SkenHub/2023_Robocon_Bteam/README.md

# 2023_Robocon_Bteam
2023年高専ロボコン「もぎもぎ！フルーツＧＯラウンド」Bチーム
## メンバー
*  機械　ヒロハタ，金子，入谷，斉藤，神鍋 ,今井
*  制御　野口，川崎，笹渕，川口，黒住，佐谷  
*  回路　中井，岩井　
*  1年　北嶋，真志取  
* メイン：野口、川崎，金子
* ピット：渡邉，入谷，北嶋，廣畑，真志取
