SkenHub/2023_Robocon_Bteam/制御/robocon2023_BteamRobot/inc/sken_library/readme(pdf)/gpio.pdf

# gpio

## GPIOピンの⼊出⼒をあつかう

# enum Mode

## ⼊出⼒の設定

# enum PinState

## ⼊出⼒状態

# class Gpio

# void Gpio::init(Pin pin,Mode pin_mode)

## ピンの⼊出⼒設定 デジタル出⼒とデジタル⼊⼒の設定で使⽤する． [パラメータ] ピン番号 ⼊出⼒の設定

## [戻り値]

なし

## [サンプルコード] A5ピンをデジタル出⼒に設定する

LOW
HIGH

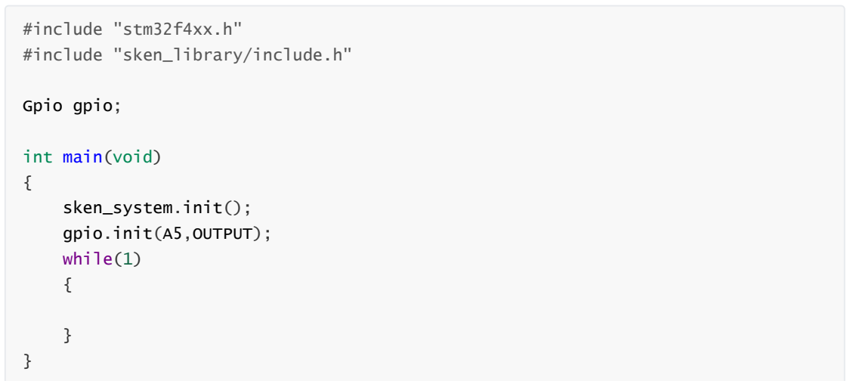
[picture p6: figure]
#include "stm32f4xx.h"; #include "sken_library/include.h"; Gpio gpio;; int main(void); sken_system.init();; gpio.init(A5,OUTPUT);; while(1)

# void Gpio::init(Pin pin,Mode pin_mode,TimerNumber tim_num,TimerChannel tim_ch,int frequency = 16800)

## ピンの⼊出⼒設定 PWM出⼒の設定で使⽤する．

## [パラメータ] ピン番号 ⼊出⼒の設定 タイマー番号 タイマーチャンネル

## PWM周波数

## [戻り値]

なし

## [サンプルコード] A5ピンをPWM出⼒に設定する

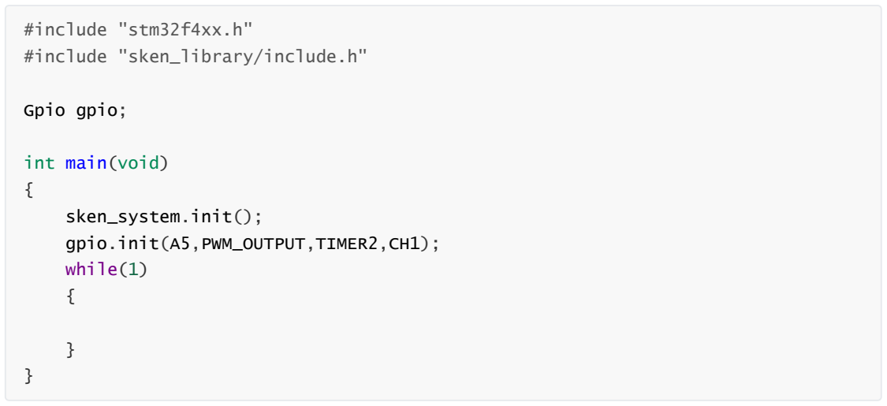
[picture p7: figure]
#include "stm32f4xx.h"; #include "sken_library/include.h"; Gpio gpio;; int main(void); sken_system.init();; gpio.init(A5,PWM_OUTPUT,TIMER2,CH1);; while(1)

# void Gpio::write(PinState state)

## 出⼒に設定している場合，ピンからHIGHまたはLOWを出⼒することができる

## [パラメータ] 出⼒状態 [戻り値]

なし

## [サンプルコード] A5ピンをデジタル出⼒に設定し，HIGHを出⼒する

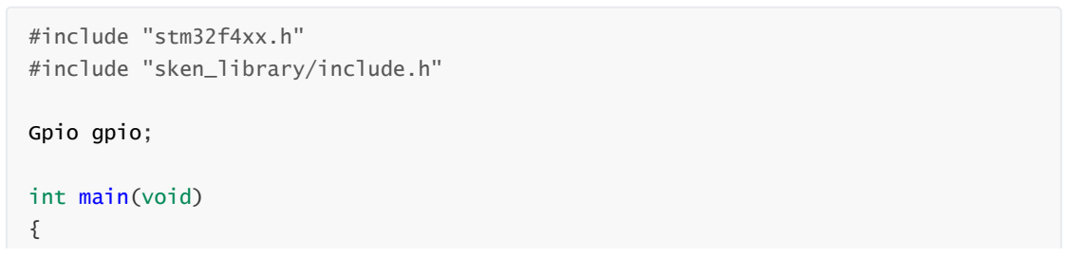
[picture p8: figure]
#include "stm32f4xx.h"; #include "sken_library/include.h"; Gpio gpio;; int main(void)

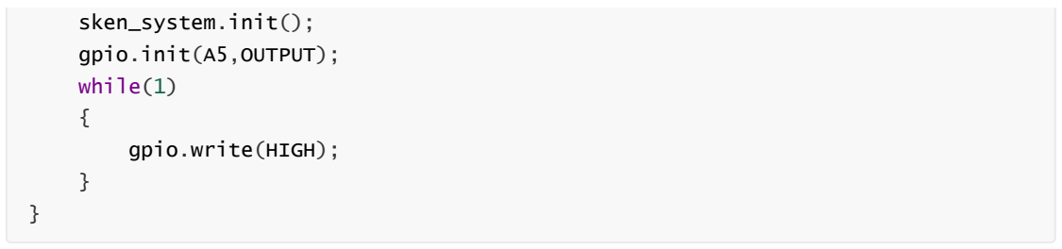
[picture p9: figure]
sken_system.init();; gpio.init(A5,OUTPUT);; while(1); gpio.write(HIGH);

# void Gpio::write(double percentage)

## PWM出⼒に設定されている場合矩形波が出⼒される． ただし，同じタイマーにエンコーダやRCサーボ信号を使⽤している場合はたとえチャンネルが違った としても正しい出⼒が⾏われない． [パラメータ]

出⼒[%]

## [戻り値]

なし

## [サンプルコード] A5ピンから50%のPWMを出⼒する

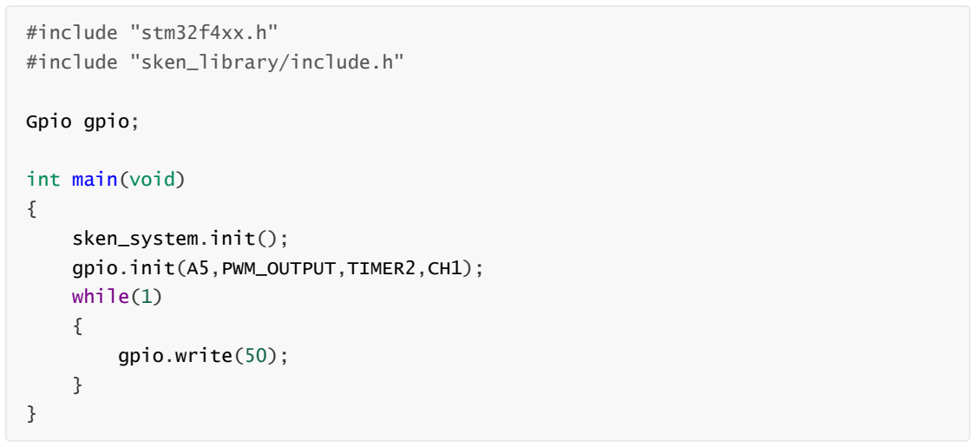
[picture p10: figure]
#include "stm32f4xx.h"; #include "sken_library/include.h"; Gpio gpio;; int main(void); sken_system.init();; gpio.init(A5,PWM_OUTPUT,TIMER2,CH1);; while(1); gpio.write(50);

# bool Gpio::read(void)

## ⼊⼒に設定している場合，ピンの値を読み取ることができる

## [パラメータ]

なし

## [戻り値]

## HIGHのときtrue，LOWのときfalse

## [サンプルコード] C13ピンに接続したスイッチを読む

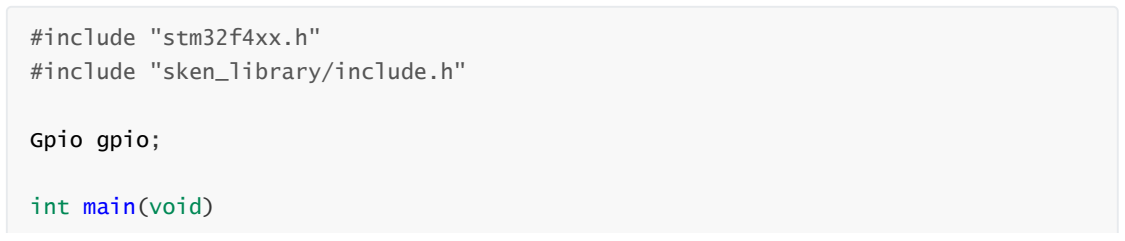
[picture p11: figure]
#include "stm32f4xx.h"; #include "sken_library/include.h"; Gpio gpio;; int main(void)

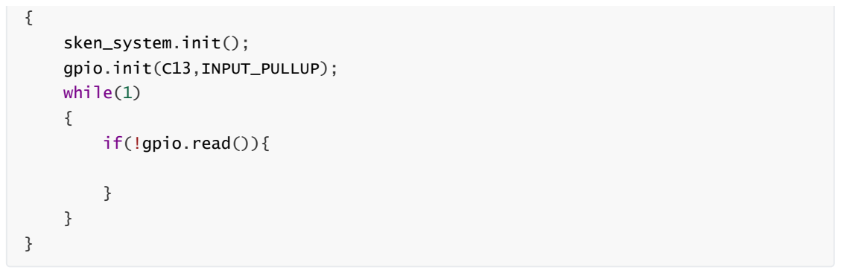
[picture p12: figure]
sken_system.init();; gpio.init(C13,INPUT_PULLUP);; while(1); if(!gpio.read()){
