SkenHub/2023_Robocon_Bteam/制御/robocon2023_BteamRobot/inc/sken_library/readme(pdf)/gyro.pdf

# gyro

## R6093ジャイロを扱うクラス

# enum Cordinate{

}

# struct gyro_data_t{

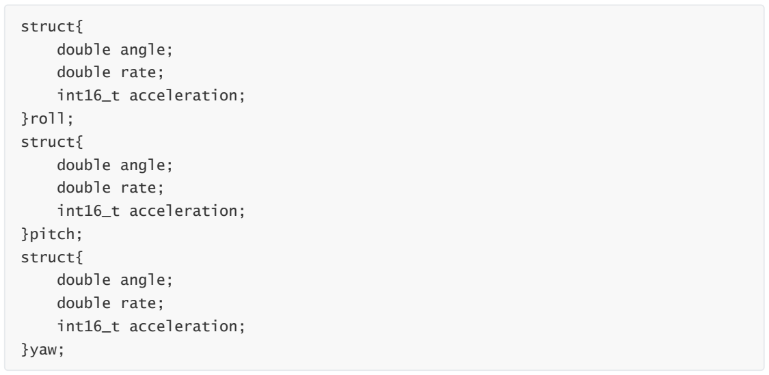
[picture p13: figure]
struct{; double angle;; double rate;; int16_t acceleration;; }roll;; }pitch;; }yaw;

}

# class Gyro

# void Gyro::init(Pin tx_pin,Pin rx_pin,UartNumber uart_num,int connect_dead_time = 1000)

## シリアルピンの設定を⾏う [パラメータ] 送信ピン番号 受信ピン番号 シリアル番号 通信切断時間

## [戻り値]

なし

## [サンプルコード]

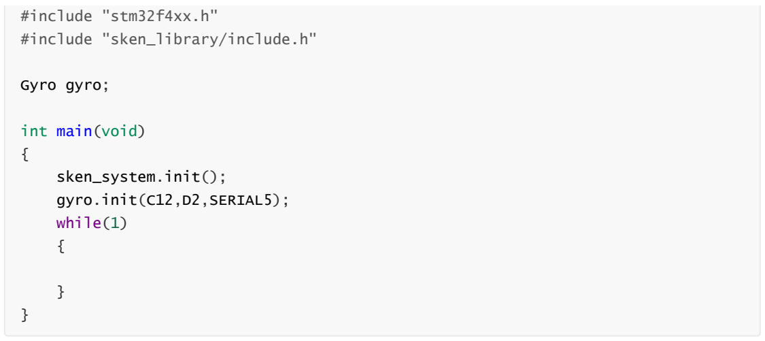
[picture p14: figure]
#include "stm32f4xx.h"; #include "sken_library/include.h"; Gyro gyro;; int main(void); sken_system.init();; gyro.init(C12,D2,SERIAL5);; while(1)

# bool Gyro::update(void)

## ジャイロからのデータを更新する [パラメータ]

なし

## [戻り値] 成功したらtrue，失敗したらfalse [サンプルコード]

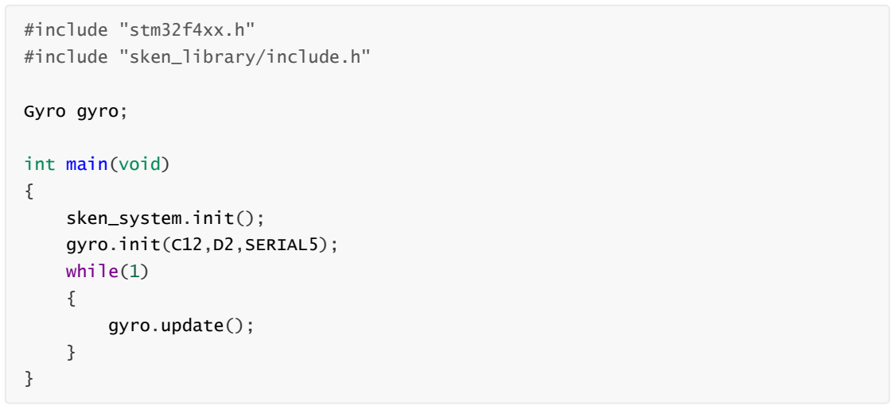
[picture p15: figure]
#include "stm32f4xx.h"; #include "sken_library/include.h"; Gyro gyro;; int main(void); sken_system.init();; gyro.init(C12,D2,SERIAL5);; while(1); gyro.update();

# bool Gyro::resetAngle(Cordinate coordinate)

## ジャイロの⾓度を0度にリセットする

## [パラメータ] リセットする軸 [戻り値] 成功したらtrue，失敗したらfalse [サンプルコード] 1秒ごとにロール軸をリセットする

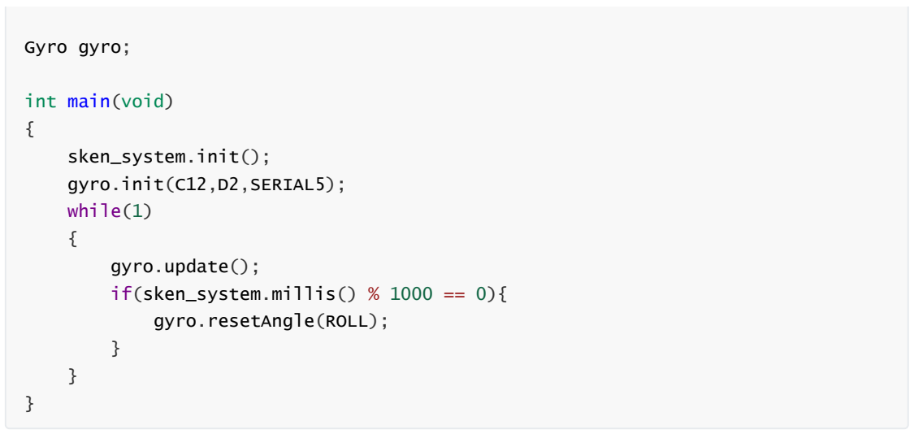
[picture p16: figure]
Gyro gyro;; int main(void); sken_system.init();; gyro.init(C12,D2,SERIAL5);; while(1); gyro.update(); if(sken_system.millis() % 1000 == 0){; gyro.resetAngle(ROLL);

# bool Gyro::getConnectFlag(void)

## 接続確認フラグを取得する [パラメータ]

なし

## [戻り値] 接続していたらtrue，接続していなかったらfalse [サンプルコード]

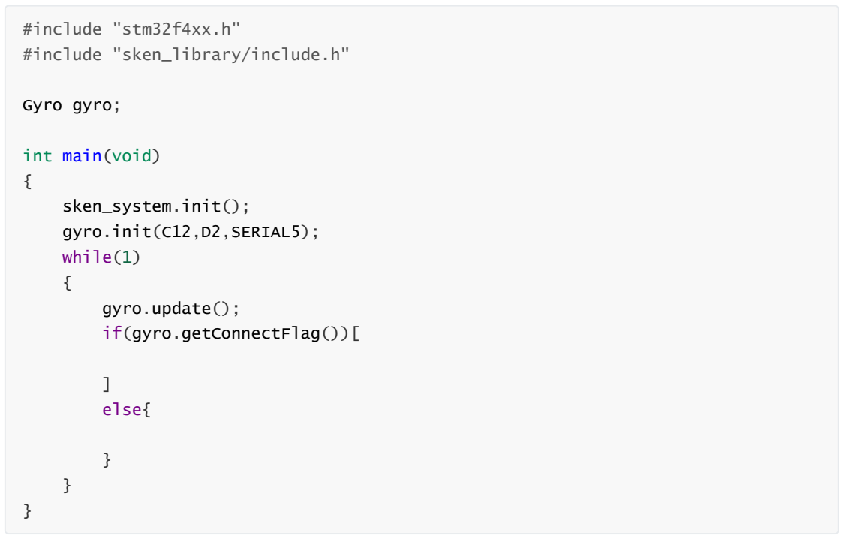
[picture p17: figure]
#include "stm32f4xx.h"; #include "sken_library/include.h"; Gyro gyro;; int main(void); sken_system.init();; gyro.init(C12,D2,SERIAL5);; while(1); gyro.update(); if(gyro.getConnectFlag())[; else{

# gyro_data_t Gyro::getData(void)

## ⾓度等のデータを取得する

## [パラメータ]

なし

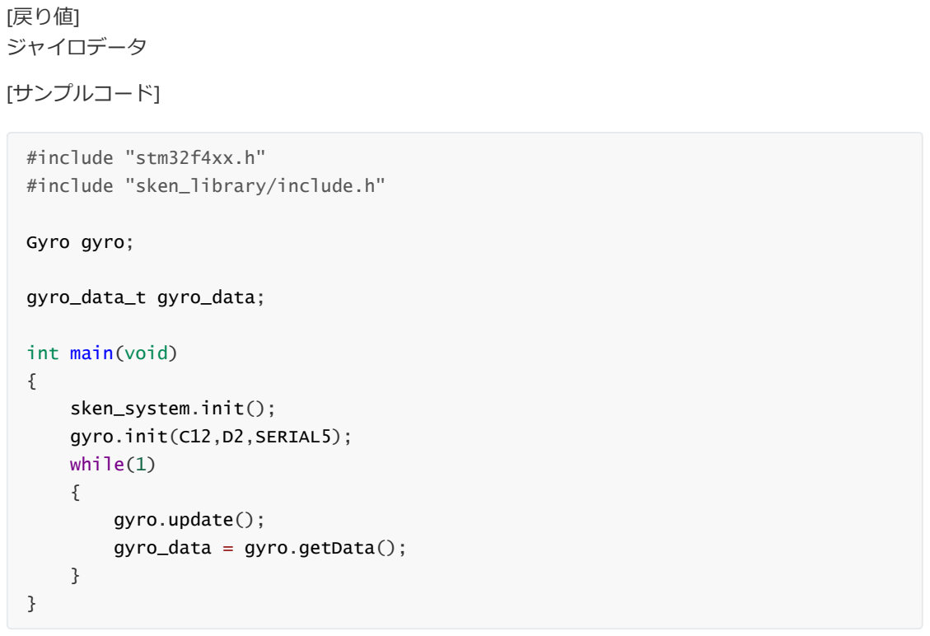
[picture p18: figure]
[戻り値] ジャイロデータ; [サンプルコード]; #include "stm32f4xx.h"; #include "sken_library/include.h"; Gyro gyro;; gyro_data_t gyro_data;; int main(void); sken_system.init();; gyro.init(C12,D2,SERIAL5);; while(1); gyro.update();; gyro_data = gyro.getData();
