SkenHub/2023_Robocon_Bteam/制御/robocon2023_BteamRobot/inc/sken_library/readme(pdf)/rc_pwm.pdf

# rc_pwm

## 周期20[ms]のラジコンサーボ信号を制御するクラス．

# class RcPwm

# void RcPwm::init(Pin pin,TimerNumber tim_num,TimerChannel tim_ch)

## ピンとタイマーの設定を⾏う [パラメータ] ピン番号 タイマー番号 タイマーチャンネル

## [戻り値]

なし

## [サンプルコード]

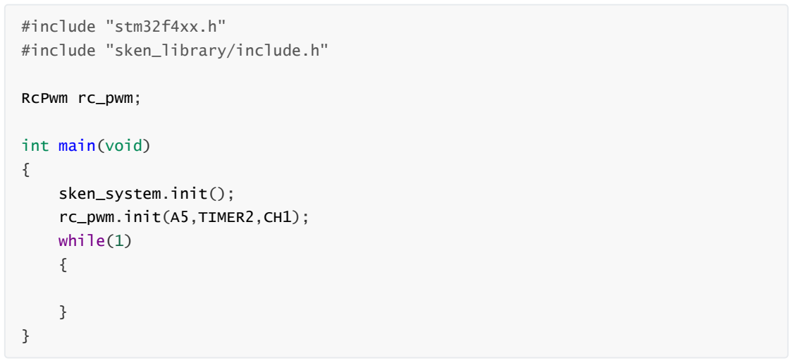
[picture p32: figure]
#include "stm32f4xx.h"; #include "sken_library/include.h"; RcPwm rc_pwm;; int main(void); sken_system.init();; rc_pwm.init(A5,TIMER2,CH1);; while(1)

# void RcPwm::turn(double percentage)

## 出⼒の割合を設定する関数

## [パラメータ]

## 出⼒割合(1000[us]から2000[us]の間を0[%]から100[%]で設定)

## [戻り値]

なし

## [サンプルコード]

## 20[%] (1200[us])で出⼒する

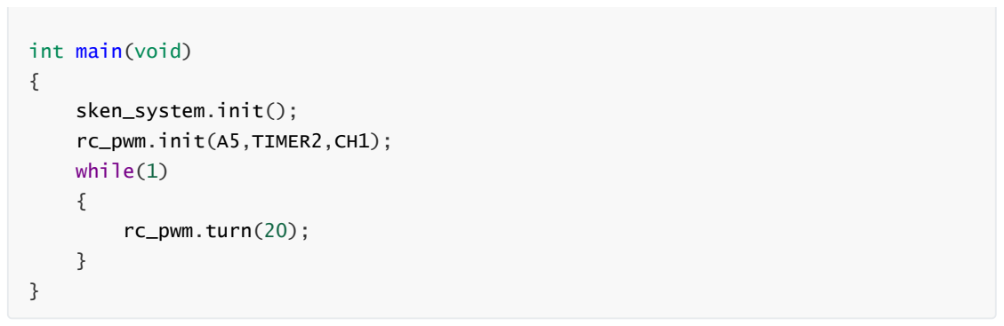
[picture p33: figure]
int main(void); sken_system.init();; rc_pwm.init(A5,TIMER2,CH1);; while(1); rc_pwm.turn(20);
