SkenHub/2023_Robocon_Bteam/機械/sato_90deg/90_MEC3.stp

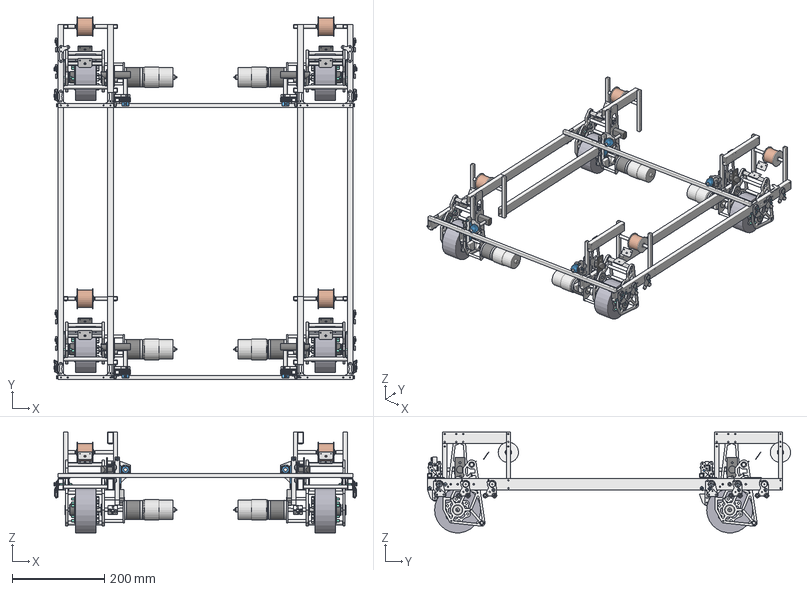
[picture p53: CAD file, 2023-06-14]
機械/sato_90deg/90_MEC3.stp
657.0 x 787.5 x 218.2 mm
25kk_1
25kk_2 x 2
T5_suraida x 4
Pr_lack x 4
9kk_suraida x 4
6_10F x 16
POM_suraido x 4
Jk8_dornob x 8
Jk6_suraida x 16
Pr_gear x 4
T3_roller x 2
T5_roller x 4
定荷重ば0 x 4
Jk8_teikajyu x 4
T5_kyapp x 12
T3_suraido x 4
T3_doanobu x 4
9kk_mota x 12
T3_roller2 x 4
ドア1 x 4
T3_doanobu2 x 4
25kk_ue x 4
Ji8_sutoppa x 4
printe_parts x 28
POM_slider2 x 4
T2_neji x 4
POM_slider x 4
sara_M4_25mm x 4
Jk6_bea x 8
Jk8_suraido x 4
T2_kado2 x 5
25kk_3 x 2
メカd x 4
T3_motor2 x 8
G2 x 4
G1 x 4
G3 x 4
RS-775 x 4
T3_motamaunt x 4
UA-20C-8X8 x 2
Jk6_mota x 12
Jk8_mota3 x 4
T2_sasae x 4
T2_sasae2 x 4
set_color8 x 4
M5_55 x 24
pp8-10_sp x 4
Jk6_2 x 8
Jk10_teikajyu x 4
定荷重ばね_3 x 4
Jk8_kaiten x 4
UA-20C-8X8_mir1 x 2
25kk_1_mir1
T3_roller_mir2 x 2
T3_roller2_mir2 x 4
T2_kado2_mir2 x 5
9kk_yoko x 2
