SkenHub/2023_Robocon_Bteam/機械/部品図/J指示書2.pdf

200 | 351 | 200
| 7.5 8.5

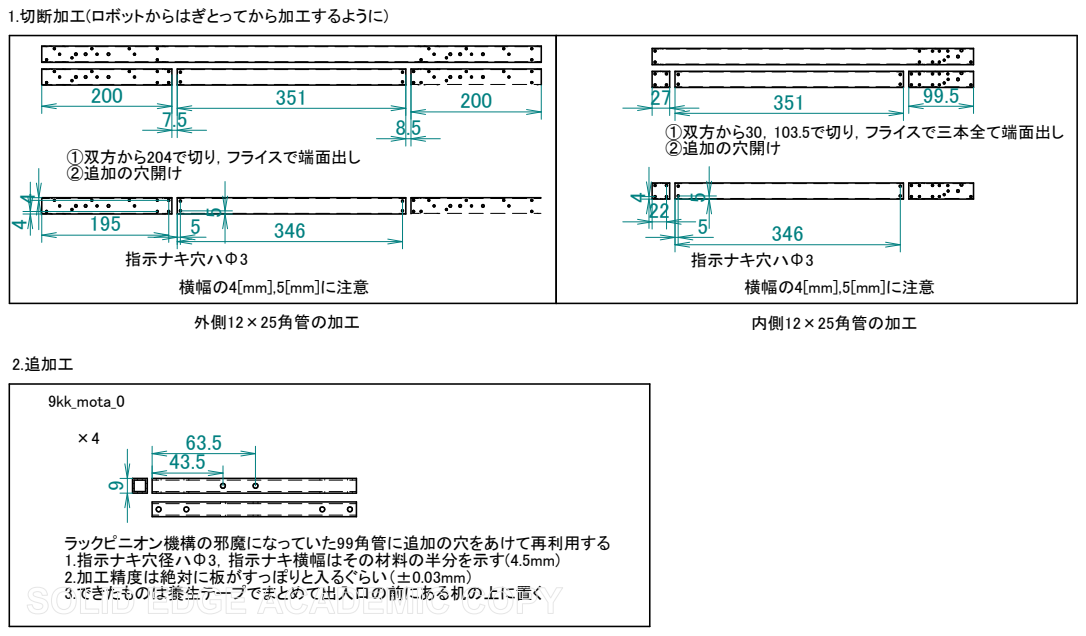
[picture p54: page 1]
1.切断加工(ロボットからはぎとってから加工するように); ①双方から204で切り，フライスで端面出し ②追加の穴開け; 指示ナキ穴ハΦ3; ①双方から30，103.5で切り，フライスで三本全て端面出し ②追加の穴開け; 外側12×25角管の加工; 内側12×25角管の加工; 2.追加工; 9kk_mota_0; ラックピニオン機構の邪魔になっていた99角管に追加の穴をあけて再利用する 1.指示ナキ穴径ハΦ3，指示ナキ横幅はその材料の半分を示す(4.5mm) 2.加工精度は絶対に板がすっぽりと入るぐらい（±0.03mm） 3.できたものは養生テープでまとめて出入口の前にある机の上に置く

横幅の4[mm],5[mm]に注意
