SkenHub/2023_Robocon_Bteam/機械/部品図/部品図J3A1.pdf

430

445

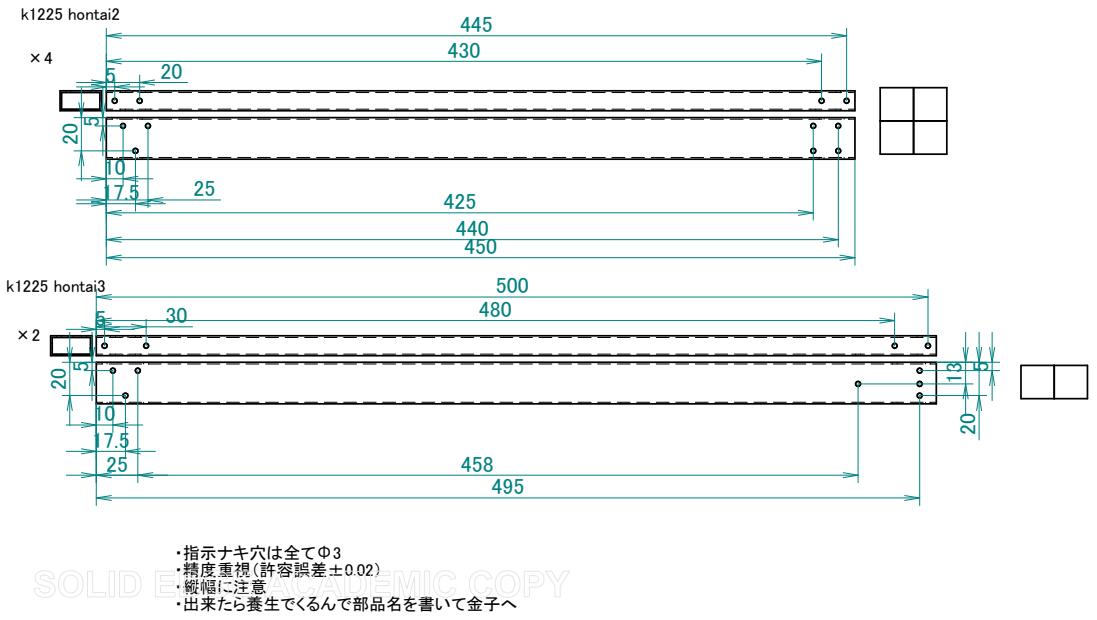
[picture p57: page 1]
k1225 hontai25; k1225 hontai35; ・指示ナキ穴は全てΦ3 ・精度重視（許容誤差±0.02） ・縦幅に注意 ・出来たら養生でくるんで部品名を書いて金子へ
