SkenHub/2023_Robocon_Bteam/機械/部品図/部品図J3A2.pdf

15

60

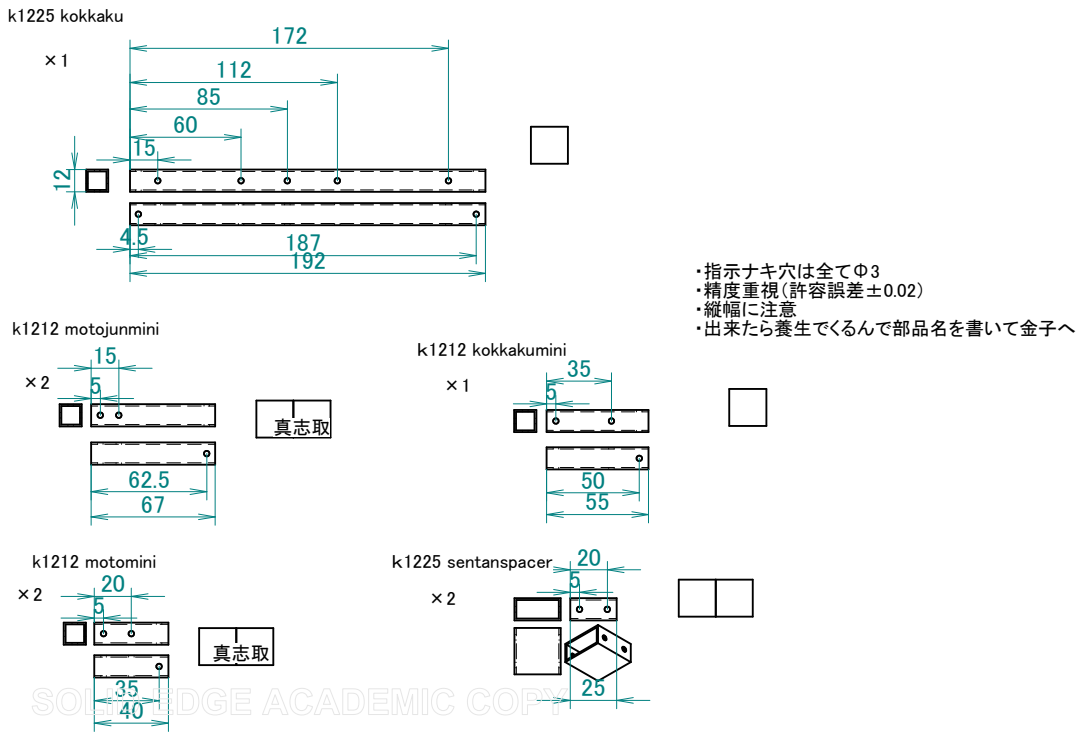
[picture p58: page 1]
k1225 kokkaku; k1212 motojunmini; ・指示ナキ穴は全てΦ3 ・精度重視（許容誤差±0.02） ・縦幅に注意 ・出来たら養生でくるんで部品名を書いて金子へ; k1212 motomini; ｋ1212 kokkakumini; ｋ1225 sentanspacer; 真志取
