SkenHub/2023_Robocon_Bteam/機械/部品図/部品図J3A3.pdf

71.5

119.6

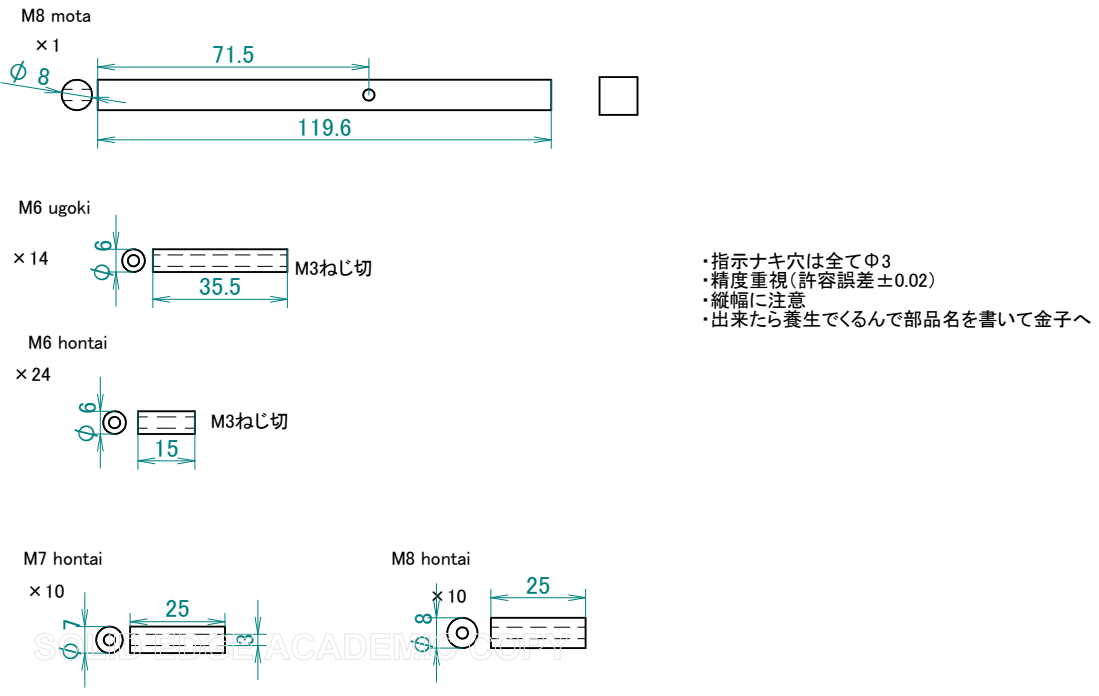
[picture p59: page 1]
M8 mota; M6 hontai; ・指示ナキ穴は全てΦ3 ・精度重視（許容誤差±0.02） ・縦幅に注意 ・出来たら養生でくるんで部品名を書いて金子へ; M7 hontai; M8 hontai; M6 ugoki; M3ねじ切
