SkenHub/2023_Robocon_Bteam/機械/部品図/J指示書3.pdf

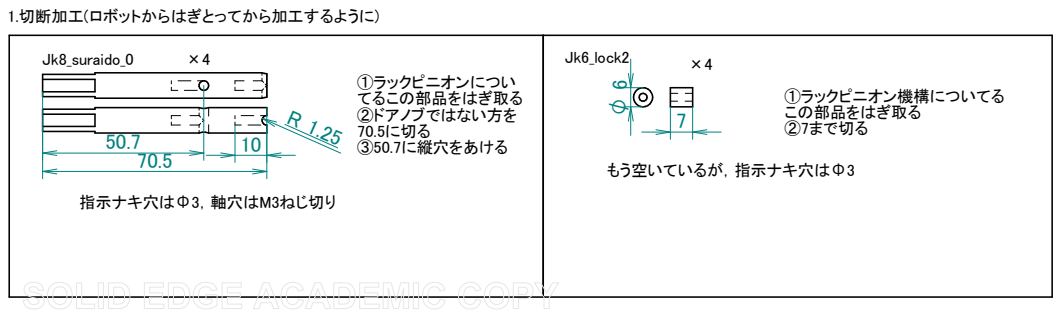
[picture p60: page 1]
1.切断加工(ロボットからはぎとってから加工するように); Jk8_suraido_0; ①ラックピニオンについ てるこの部品をはぎ取る ②ドアノブではない方を 70.5に切る ③50.7に縦穴をあける; 指示ナキ穴はΦ3，軸穴はM3ねじ切り; Jk6_lock2; ①ラックピニオン機構についてる この部品をはぎ取る ②7まで切る; もう空いているが，指示ナキ穴はΦ3
