SkenHub/2023_Robocon_Bteam/機械/部品図/J部品図1.pdf

## 95.5 O

3

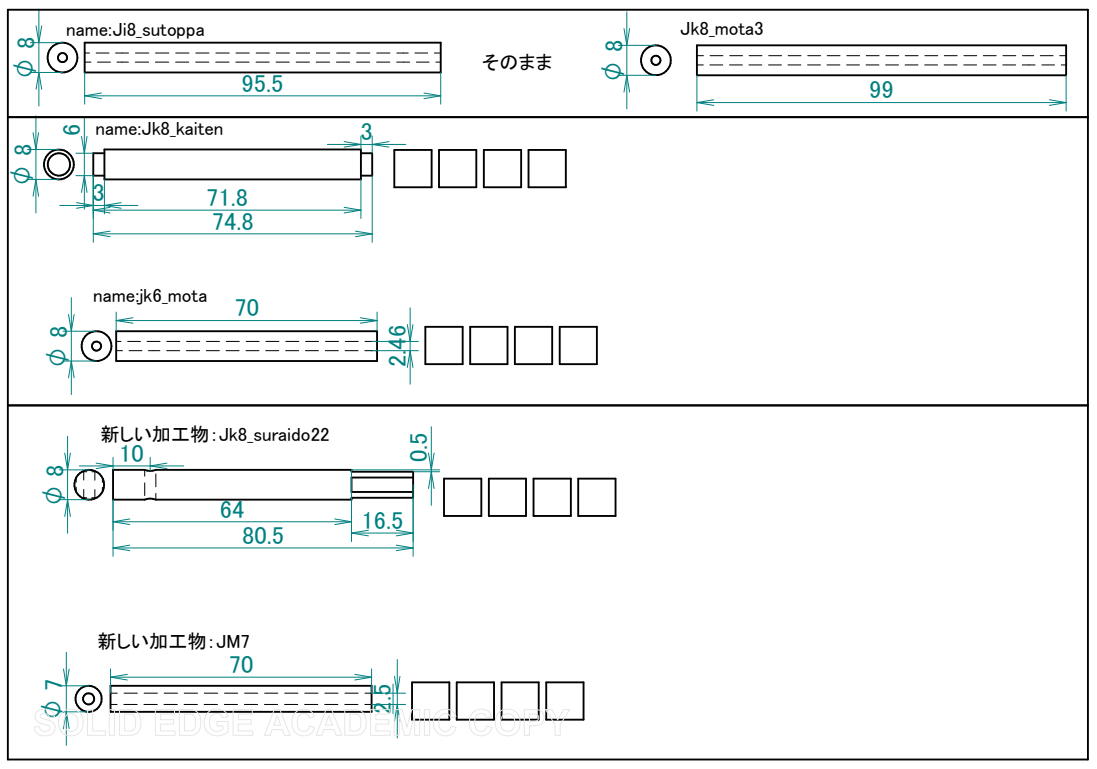
[picture p61: page 1]
name:Ji8_sutoppa; そのまま; name:Jk8_kaiten; 新しい加工物：JM7; 70 name:jk6_mota; 新しい加工物：Jk8_suraido22; Jk8_mota3
