SkenHub/2023_Robocon_Bteam/機械/部品図/9_9_2.pdf

6
21

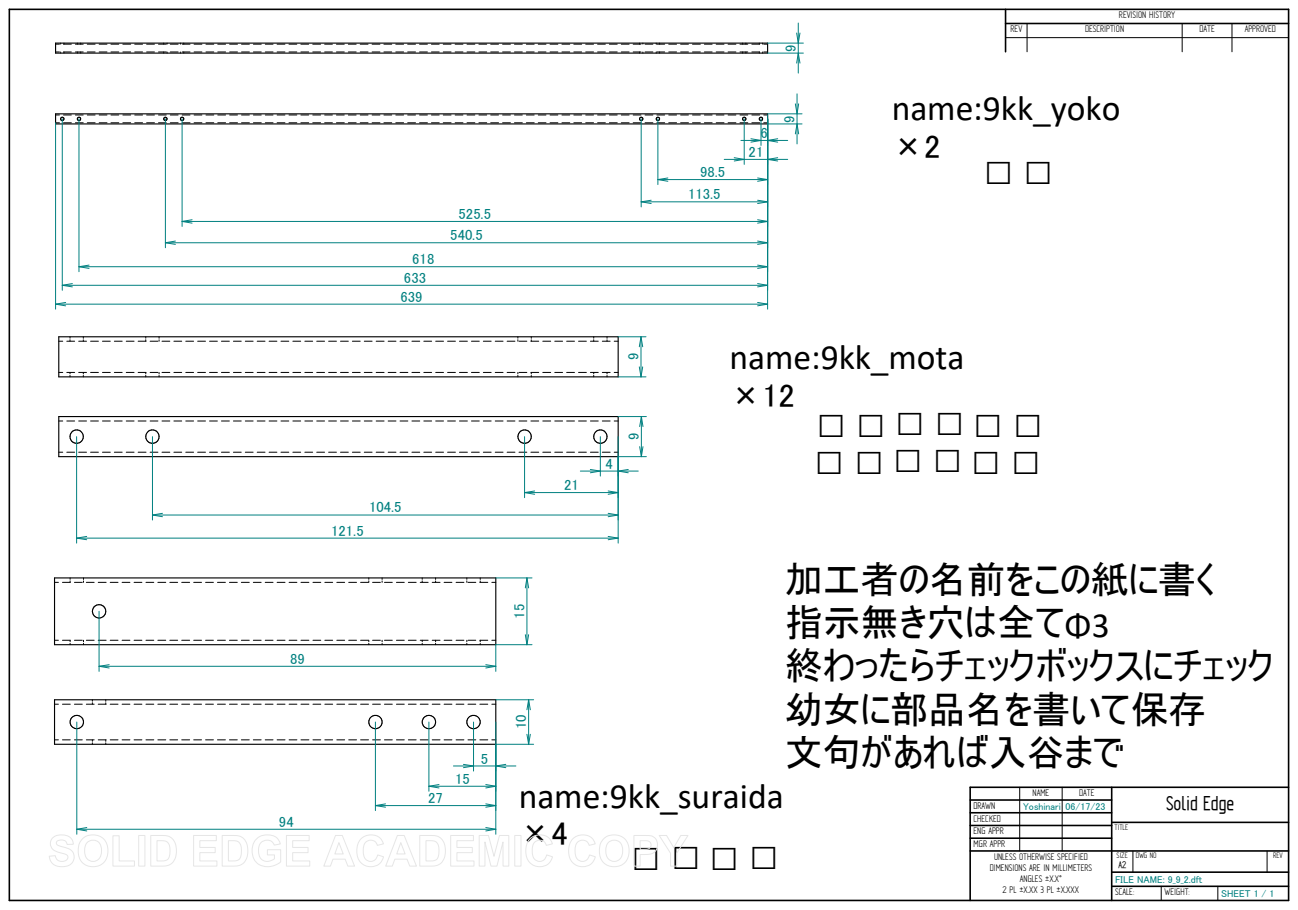
[picture p62: page 1]
NAME; DATE; Solid Edge; TITLE; SCALE:; WEIGHT:; SHEET 1 / 1; name:9kk_yoko ×2; 加加加の名名ををの紙に書く 指指指き穴は全てΦ3 終わわわわわわわわわわわわにわわわわ 幼幼に部部名を書いて保保 文文がががが入入まま; name:9kk_mota ×12; name:9kk_suraida ×4

REVISION HISTORY

REV | DESCRIPTION | DATE | APPROVED

DRAWN | Yoshinari
CHECKED
ENG APPR
MGR APPR
UNLESS OTHERWISE SPECIFIED DIMENSIONS ARE IN MILLIMETERS ANGLES ±X.X° 2 PL ±X.XX 3 PL ±X.XXX | SIZE A2 | DWG NO | REV

FILE NAME: 9_9_2.dft
