SkenHub/2023_Robocon_Bteam/機械/部品図/12_25_6.pdf

56
76

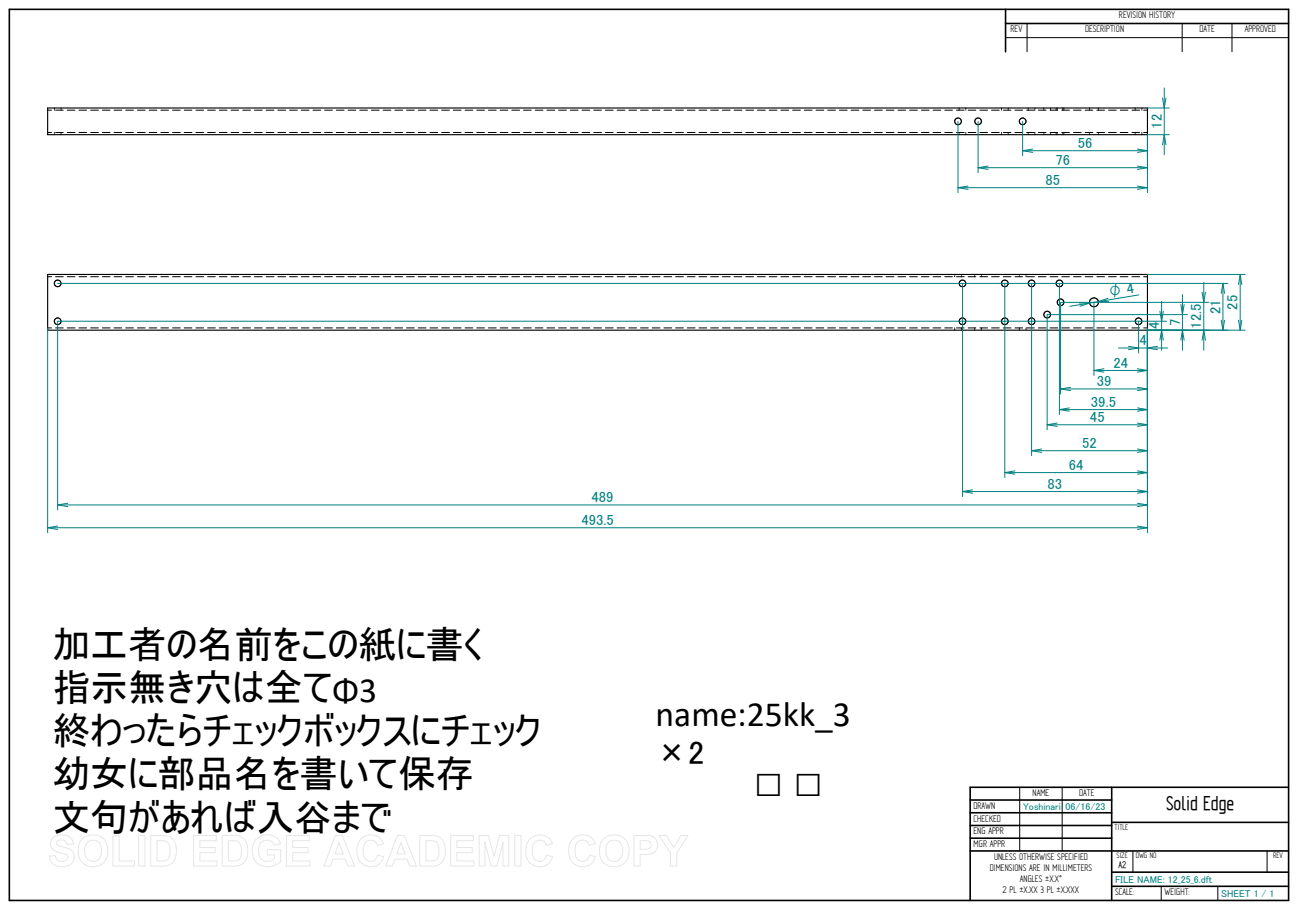
[picture p63: page 1]
TITLE; SCALE:; WEIGHT:; SHEET 1 / 1; 加加加の名名ををの紙に書く 指指指き穴は全てΦ3 終わわわわわわわわわわわわにわわわわ 幼幼に部部名を書いて保保 文文がががが入入まま; name:25kk_3 ×2

REVISION HISTORY

REV | DESCRIPTION | DATE | APPROVED

NAME | DATE 06/16/23 | Solid Edge

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

FILE NAME: 12_25_6.dft
