SkenHub/2023_Robocon_Bteam/機械/部品図/12_25_8.pdf

4.5
579.5 | 13.5 33.5

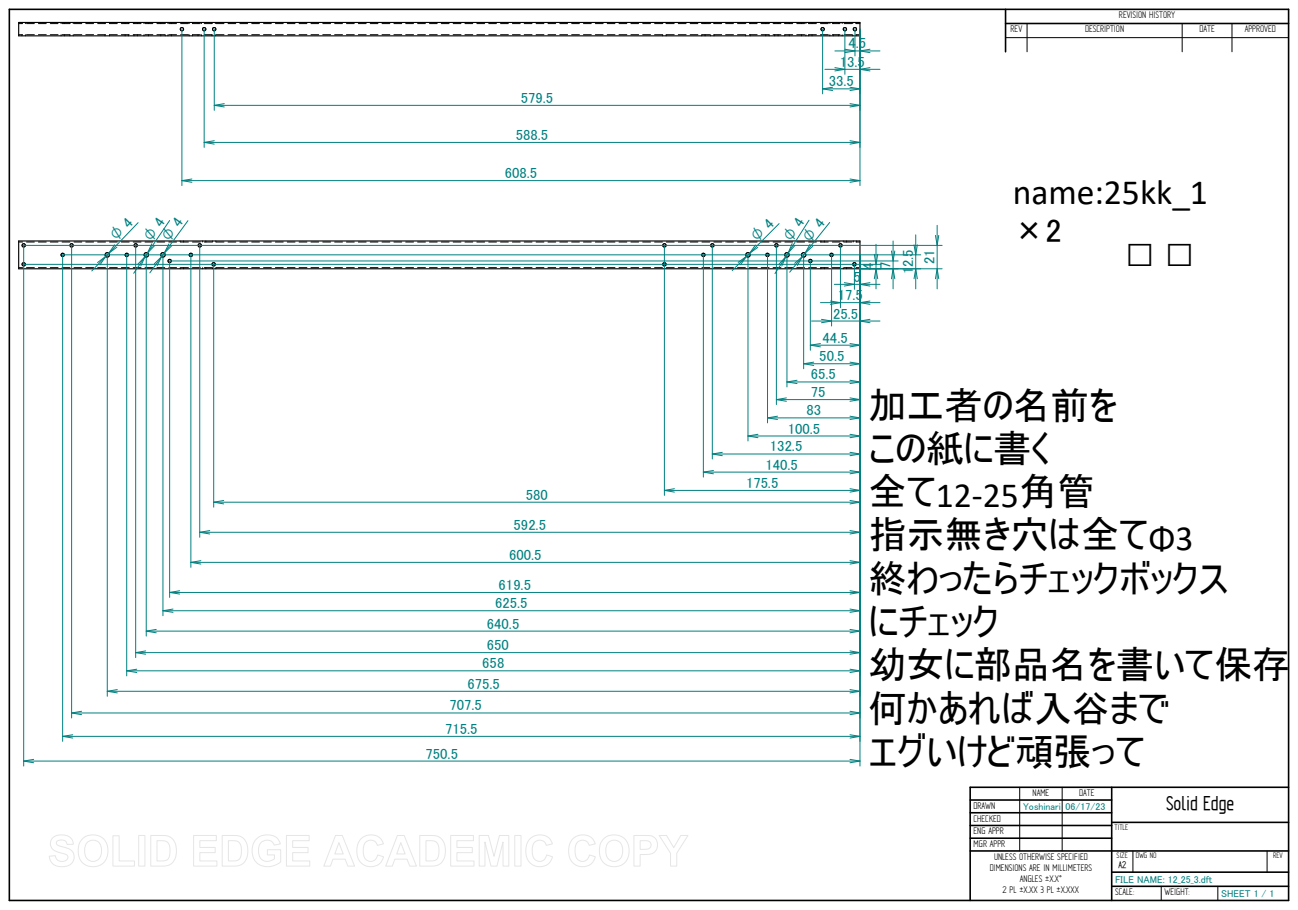
[picture p64: page 1]
TITLE; SCALE:; WEIGHT:; SHEET 1 / 1; 加加加の名名を この紙に書く; 指指指き穴は全てΦ3 終わわわわわわわわわわわわ にわわわわ 幼幼に部部名を書いて保保 何かかかか入入まま エエいエエ頑頑わて; name:25kk_1 ×2

REVISION HISTORY

REV | DESCRIPTION | DATE | APPROVED

NAME | DATE 06/17/23 | Solid Edge

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

FILE NAME: 12_25_3.dft
