SkenHub/2023_Robocon_Bteam/機械/部品図/jk6.pdf

78.5

7

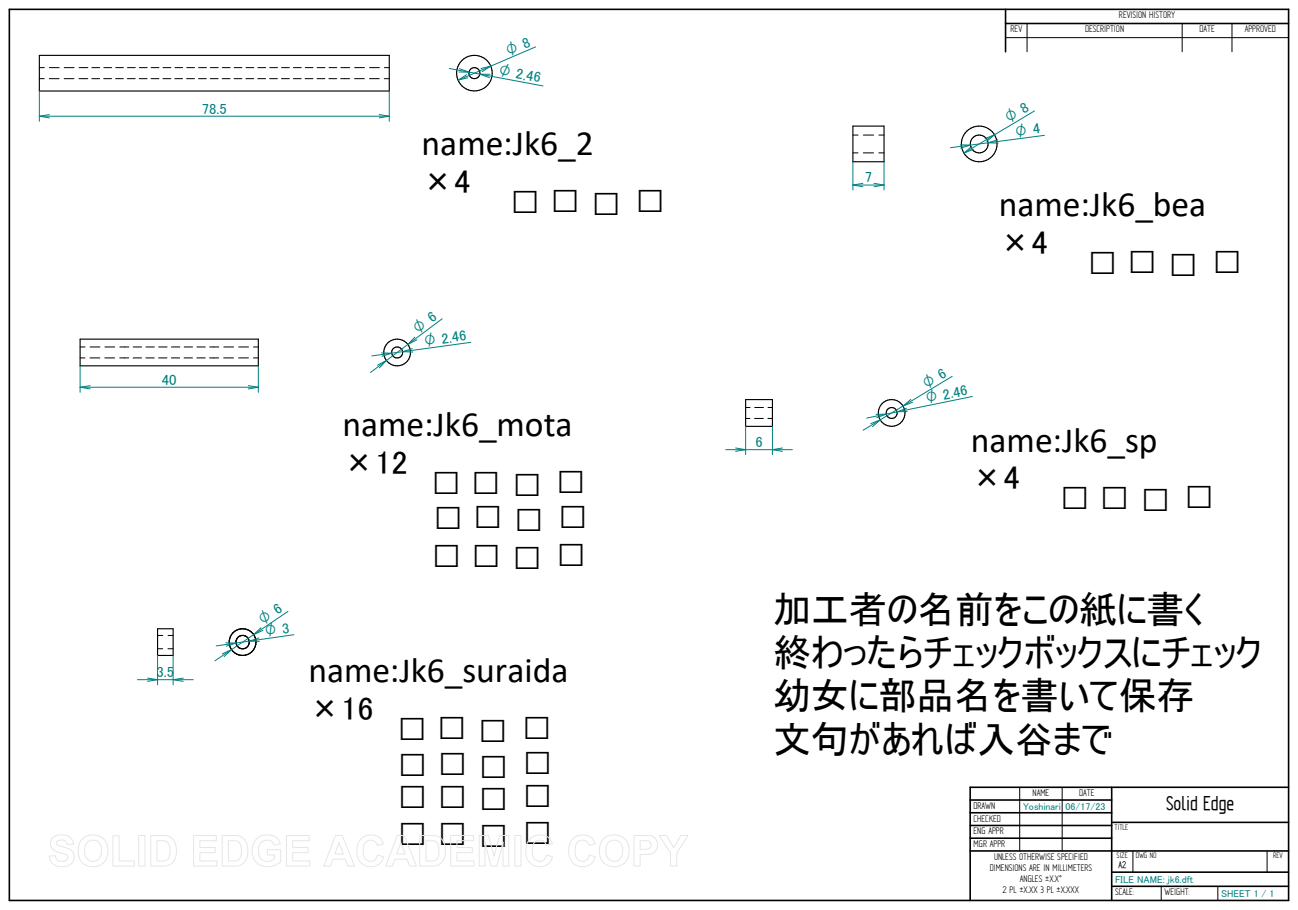
[picture p65: page 1]
TITLE; SCALE:; WEIGHT:; SHEET 1 / 1; 加加加の名名ををの紙に書く 終わわわわわわわわわわわわにわわわわ 幼幼に部部名を書いい保保 文文がががが入入まま; name:Jk6_2; name:Jk6_bea; name:Jk6_sp; name:Jk6_mota ×12 q q q q; name:Jk6_suraida ×16 q q q q

REVISION HISTORY

REV | DESCRIPTION | DATE | APPROVED

NAME | DATE 06/17/23 | Solid Edge

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

FILE NAME: jk6.dft
