SkenHub/2023_Robocon_Bteam/機械/部品図/jk8.pdf

95.5

12

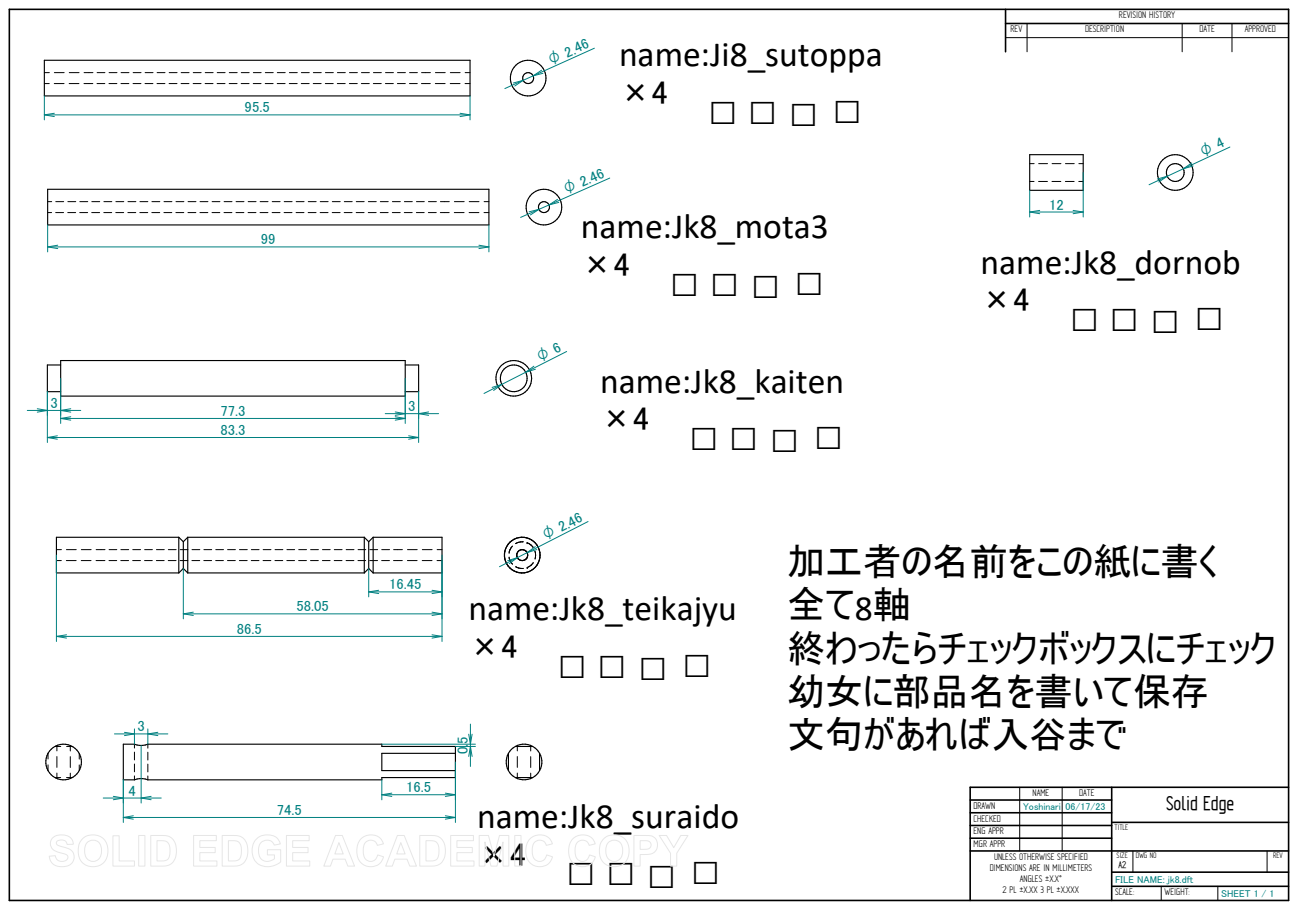
[picture p66: page 1]
TITLE; SCALE:; WEIGHT:; SHEET 1 / 1; 加加加の名名ををの紙に書く 全て 軸8 終わわわわわわわわわわわわにわわわわ 幼幼に部部名を書いて保保 文文がががが入入まま; name:Ji8_sutoppa; name:Jk8_mota3; name:Jk8_dornob ×4; name:Jk8_kaiten; name:Jk8_teikajyu; name:Jk8_suraido

REVISION HISTORY

REV | DESCRIPTION | DATE | APPROVED

NAME | DATE 06/17/23 | Solid Edge

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

FILE NAME: jk8.dft
