SkenHub/2023_Robocon_Bteam/機械/部品図/12-25_2.pdf

180
292

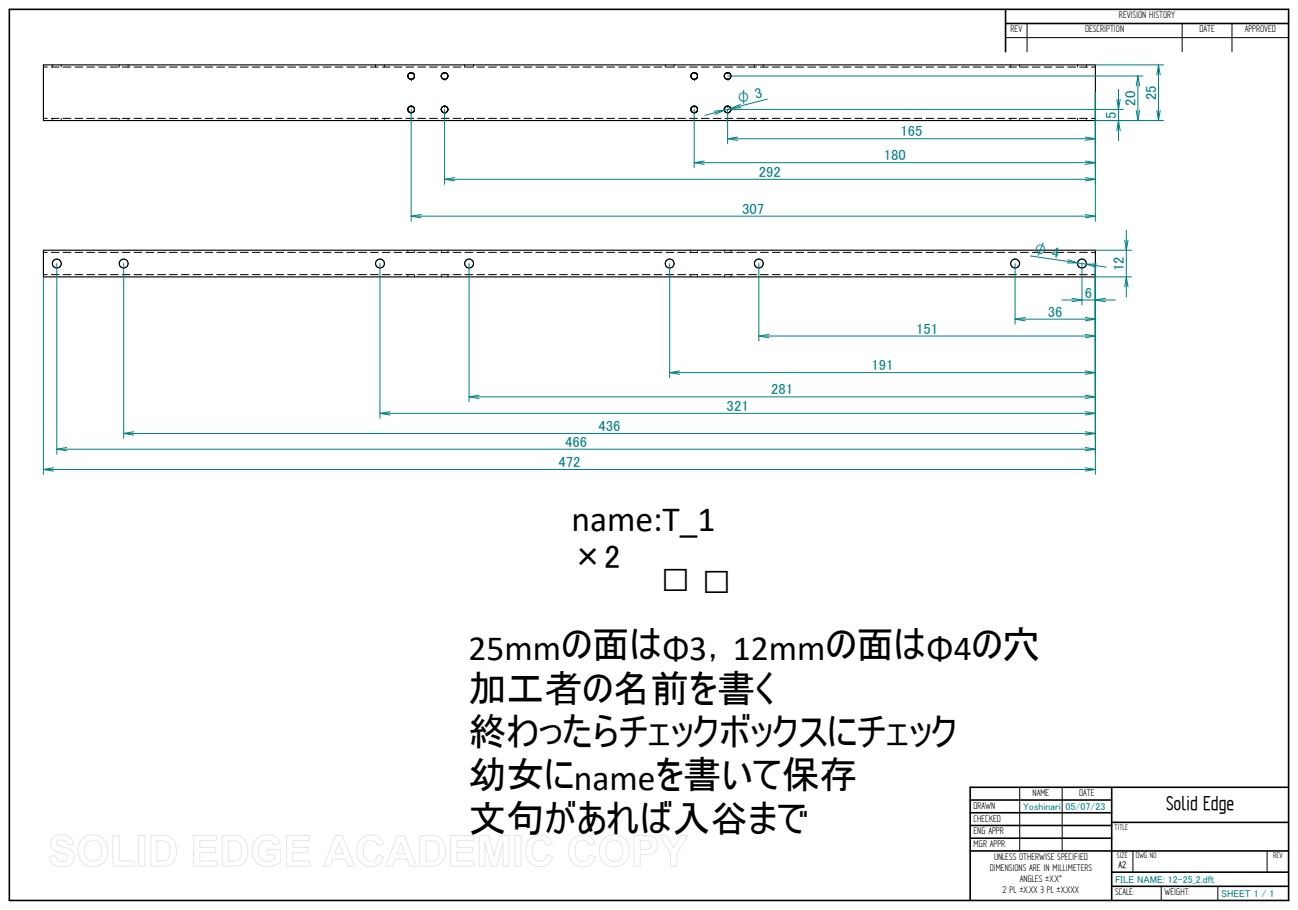
[picture p67: page 1]
TITLE; SCALE:; WEIGHT:; SHEET 1 / 1; name:T_1 ×2; Φ4 の面は ，; の面は の穴; 加加加の名名を書く 終わわわわわわわわわわわわわわわわわ; 幼幼わ; を書いい保保 name; 文文がががが入入まま

REVISION HISTORY

REV | DESCRIPTION | DATE | APPROVED

NAME | DATE 05/07/23 | Solid Edge

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

FILE NAME: 12-25_2.dft
