SkenHub/2023_Robocon_Bteam/機械/部品図/12_12.pdf

31

5

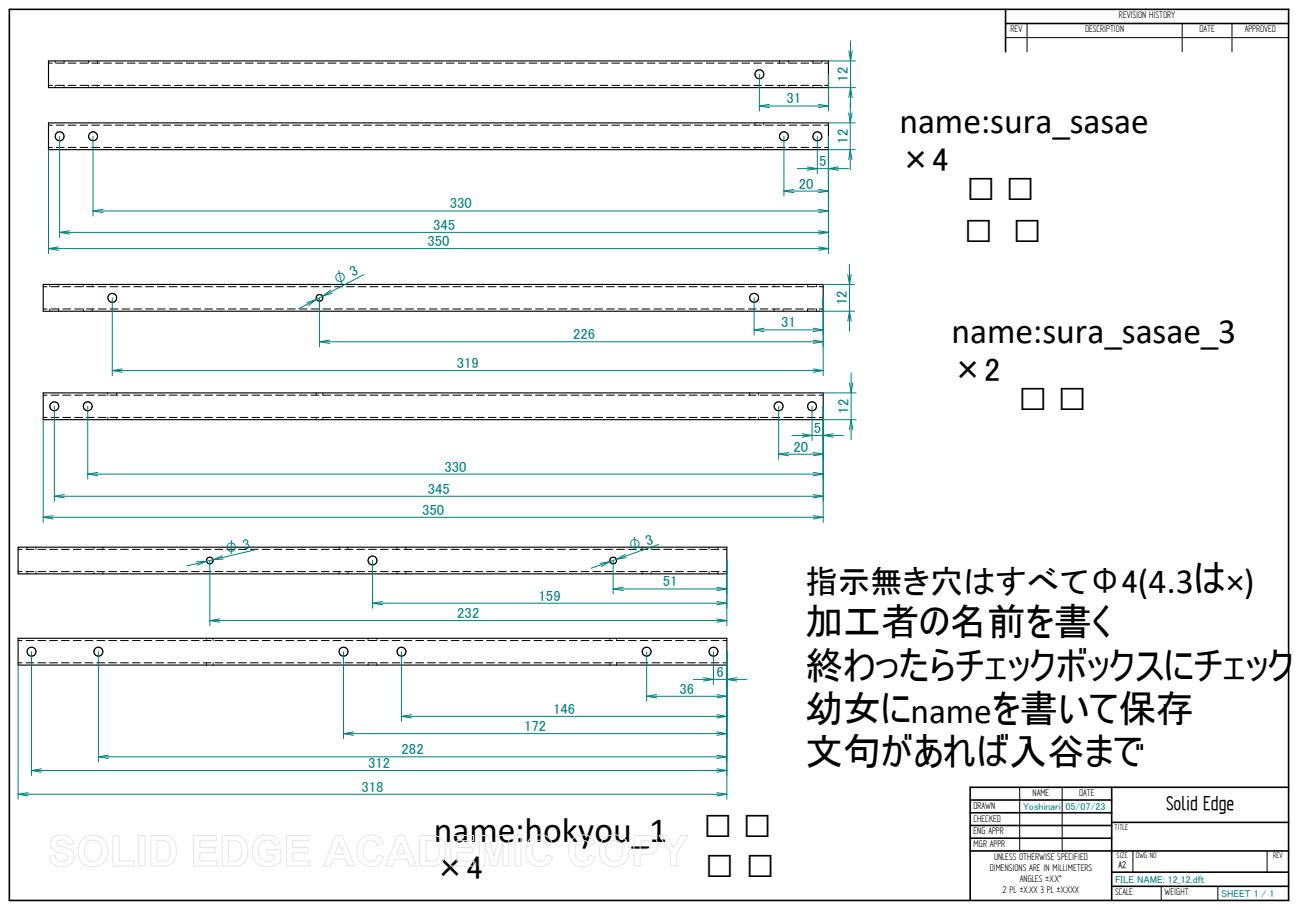
[picture p68: page 1]
TITLE; name:sura_sasae ×4; 指示無き穴はすべてΦ4(4.3 ×) は 加加加の名名を書く 終わわわわわわわわわわわわわわわわわ; 幼幼わ; を書いい保保 name; 文文がががが入入まま; name:sura_sasae_3

REVISION HISTORY

REV | DESCRIPTION | DATE | APPROVED

NAME | DATE 05/07/23 | Solid Edge

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

name:hokyou_1

FILE NAME: 12_12.dft

SCALE: | WEIGHT: | SHEET 1 / 1
