SkenHub/2023_Robocon_Bteam/機械/部品図/12_12_3.pdf

6
355.25

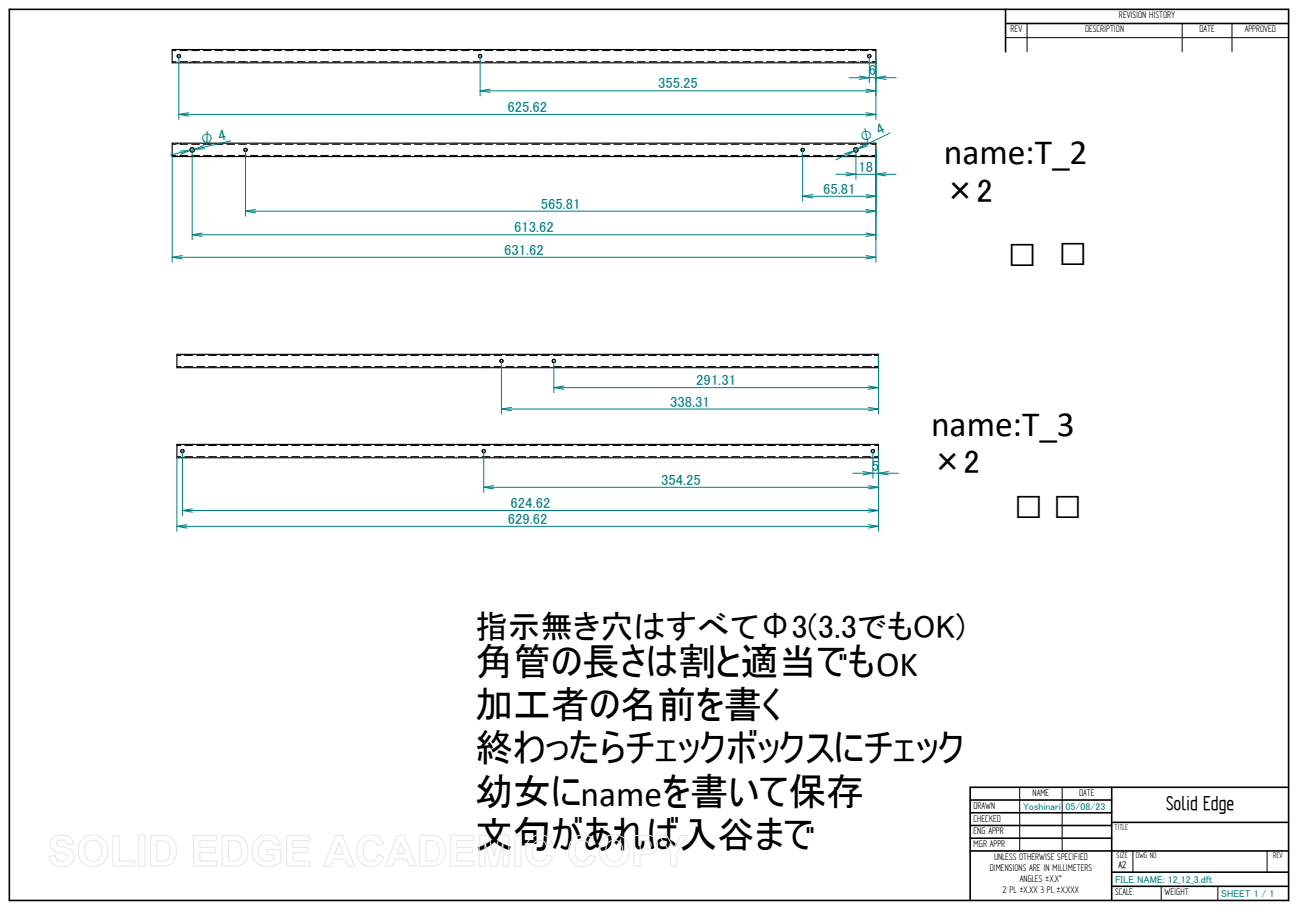
[picture p69: page 1]
TITLE; SCALE:; WEIGHT:; SHEET 1 / 1; 指示無き穴はすべてΦ3(3.3でもOK) 角角の長ささ割と適適ででOK 加加加の名名を書く 終わわわわわわわわわわわわわわわわわ; 幼幼わ; を書いい保保 name; 文文がががが入入まで; name:T_3 ×2; name:T_2 ×2

REVISION HISTORY

REV | DESCRIPTION | DATE | APPROVED

NAME | DATE 05/08/23 | Solid Edge

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

FILE NAME: 12_12_3.dft
