SkenHub/2023_Robocon_Bteam/機械/部品図/12_25.pdf

6
87

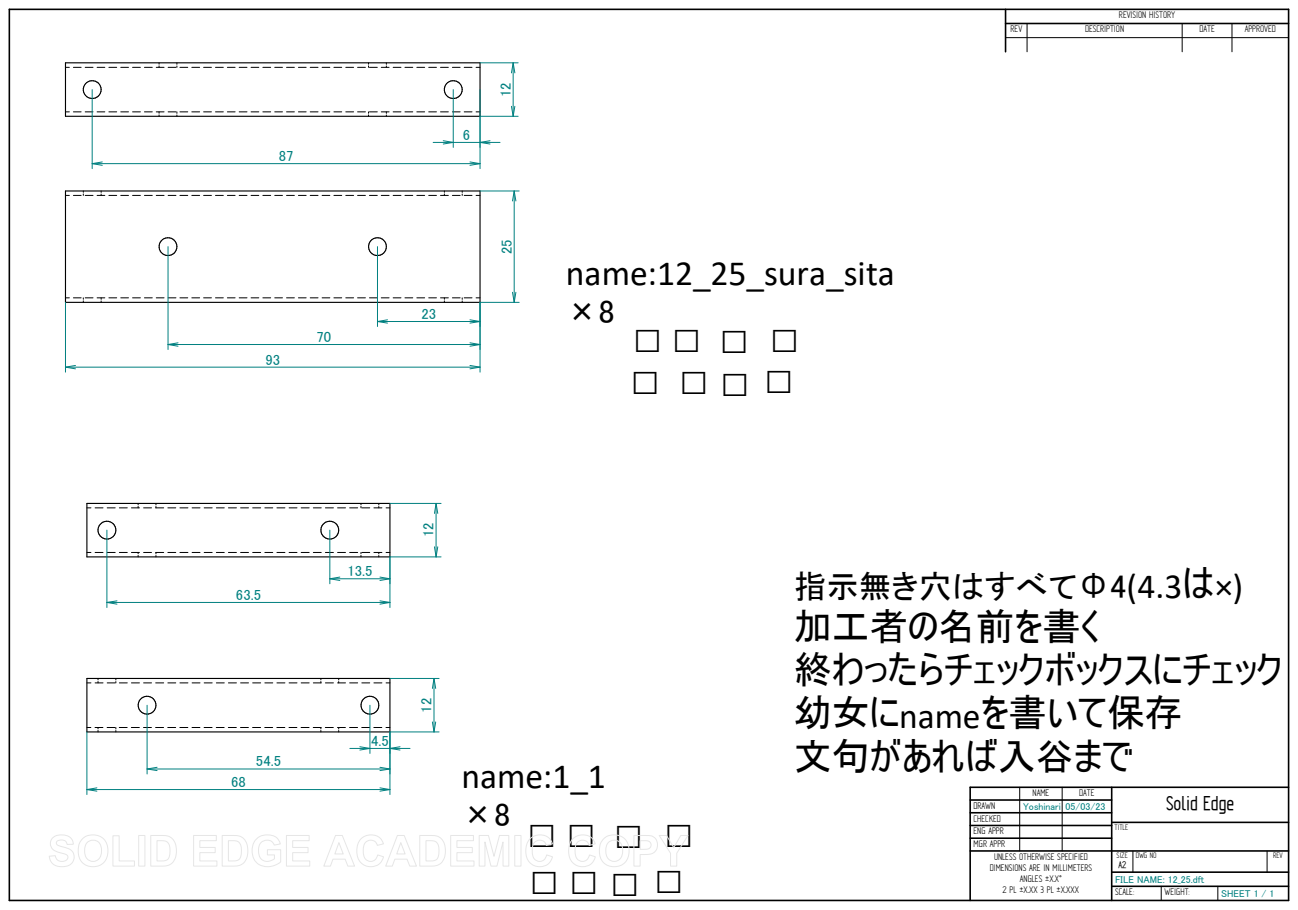
[picture p70: page 1]
TITLE; SCALE:; WEIGHT:; SHEET 1 / 1; 指示無き穴はすべてΦ4(4.3 ×) は 加加加の名名を書く 終わわわわわわわわわわわわわわわわわ; 幼幼わ; を書いい保保 name; 文文がががが入入まま; name:12_25_sura_sita ×8; name:1_1 ×8

REVISION HISTORY

REV | DESCRIPTION | DATE | APPROVED

NAME | DATE 05/03/23 | Solid Edge

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

FILE NAME: 12_25.dft
