SkenHub/2023_Robocon_Bteam/機械/部品図/12_25_4.pdf

18
99

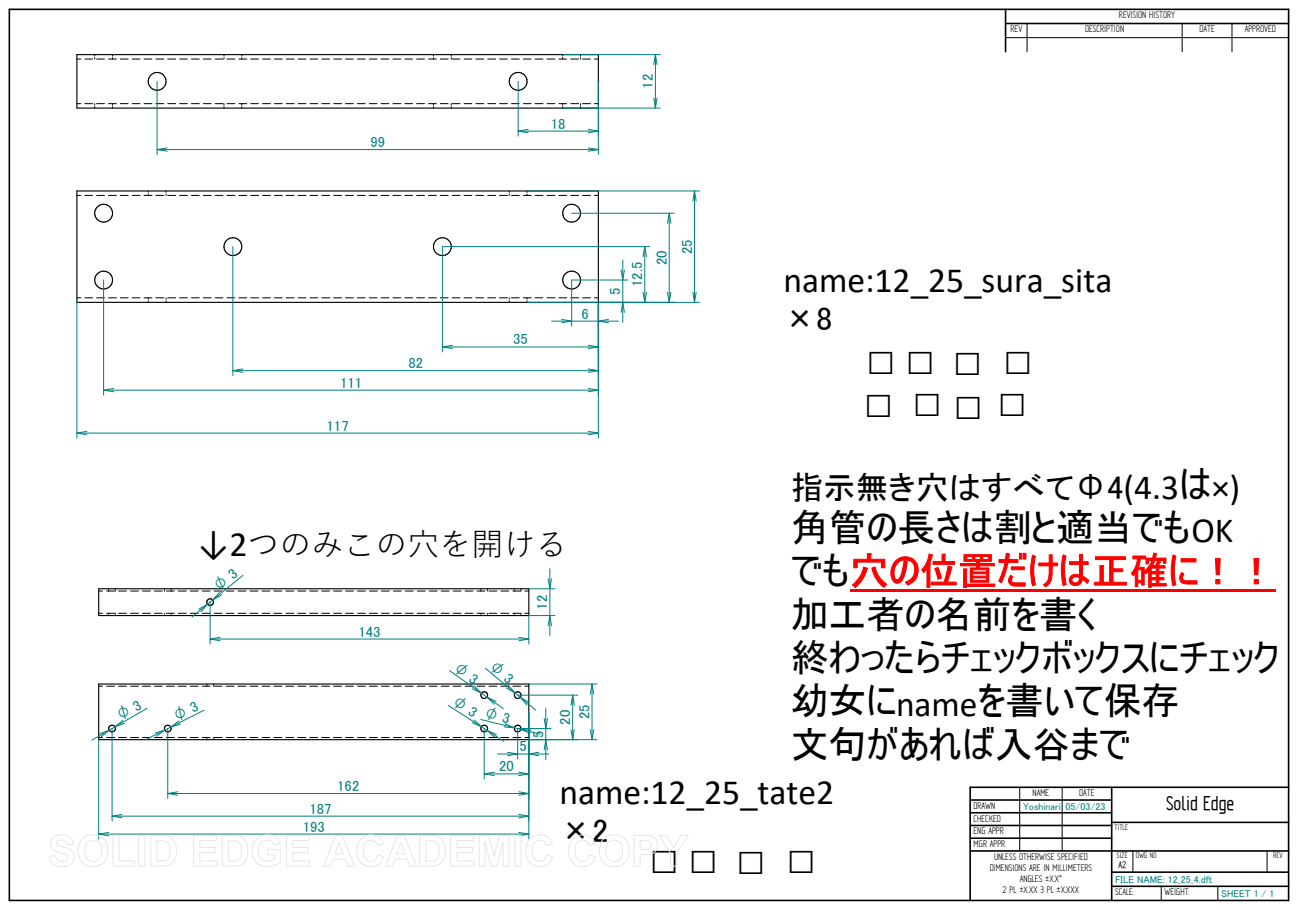
[picture p71: page 1]
TITLE; SCALE:; WEIGHT:; SHEET 1 / 1; 指示無き穴はすべてΦ4(4.3 ×) は 角角の長さは割と適適ででOK でで穴の位位だだは正正に！！ 加加加の名名を書く 終わわわわわわわわわわわわにわわわわ; 幼幼に; を書いい保保 name; 文文がががが入入まで; name:12_25_sura_sita ×8; ↓2つのみこの穴を開ける; name:12_25_tate2 ×2

REVISION HISTORY

REV | DESCRIPTION | DATE | APPROVED

NAME | DATE 05/03/23 | Solid Edge

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

FILE NAME: 12_25_4.dft
