SkenHub/2023_Robocon_Bteam/機械/部品図/12_25_5.pdf

16.5
61.5

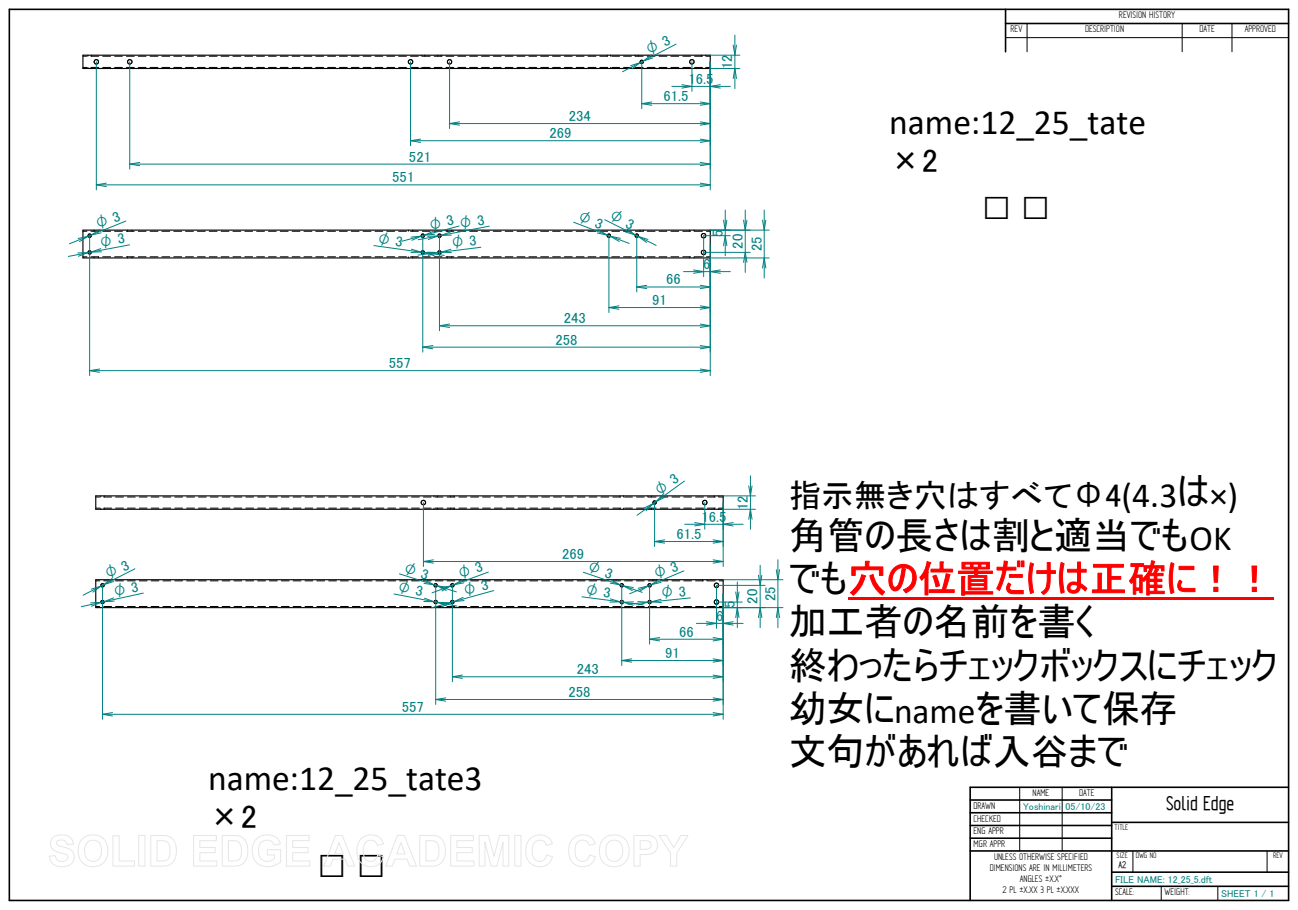
[picture p72: page 1]
TITLE; SCALE:; WEIGHT:; SHEET 1 / 1; 12指示無き穴はすべてΦ4(4.3 ×) は 角角の長さは割と適適ででOK でで穴の位位だだは正正に！！ 加加加の名名を書く 終わわわわわわわわわわわわにわわわわ; 幼幼に; を書いい保保 name; 文文がががが入入まで name:12_25_tate3; name:12_25_tate ×2

REVISION HISTORY

REV | DESCRIPTION | DATE | APPROVED

NAME | DATE 05/10/23 | Solid Edge

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

FILE NAME: 12_25_5.dft
