SkenHub/2023_Robocon_Bteam/機械/部品図/9_9.pdf

22.5

## 片方にΦ6，もう片方にΦ3の穴

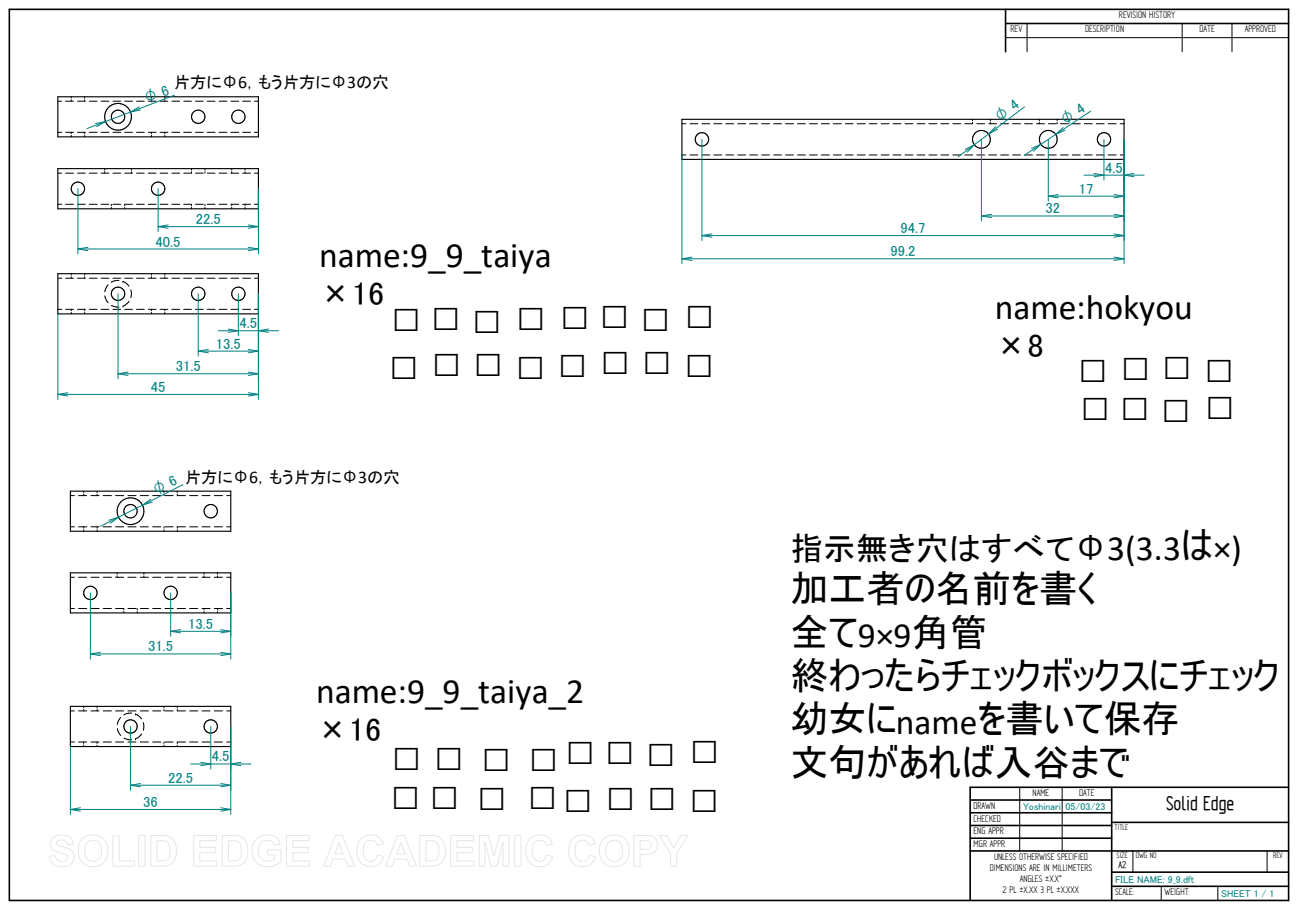
[picture p73: page 1]
NAME; DATE; Solid Edge; TITLE; SCALE:; WEIGHT:; SHEET 1 / 1; name:9_9_taiya ×16; name:9_9_taiya_2 ×16; 指示無き穴はすべてΦ3(3.3 ×) は 加加加の名名を書く; 終わわわわわわわわわわわわわわわわわ; 幼幼わ; を書いて保保 name; 文文がががが入入まま; 片方にΦ6，もう片方にΦ3の穴; name:hokyou ×8

REVISION HISTORY

REV | DESCRIPTION | DATE | APPROVED

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

FILE NAME: 9_9.dft
