SkenHub/2023_Robocon_Bteam/機械/部品図/fai10.pdf

7
7

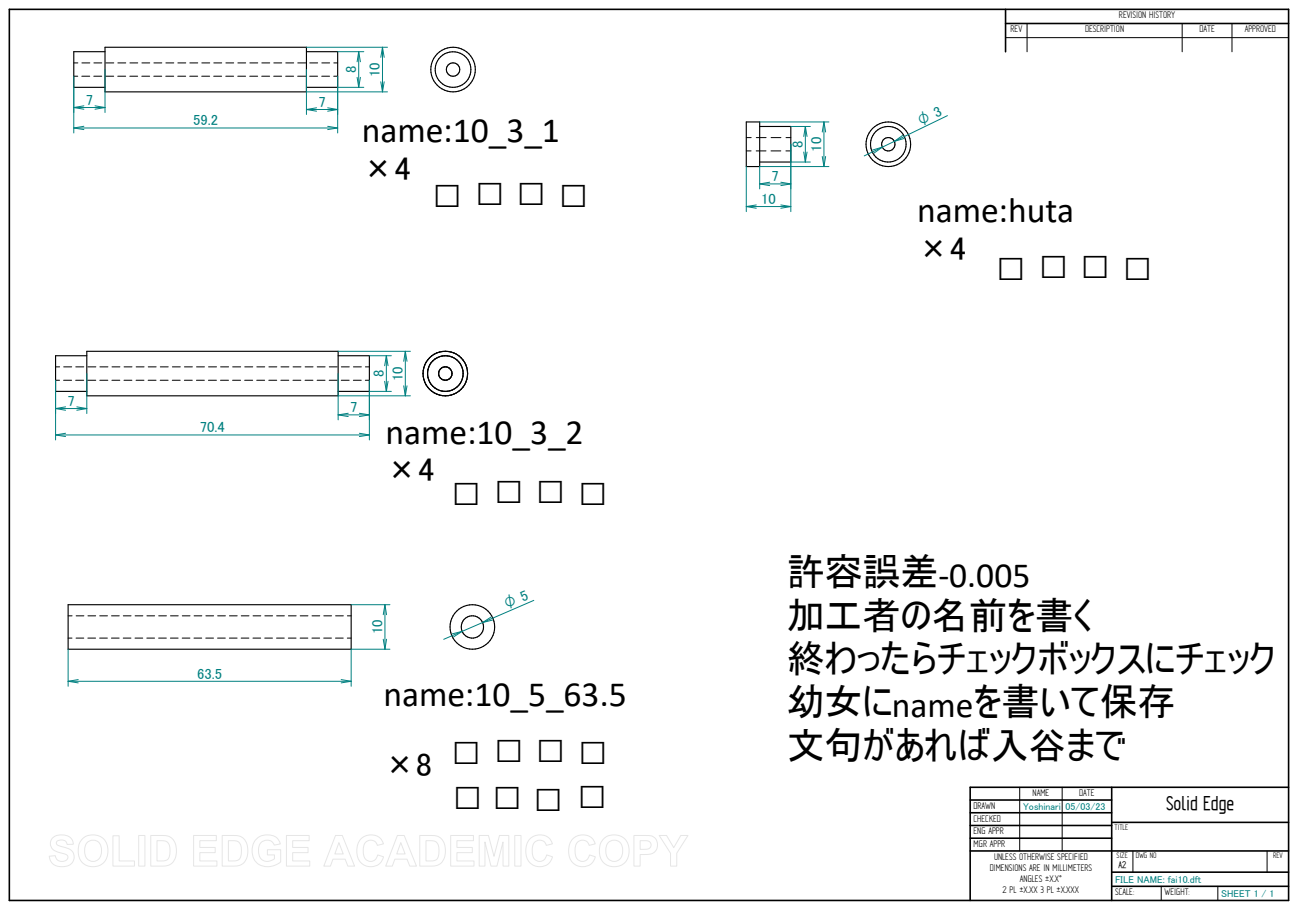
[picture p74: page 1]
TITLE; SCALE:; WEIGHT:; SHEET 1 / 1; name:10_3_1 ×4; name:10_3_2 ×4; name:huta ×4; name:10_5_63.5; 許許許許-0.005 加加加の名名を書く 終わわわわわわわわわわわわわわわわわ; 幼幼わ; を書いい保保 name; 文文がががが入入まま

REVISION HISTORY

REV | DESCRIPTION | DATE | APPROVED

NAME | DATE 05/03/23 | Solid Edge

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

FILE NAME: fai10.dft
