SkenHub/2023_Robocon_Bteam/機械/部品図/K_1.pdf

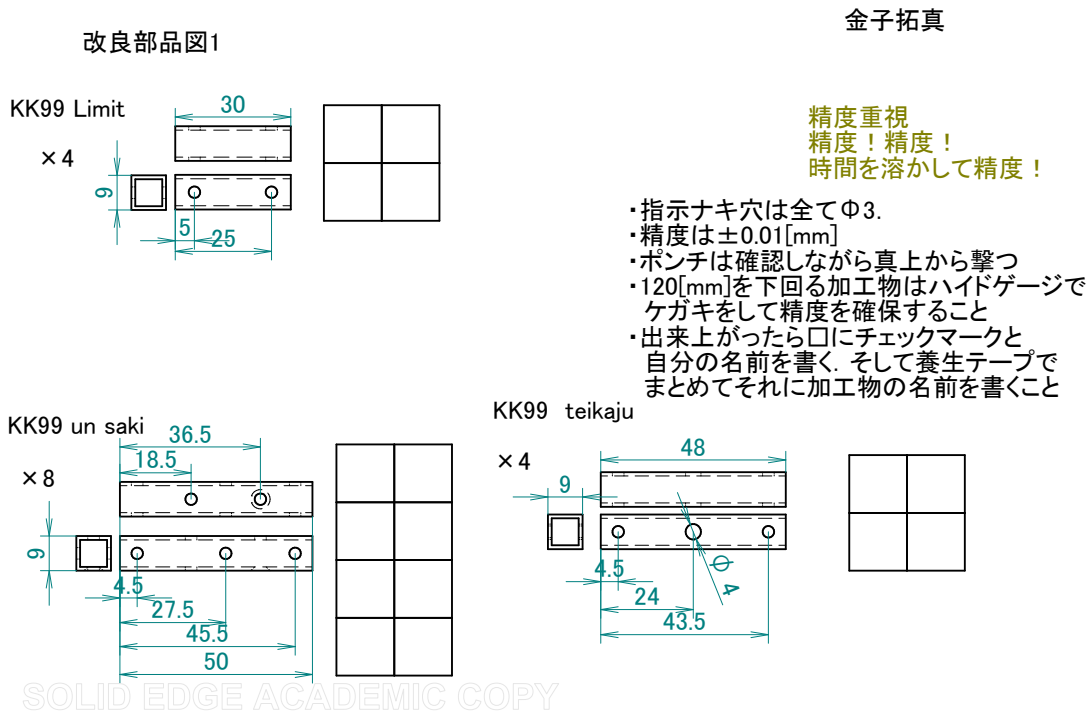
[picture p75: page 1]
改良部品図1; 金子拓真; 精度重視 精度！精度！ 時間を溶かして精度！; KK99 Limit; KK99 un saki; KK99 teikaju; ・指示ナキ穴は全てΦ3． ・精度は±0.01[mm] ・ポンチは確認しながら真上から撃つ ・120[mm]を下回る加工物はハイドゲージで ケガキをして精度を確保すること ・出来上がったら□にチェックマークと 自分の名前を書く．そして養生テープで まとめてそれに加工物の名前を書くこと
