SkenHub/2023_Robocon_Bteam/回路/SDMDx4/SDMDx4.kicad_pcb

## KiCad design 回路/SDMDx4/SDMDx4.kicad_pcb (2023-10-03)

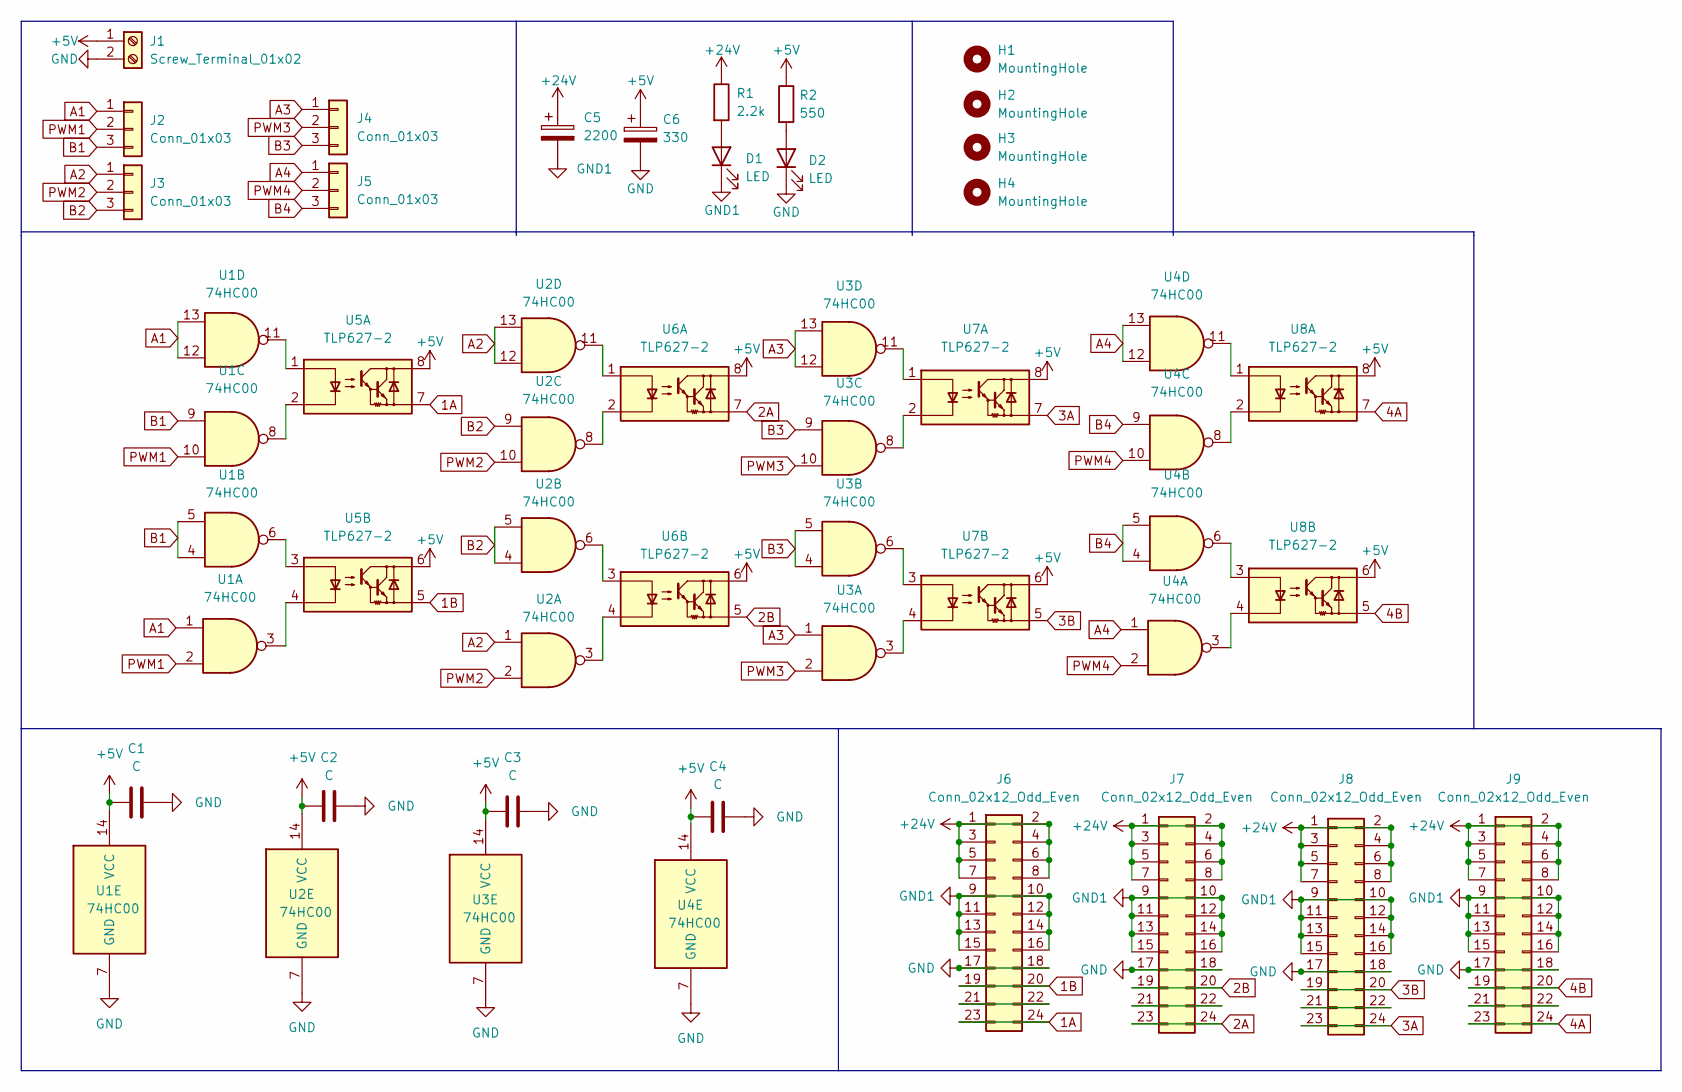
[picture p77: schematic SDMDx4.kicad_sch]

Parts:
C1, C2, C3, C4: C; C_Disc_D9.0mm_W2.5mm_P5.00mm
C5: 2200; CP_Radial_D10.0mm_P2.50mm_P5.00mm
C6: 330; CP_Radial_D5.0mm_P2.50mm
D1, D2: LED; LED_D3.0mm
H1, H2, H3, H4: MountingHole; MountingHole_3.2mm_M3
J1: Screw_Terminal_01x02; PinSocket_1x02_P2.54mm_Vertical
J2, J3, J4, J5: Conn_01x03; PinSocket_1x03_P2.54mm_Vertical
J6, J7, J8, J9: Conn_02x12_Odd_Even; PinHeader_2x12_P2.54mm_Vertical
R1: 2.2k; R_Axial_DIN0207_L6.3mm_D2.5mm_P10.16mm_Horizontal
R2: 550; R_Axial_DIN0207_L6.3mm_D2.5mm_P10.16mm_Horizontal
U1, U2, U3, U4: 74HC00; DIP-14_W7.62mm
U5, U6, U7, U8: TLP627-2; DIP-8_W7.62mm

Connections:
1A: J6.23, J6.24, U5.7
1B: J6.19, J6.20, U5.5
2A: J7.23, J7.24, U6.7
2B: J7.19, J7.20, U6.5
3A: J8.23, J8.24, U7.7
3B: J8.19, J8.20, U7.5
4A: J9.23, J9.24, U8.7
4B: J9.19, J9.20, U8.5
+5V: C1.1, C2.1, C3.1, C4.1, C6.1, J1.1, R2.1, U1.14 (VCC), U2.14 (VCC), U3.14 (VCC), U4.14 (VCC), U5.6, U5.8, U6.6, U6.8, U7.6, U7.8, U8.6, U8.8
+24V: C5.1, J6.1, J6.2, J6.3, J6.4, J6.5, J6.6, J6.7, J6.8, J7.1, J7.2, J7.3, J7.4, J7.5, J7.6, J7.7, J7.8, J8.1, J8.2, J8.3, J8.4, J8.5, J8.6, J8.7, J8.8, J9.1, J9.2, J9.3, J9.4, J9.5, J9.6, J9.7, J9.8, R1.1
A1: J2.1, U1.1, U1.12, U1.13
A2: J3.1, U2.1, U2.12, U2.13
A3: J4.1, U3.1, U3.12, U3.13
A4: J5.1, U4.1, U4.12, U4.13
B1: J2.3, U1.4, U1.5, U1.9
B2: J3.3, U2.4, U2.5, U2.9
B3: J4.3, U3.4, U3.5, U3.9
B4: J5.3, U4.4, U4.5, U4.9
GND: C1.2, C2.2, C3.2, C4.2, C6.2, D2.1 (K), J1.2, J6.17, J6.18, J7.17, J7.18, J8.17, J8.18, J9.17, J9.18, U1.7 (GND), U2.7 (GND), U3.7 (GND), U4.7 (GND)
GND1: C5.2, D1.1 (K), J6.9, J6.10, J6.11, J6.12, J6.13, J6.14, J6.15, J6.16, J7.9, J7.10, J7.11, J7.12, J7.13, J7.14, J7.15, J7.16, J8.9, J8.10, J8.11, J8.12, J8.13, J8.14, J8.15, J8.16, J9.9, J9.10, J9.11, J9.12, J9.13, J9.14, J9.15, J9.16
unnamed: J6.21, J6.22
unnamed: J7.21, J7.22
unnamed: J8.21, J8.22
unnamed: J9.21, J9.22
unnamed: D1.2 (A), R1.2
unnamed: D2.2 (A), R2.2
unnamed: U4.6, U8.3
unnamed: U4.8, U8.2
unnamed: U4.11, U8.1
unnamed: U1.11, U5.1
unnamed: U1.8, U5.2
unnamed: U1.6, U5.3
unnamed: U1.3, U5.4
unnamed: U2.11, U6.1
unnamed: U2.8, U6.2
unnamed: U2.6, U6.3
unnamed: U2.3, U6.4
unnamed: U3.11, U7.1
unnamed: U3.8, U7.2
unnamed: U3.6, U7.3
unnamed: U3.3, U7.4
unnamed: U4.3, U8.4
PWM1: J2.2, U1.2, U1.10
PWM2: J3.2, U2.2, U2.10
PWM3: J4.2, U3.2, U3.10
PWM4: J5.2, U4.2, U4.10

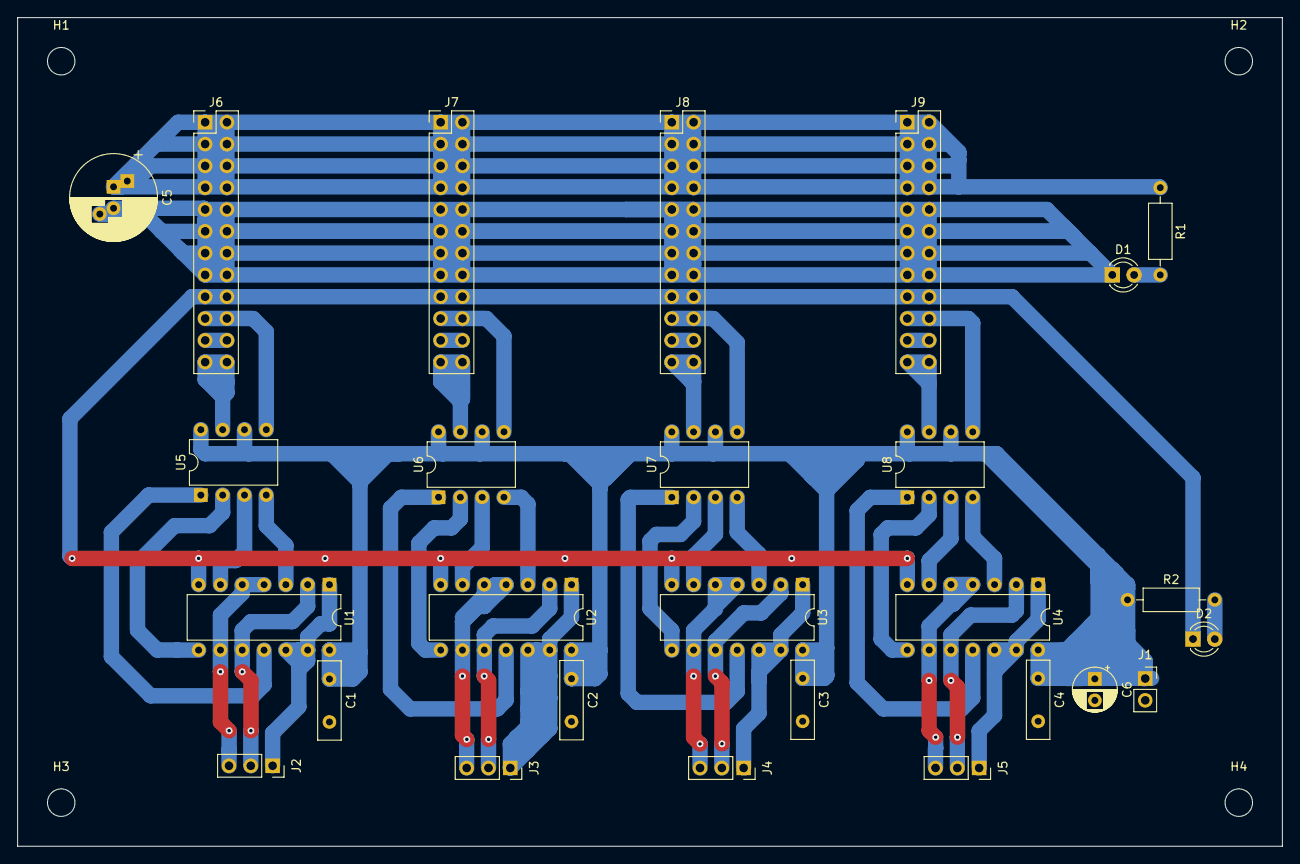
[picture p78: board SDMDx4.kicad_pcb from above]

Board: 2 copper layers, 147.3 x 96.5 mm, 31 parts (0 on the bottom side), 46 nets.
