SkenHub/2023_Robocon_Bteam/回路/savo/untitled.kicad_pcb

## KiCad design 回路/savo/untitled.kicad_pcb (2023-10-03)

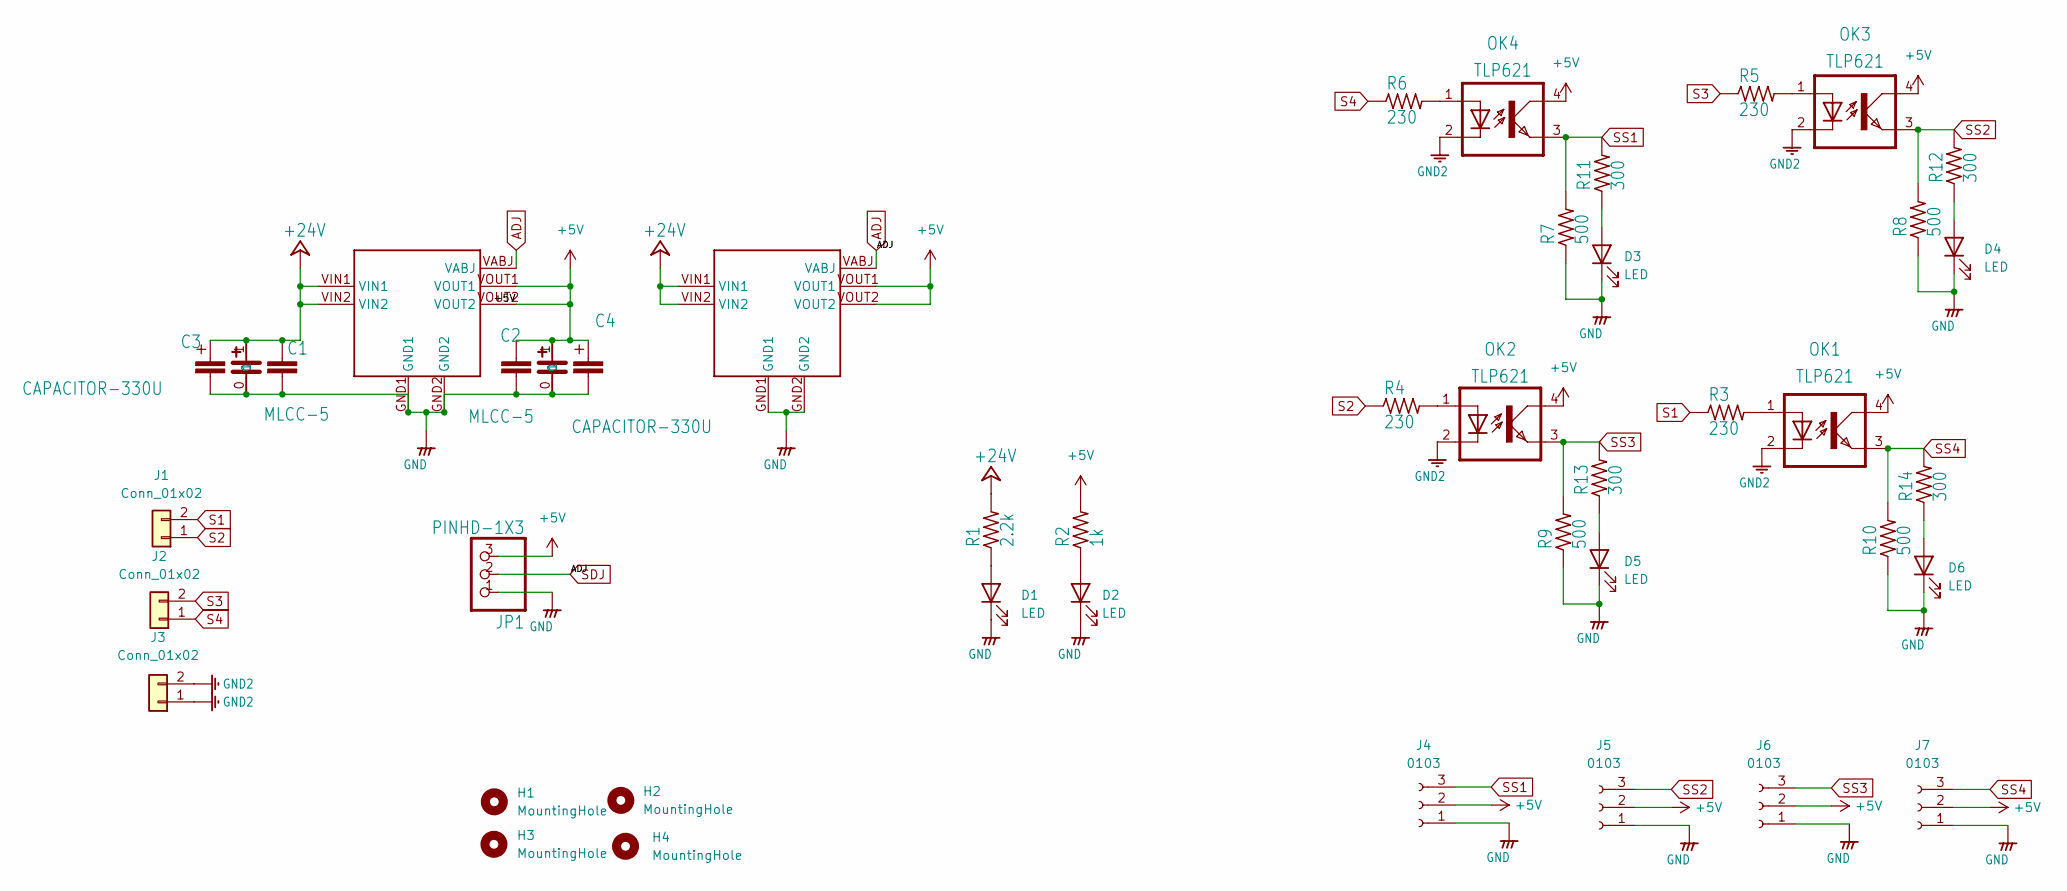
[picture p79: schematic untitled.kicad_sch]

Parts:
C1, C2: MLCC-5; MLCC_50
C3, C4: CAPACITOR-330U; C_330U
CAPACITOR1, CAPACITOR2: CAPACITOR
D1, D2, D3, D4, D5, D6: LED; LED_D3.0mm
H1, H2, H3, H4: MountingHole; MountingHole_3.2mm_M3
J1, J2, J3: Conn_01x02; PinHeader_1x02_P2.54mm_Vertical
J4, J5, J6, J7: 0103; FanPinHeader_1x03_P2.54mm_Vertical
JP1: PINHD-1X3; 1X03
KIC-1, KIC-2: KIC-053
OK1, OK2, OK3, OK4: TLP621; DIP4
R1: 2.2k; R_Axial_DIN0207_L6.3mm_D2.5mm_P10.16mm_Horizontal
R2: 1k; R_Axial_DIN0207_L6.3mm_D2.5mm_P10.16mm_Horizontal
R3, R4, R5, R6: 230; R_Axial_DIN0207_L6.3mm_D2.5mm_P10.16mm_Horizontal
R7, R8, R9, R10: 500; R_Axial_DIN0207_L6.3mm_D2.5mm_P10.16mm_Horizontal
R11, R12, R13, R14: 300; R_Axial_DIN0207_L6.3mm_D2.5mm_P10.16mm_Horizontal

Connections:
+5V: C2.1, C4.P$1 (1), CAPACITOR2.1, J4.2, J5.2, J6.2, J7.2, JP1.3, KIC-1.VOUT1, KIC-1.VOUT2, KIC-2.VOUT1, KIC-2.VOUT2, OK1.4 (COL), OK2.4 (COL), OK3.4 (COL), OK4.4 (COL), R2.2
+24V: C1.1, C3.P$1 (1), CAPACITOR1.1, KIC-1.VIN1, KIC-1.VIN2, KIC-2.VIN1, KIC-2.VIN2, R1.2
ADJ: JP1.2, KIC-1.VABJ, KIC-2.VABJ
GND: C1.2, C2.2, C3.P$2 (2), C4.P$2 (2), CAPACITOR1.0, CAPACITOR2.0, D1.1 (K), D2.1 (K), D3.1 (K), D4.1 (K), D5.1 (K), D6.1 (K), J4.1, J5.1, J6.1, J7.1, JP1.1, KIC-1.GND1, KIC-1.GND2, KIC-2.GND1, KIC-2.GND2, R7.1, R8.1, R9.1, R10.1
GND12: J3.1, J3.2, OK1.2 (C), OK2.2 (C), OK3.2 (C), OK4.2 (C)
unnamed: D1.2 (A), R1.1
unnamed: D2.2 (A), R2.1
unnamed: D3.2 (A), R11.1
unnamed: D4.2 (A), R12.1
unnamed: D5.2 (A), R13.1
unnamed: D6.2 (A), R14.1
unnamed: OK1.1 (A), R3.2
unnamed: OK3.1 (A), R5.2
unnamed: OK4.1 (A), R6.2
unnamed: OK2.1 (A), R4.2
S1: J1.2, R3.1
S2: J1.1, R4.1
S3: J2.2, R5.1
S4: J2.1, R6.1
SS1: J4.3, OK4.3 (EMIT), R7.2, R11.2
SS2: J5.3, OK3.3 (EMIT), R8.2, R12.2
SS3: J6.3, OK2.3 (EMIT), R9.2, R13.2
SS4: J7.3, OK1.3 (EMIT), R10.2, R14.2

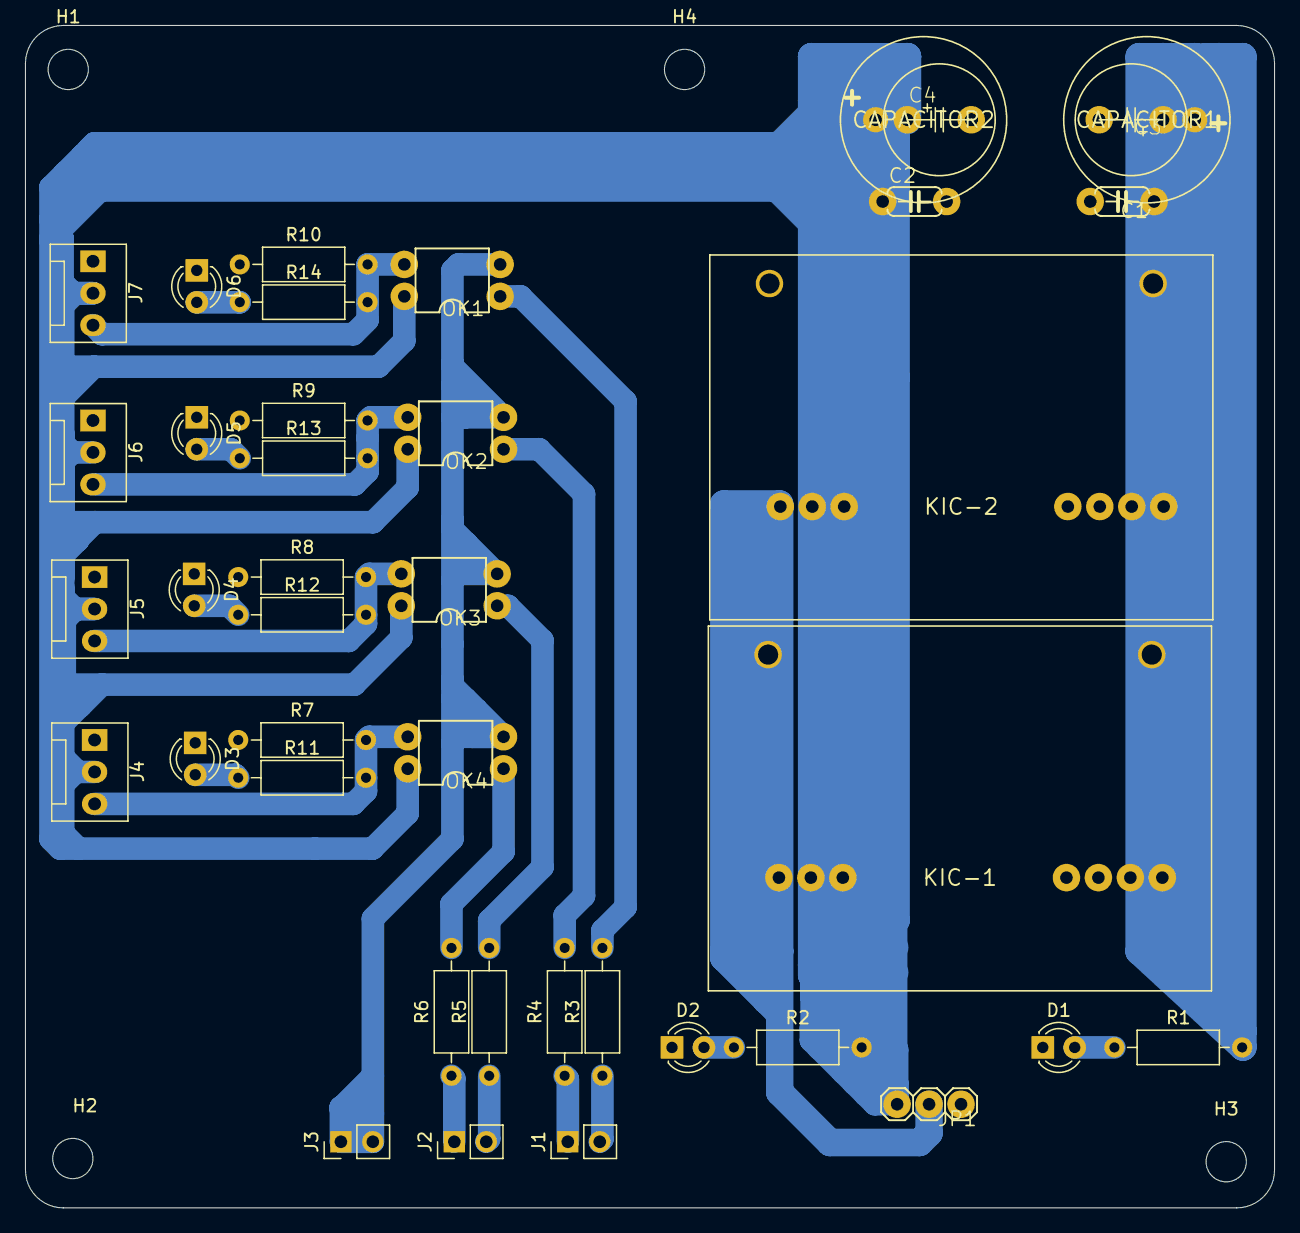
[picture p80: board untitled.kicad_pcb from above]

Board: 2 copper layers, 99.3 x 94.0 mm, 44 parts (0 on the bottom side), 23 nets.
