SkenHub/2023_Robocon_Bteam/回路/tnagi/tnagi.kicad_pcb

## KiCad design 回路/tnagi/tnagi.kicad_pcb (2023-08-21)

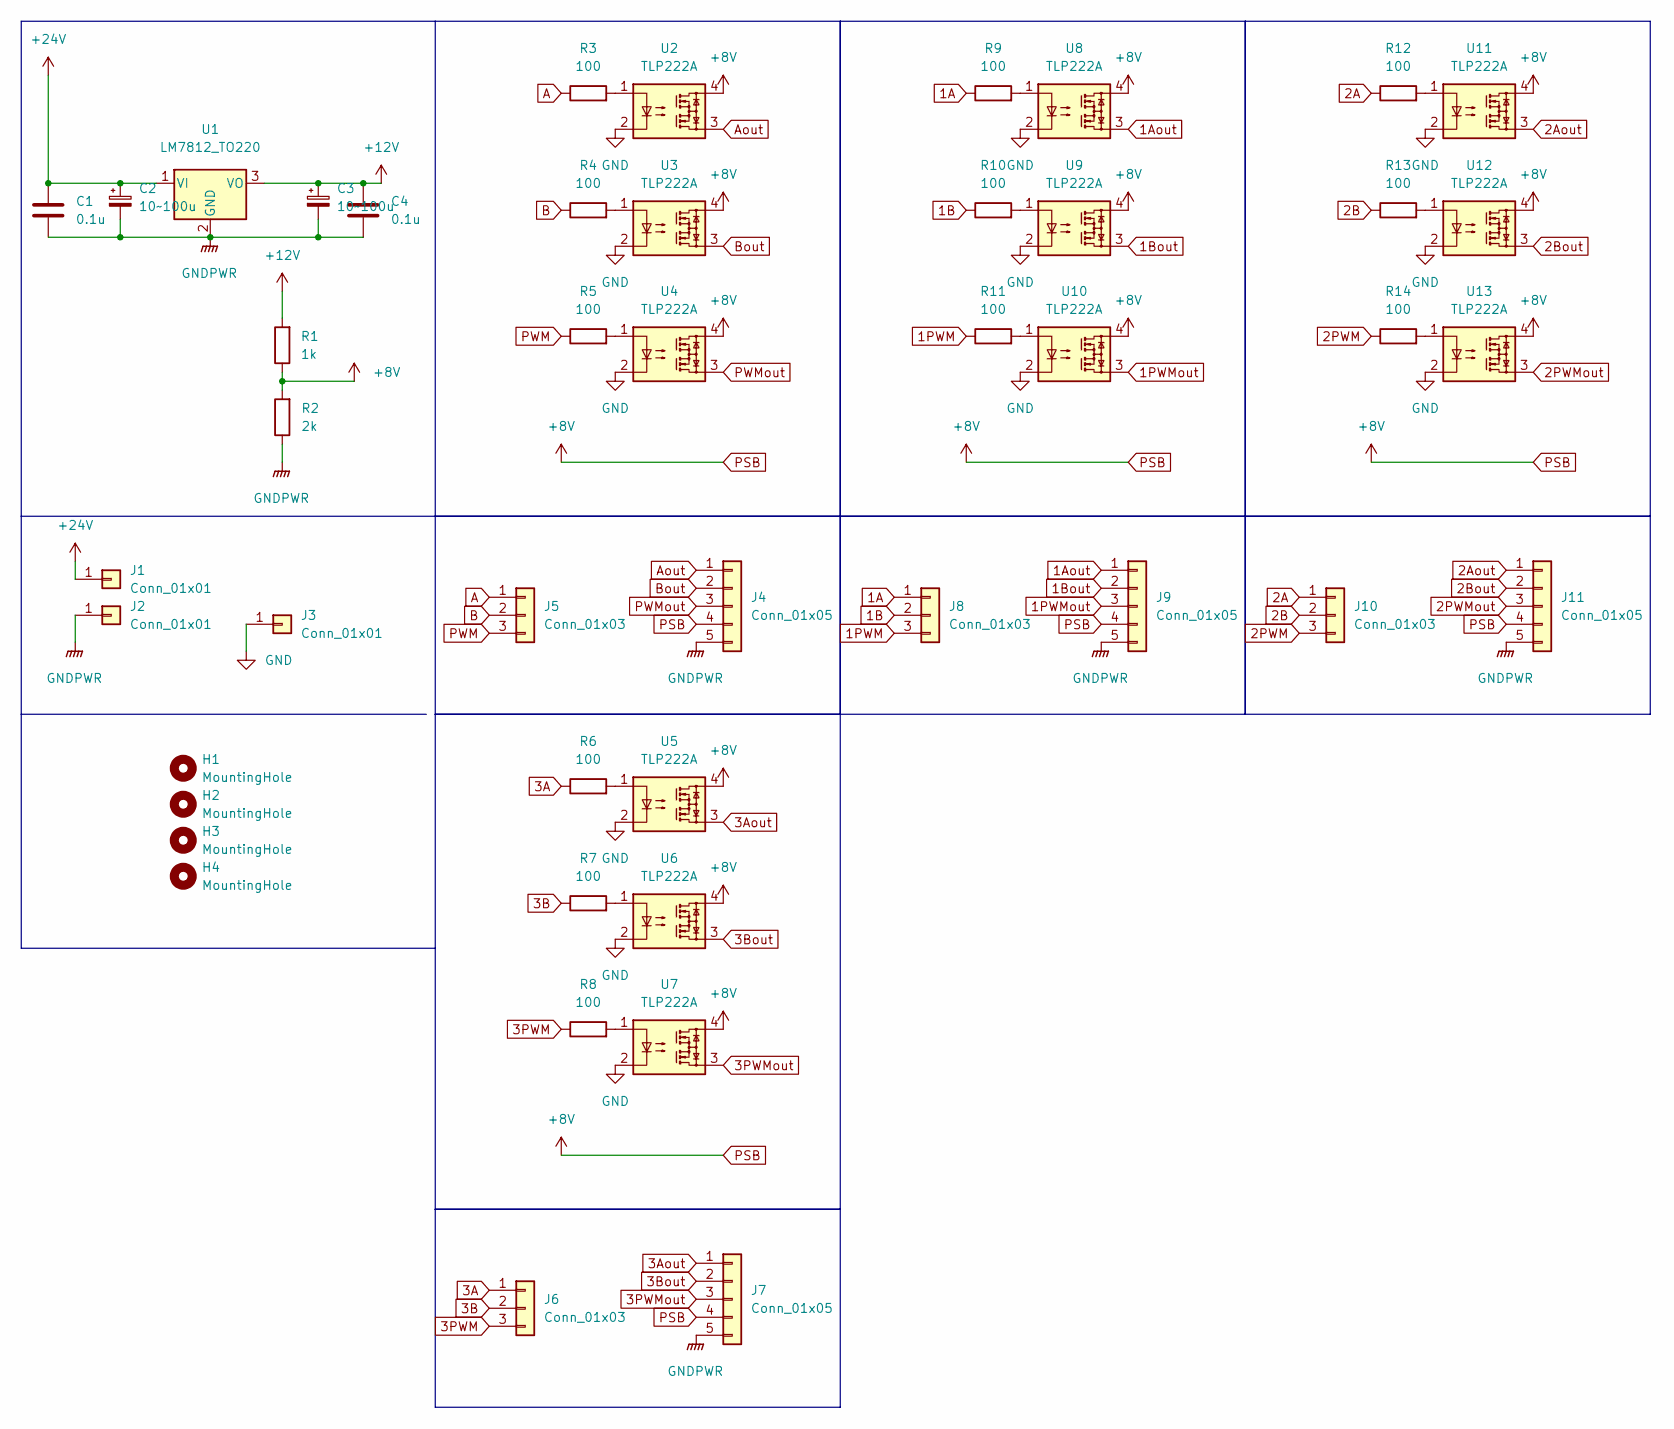
[picture p81: schematic tnagi.kicad_sch]

Parts:
C1, C4: 0.1u; C_Disc_D9.0mm_W2.5mm_P5.00mm
C2, C3: 10~100u; CP_Radial_D10.0mm_P5.00mm
H1, H2, H3, H4: MountingHole; MountingHole_3.2mm_M3
J1, J2, J3: Conn_01x01
J4, J7, J9, J11: Conn_01x05; PinSocket_1x05_P2.54mm_Vertical
J5, J6, J8, J10: Conn_01x03; PinSocket_1x03_P2.54mm_Vertical
R1: 1k; R_Axial_DIN0207_L6.3mm_D2.5mm_P10.16mm_Horizontal
R2: 2k; R_Axial_DIN0207_L6.3mm_D2.5mm_P10.16mm_Horizontal
R3, R4, R5, R6, R7, R8, R9, R10, R11, R12, R13, R14: 100; R_Axial_DIN0207_L6.3mm_D2.5mm_P10.16mm_Horizontal
U1: LM7812_TO220; TO-220-3_Vertical
U2, U3, U4, U5, U6, U7, U8, U9, U10, U11, U12, U13: TLP222A; DIP-4_W7.62mm

Connections:
1A: J8.1, R9.1
1Aout: J9.1, U8.3
1B: J8.2, R10.1
1Bout: J9.2, U9.3
1PWM: J8.3, R11.1
1PWMout: J9.3, U10.3
2A: J10.1, R12.1
2Aout: J11.1, U11.3
2B: J10.2, R13.1
2Bout: J11.2, U12.3
2PWM: J10.3, R14.1
2PWMout: J11.3, U13.3
3A: J6.1, R6.1
3Aout: J7.1, U5.3
3B: J6.2, R7.1
3Bout: J7.2, U6.3
3PWM: J6.3, R8.1
3PWMout: J7.3, U7.3
+12V: C3.1, C4.1, R1.2, U1.3 (VO)
+24V: C1.1, C2.1, J1.1, U1.1 (VI)
A: J5.1, R3.1
Aout: J4.1, U2.3
B: J5.2, R4.1
Bout: J4.2, U3.3
GND: J3.1, U2.2, U3.2, U4.2, U5.2, U6.2, U7.2, U8.2, U9.2, U10.2, U11.2, U12.2, U13.2
GNDPWR: C1.2, C2.2, C3.2, C4.2, J2.1, J4.5, J7.5, J9.5, J11.5, R2.1, U1.2 (GND)
unnamed: R3.2, U2.1
unnamed: R4.2, U3.1
unnamed: R5.2, U4.1
unnamed: R6.2, U5.1
unnamed: R7.2, U6.1
unnamed: R8.2, U7.1
unnamed: R9.2, U8.1
unnamed: R10.2, U9.1
unnamed: R11.2, U10.1
unnamed: R12.2, U11.1
unnamed: R13.2, U12.1
unnamed: R14.2, U13.1
PSB: J4.4, J7.4, J9.4, J11.4, R1.1, R2.2, U2.4, U3.4, U4.4, U5.4, U6.4, U7.4, U8.4, U9.4, U10.4, U11.4, U12.4, U13.4
PWM: J5.3, R5.1
PWMout: J4.3, U4.3

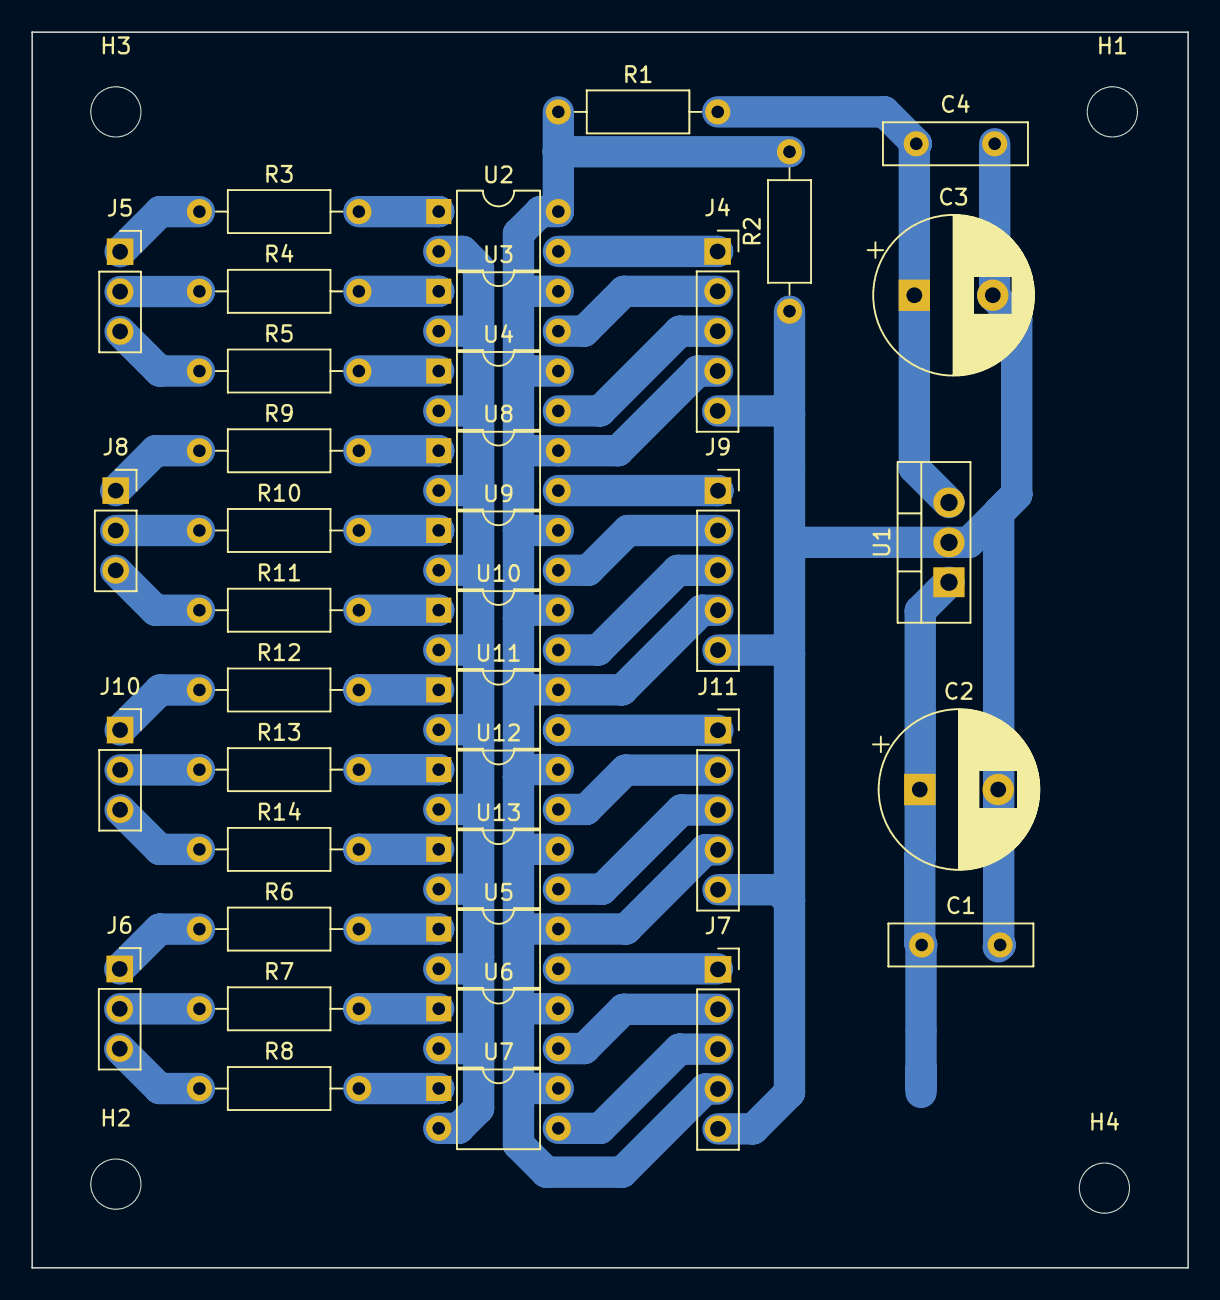
[picture p82: board tnagi.kicad_pcb from above]

Board: 2 copper layers, 73.7 x 78.7 mm, 43 parts (0 on the bottom side), 41 nets.
