SkenHub/2023_Robocon_Bteam/回路/rohmMD4/rohmMD4.kicad_pcb

## KiCad design 回路/rohmMD4/rohmMD4.kicad_pcb (2023-08-21)

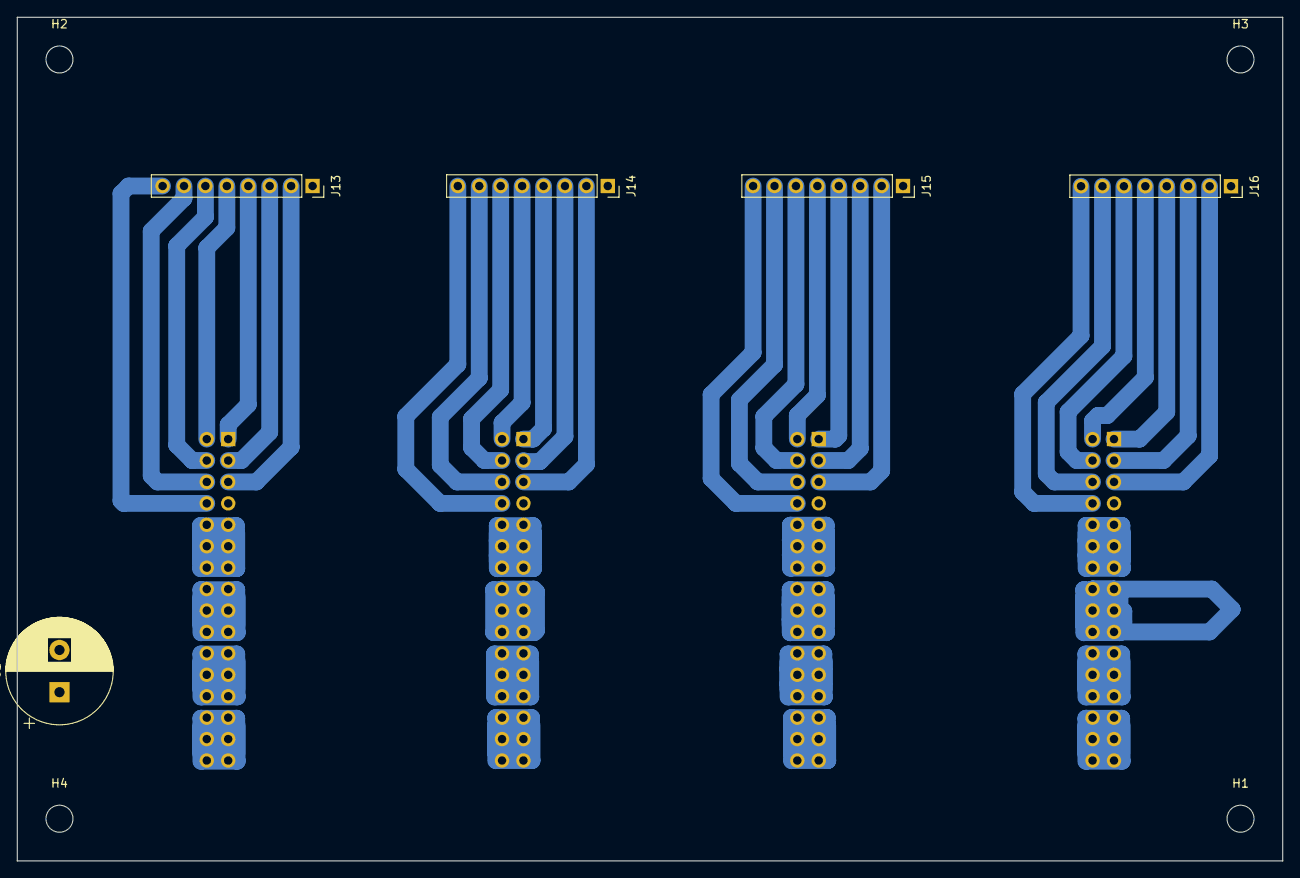
[picture p83: board rohmMD4.kicad_pcb from above]

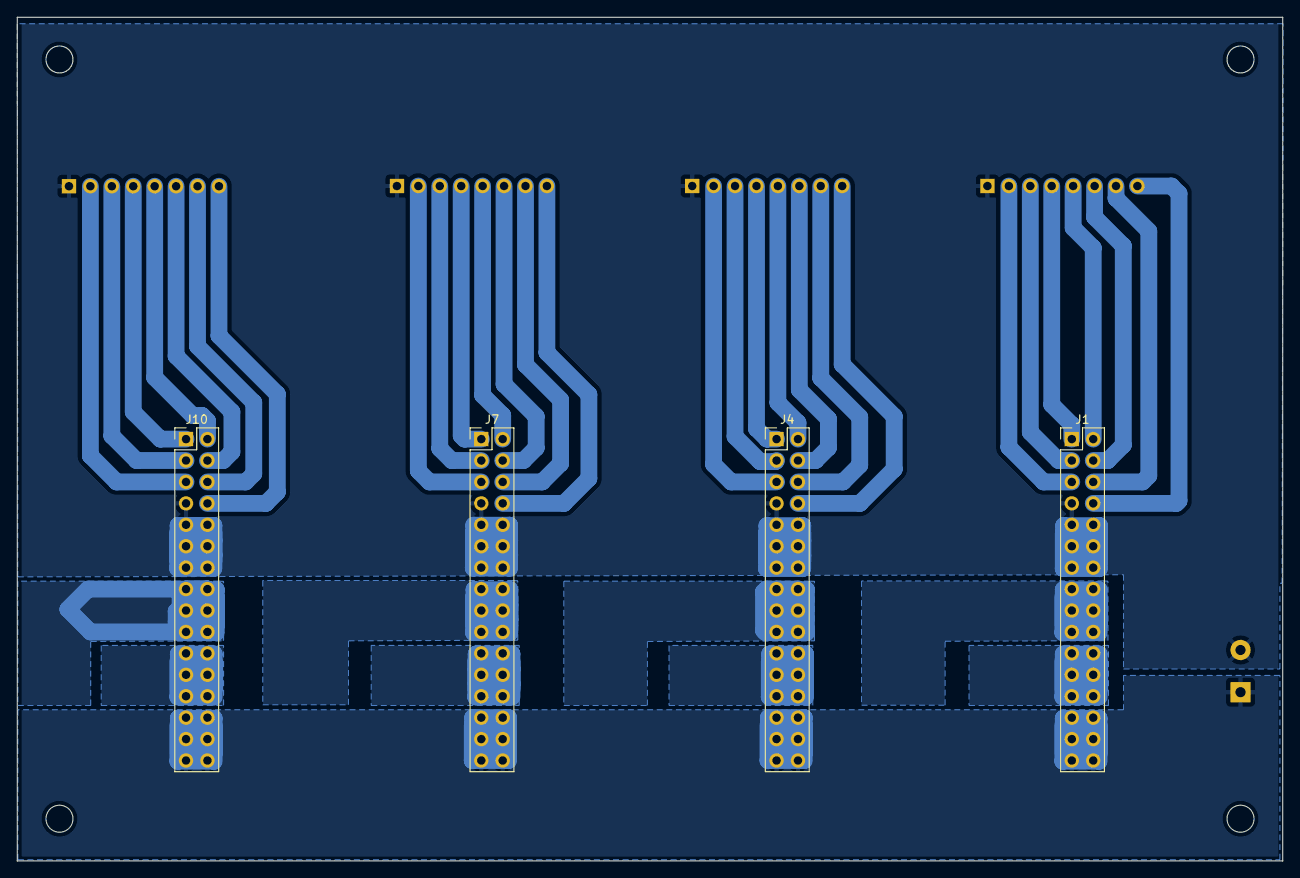
[picture p84: board rohmMD4.kicad_pcb from below]

Board: 2 copper layers, 150.0 x 100.0 mm, 13 parts (4 on the bottom side), 38 nets.

Parts:
C1: C_Polarized; CP_Radial_D12.5mm_P5.00mm
H1, H2, H3, H4: MountingHole; MountingHole_3.2mm_M3
J1, J4, J7, J10: Conn_02x16_Odd_Even; PinHeader_2x16_P2.54mm_Vertical
J13, J14, J15, J16: Conn_01x08; PinSocket_1x08_P2.54mm_Vertical

Connections:
1BRK: J1.3, J13.3
1FULL: J1.2, J13.5
1INA: J1.1, J13.4
1INB: J1.4, J13.6
1MA: J1.15, J1.16, J1.17, J1.18, J1.19, J1.20
1MB: J1.21, J1.22, J1.23, J1.24, J1.25, J1.26
1MOOD: J1.8, J13.8
1PSB: J1.5, J13.2
1PWM: J1.6, J13.7
2BRK: J4.3, J14.3
2FULL: J4.2, J14.5
2INA: J4.1, J14.4
2INB: J4.4, J14.6
2MA: J4.15, J4.16, J4.17, J4.18, J4.19, J4.20
2MB: J4.21, J4.22, J4.23, J4.24, J4.25, J4.26
2MOOD: J4.8, J14.8
2PSB: J4.5, J14.2
2PWM: J4.6, J14.7
3BRK: J7.3, J15.3
3FULL: J7.2, J15.5
3INA: J7.1, J15.4
3INB: J7.4, J15.6
3MA: J7.15, J7.16, J7.17, J7.18, J7.19, J7.20
3MB: J7.21, J7.22, J7.23, J7.24, J7.25, J7.26
3MOOD: J7.8, J15.8
3PSB: J7.5, J15.2
3PWM: J7.6, J15.7
4BRK: J10.3, J16.3
4FULL: J10.2, J16.5
4INA: J10.1, J16.4
4INB: J10.4, J16.6
4MA: J10.15, J10.16, J10.17, J10.18, J10.19, J10.20
4MB: J10.21, J10.22, J10.23, J10.24, J10.25, J10.26
4MOOD: J10.8, J16.8
4PSB: J10.5, J16.2
4PWM: J10.6, J16.7
+24V: C1.1, J1.27, J1.28, J1.29, J1.30, J1.31, J1.32, J4.27, J4.28, J4.29, J4.30, J4.31, J4.32, J7.27, J7.28, J7.29, J7.30, J7.31, J7.32, J10.27, J10.28, J10.29, J10.30, J10.31, J10.32
GND: C1.2, J1.7, J1.9, J1.10, J1.11, J1.12, J1.13, J1.14, J4.7, J4.9, J4.10, J4.11, J4.12, J4.13, J4.14, J7.7, J7.9, J7.10, J7.11, J7.12, J7.13, J7.14, J10.7, J10.9, J10.10, J10.11, J10.12, J10.13, J10.14, J13.1, J14.1, J15.1, J16.1
