SkenHub/2023_Robocon_Bteam/回路/main2_circuit_V1/main2_circuit_V1.kicad_pcb

## KiCad design 回路/main2_circuit_V1/main2_circuit_V1.kicad_pcb (2023-08-16)

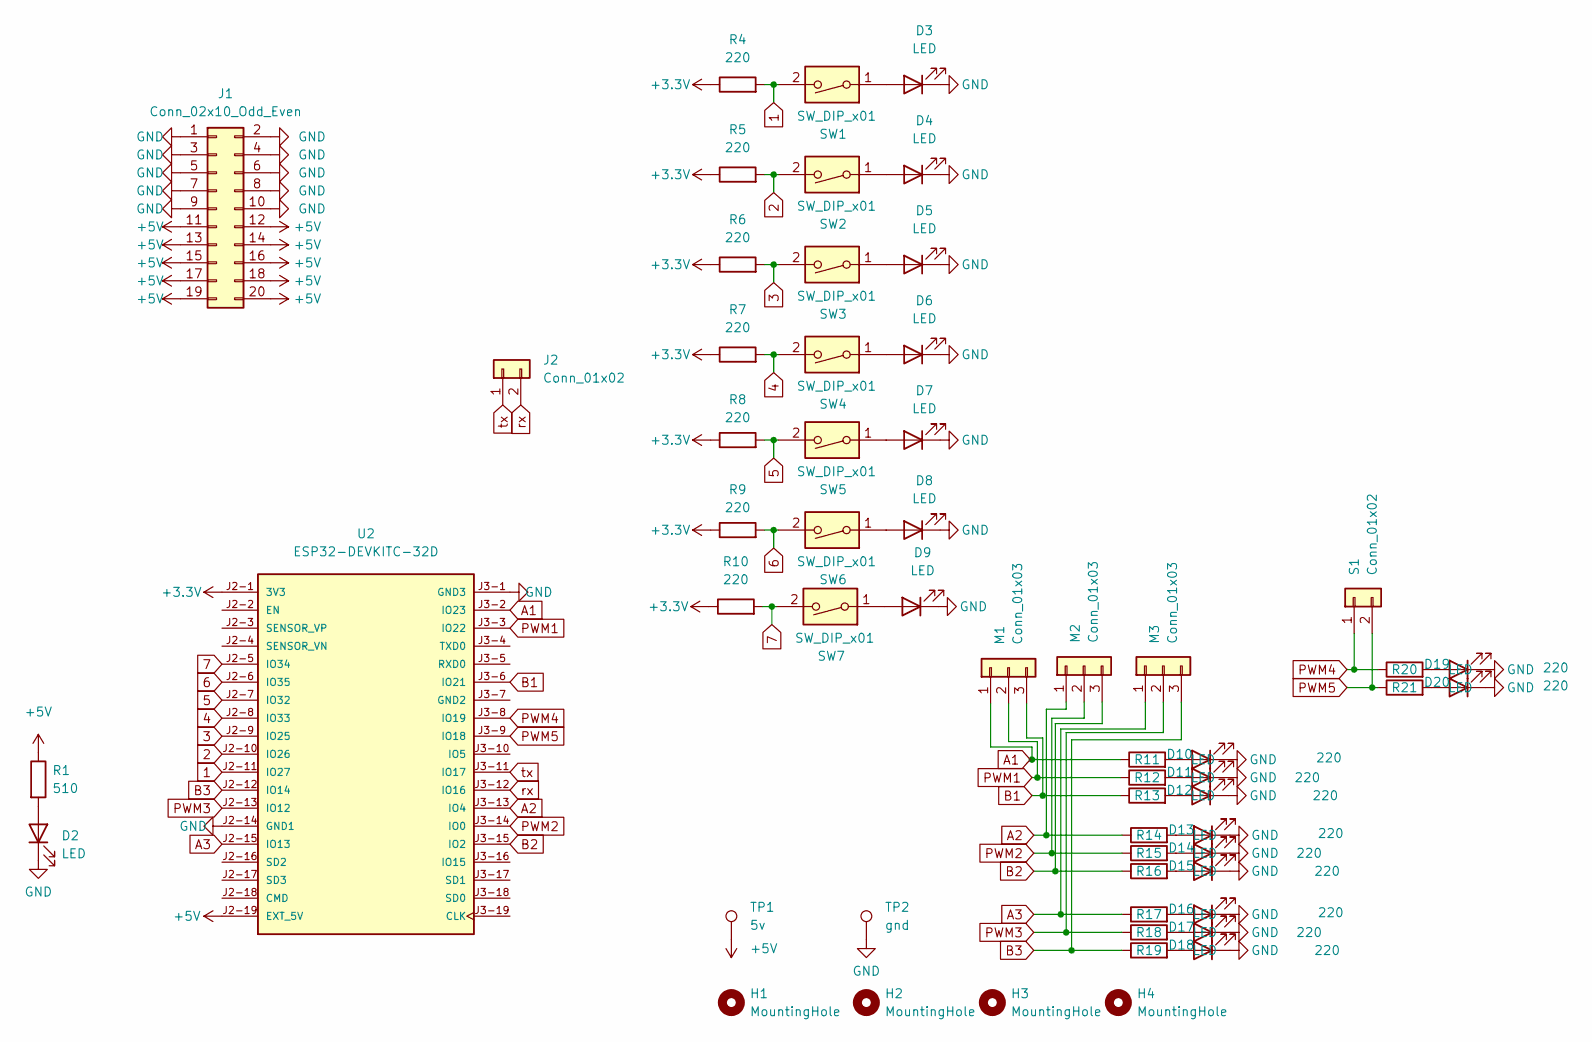
[picture p85: schematic main2_circuit_V1.kicad_sch]

Parts:
D2, D3, D4, D5, D6, D7, D8, D9, D10, D11, D12, D13, D14, D15, D16, D17, D18, D19, D20: LED; LED_D5.0mm
H1, H2, H3, H4: MountingHole; MountingHole_3.2mm_M3
J1: Conn_02x10_Odd_Even; PinHeader_2x10_P2.54mm_Vertical
J2: Conn_01x02; PinHeader_1x02_P2.54mm_Vertical
M1, M2, M3: Conn_01x03; PinHeader_1x03_P2.54mm_Vertical
R1: 510; R_Axial_DIN0207_L6.3mm_D2.5mm_P10.16mm_Horizontal
R4, R5, R6, R7, R8, R9, R10, R11, R12, R13, R14, R15, R16, R17, R18, R19, R20, R21: 220; R_Axial_DIN0207_L6.3mm_D2.5mm_P10.16mm_Horizontal
S1: Conn_01x02; PinHeader_1x02_P2.54mm_Vertical
SW1, SW2, SW3, SW4, SW5, SW6, SW7: SW_DIP_x01; PinHeader_1x02_P2.54mm_Vertical
TP1: 5v; TestPoint_THTPad_D2.0mm_Drill1.0mm
TP2: gnd; TestPoint_THTPad_D2.0mm_Drill1.0mm
U2: ESP32-DEVKITC-32D; MODULE_ESP32-DEVKITC-32D; PARTREV V4

Connections:
1: R4.2, SW1.2, U2.J2-11 (IO27)
2: R5.2, SW2.2, U2.J2-10 (IO26)
3: R6.2, SW3.2, U2.J2-9 (IO25)
4: R7.2, SW4.2, U2.J2-8 (IO33)
5: R8.2, SW5.2, U2.J2-7 (IO32)
6: R9.2, SW6.2, U2.J2-6 (IO35)
7: R10.2, SW7.2, U2.J2-5 (IO34)
+3.3V: R4.1, R5.1, R6.1, R7.1, R8.1, R9.1, R10.1, U2.J2-1 (3V3)
+5V: J1.11, J1.12, J1.13, J1.14, J1.15, J1.16, J1.17, J1.18, J1.19, J1.20, R1.1, TP1.1, U2.J2-19 (EXT_5V)
A1: M1.1, R11.1, U2.J3-2 (IO23)
A2: M2.1, R14.1, U2.J3-13 (IO4)
A3: M3.1, R17.1, U2.J2-15 (IO13)
B1: M1.3, R13.1, U2.J3-6 (IO21)
B2: M2.3, R16.1, U2.J3-15 (IO2)
B3: M3.3, R19.1, U2.J2-12 (IO14)
GND: D2.1 (K), D3.1 (K), D4.1 (K), D5.1 (K), D6.1 (K), D7.1 (K), D8.1 (K), D9.1 (K), D10.1 (K), D11.1 (K), D12.1 (K), D13.1 (K), D14.1 (K), D15.1 (K), D16.1 (K), D17.1 (K), D18.1 (K), D19.1 (K), D20.1 (K), J1.1, J1.2, J1.3, J1.4, J1.5, J1.6, J1.7, J1.8, J1.9, J1.10, TP2.1, U2.J2-14 (GND1), U2.J3-1 (GND3)
unnamed: D2.2 (A), R1.2
unnamed: D3.2 (A), SW1.1
unnamed: D4.2 (A), SW2.1
unnamed: D5.2 (A), SW3.1
unnamed: D6.2 (A), SW4.1
unnamed: D7.2 (A), SW5.1
unnamed: D8.2 (A), SW6.1
unnamed: D9.2 (A), SW7.1
unnamed: D10.2 (A), R11.2
unnamed: D11.2 (A), R12.2
unnamed: D12.2 (A), R13.2
unnamed: D13.2 (A), R14.2
unnamed: D14.2 (A), R15.2
unnamed: D15.2 (A), R16.2
unnamed: D16.2 (A), R17.2
unnamed: D17.2 (A), R18.2
unnamed: D18.2 (A), R19.2
unnamed: D19.2 (A), R20.2
unnamed: D20.2 (A), R21.2
PWM1: M1.2, R12.1, U2.J3-3 (IO22)
PWM2: M2.2, R15.1, U2.J3-14 (IO0)
PWM3: M3.2, R18.1, U2.J2-13 (IO12)
PWM4: R20.1, S1.1, U2.J3-8 (IO19)
PWM5: R21.1, S1.2, U2.J3-9 (IO18)
rx: J2.2, U2.J3-12 (IO16)
tx: J2.1, U2.J3-11 (IO17)

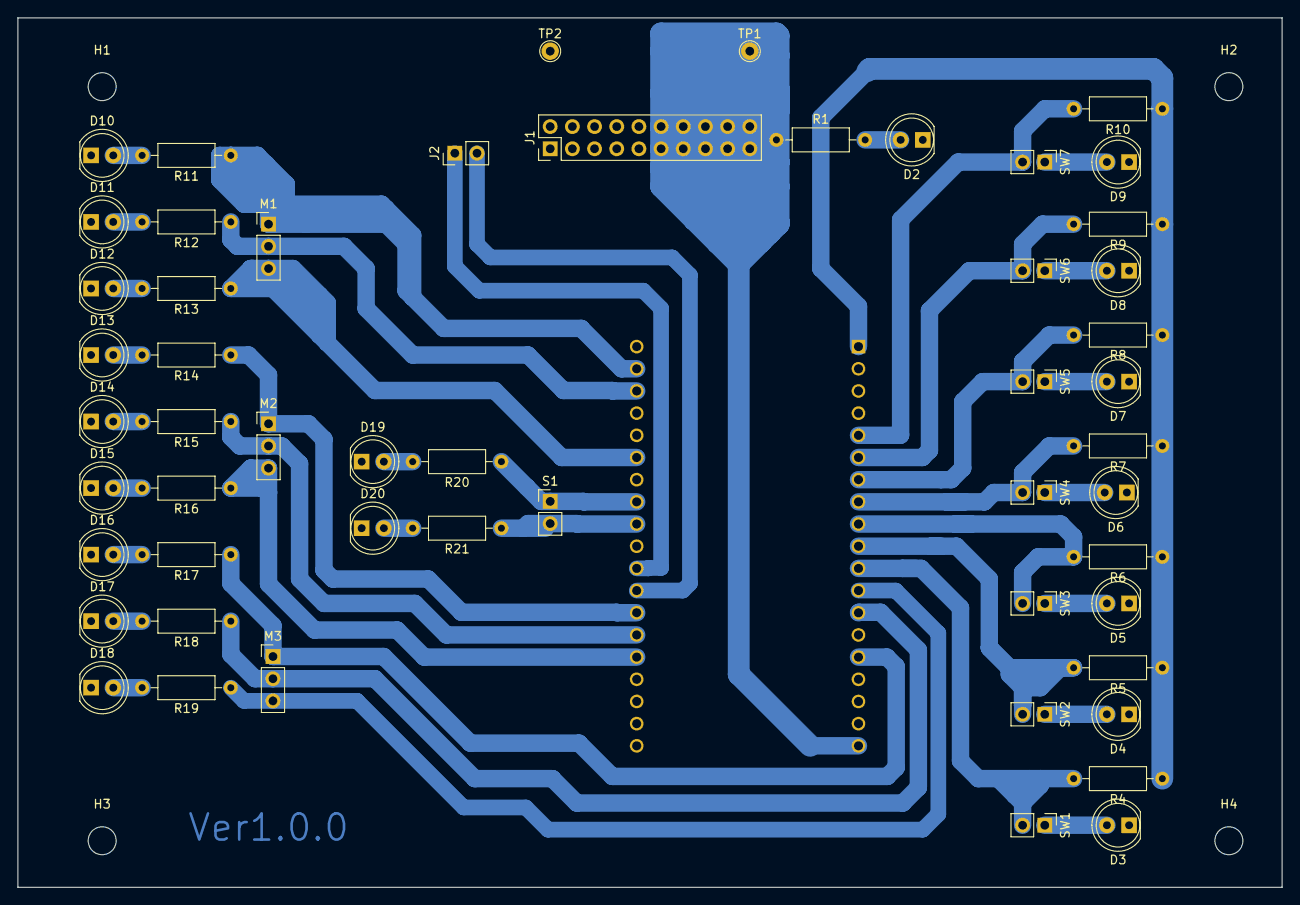
[picture p86: board main2_circuit_V1.kicad_pcb from above]

Board: 2 copper layers, 144.8 x 99.6 mm, 58 parts (1 on the bottom side), 42 nets.
