SkenHub/2023_Robocon_Bteam/回路/Altair_controller_V2/Altair_controller_V2.kicad_pcb

## KiCad design 回路/Altair_controller_V2/Altair_controller_V2.kicad_pcb (2023-08-15)

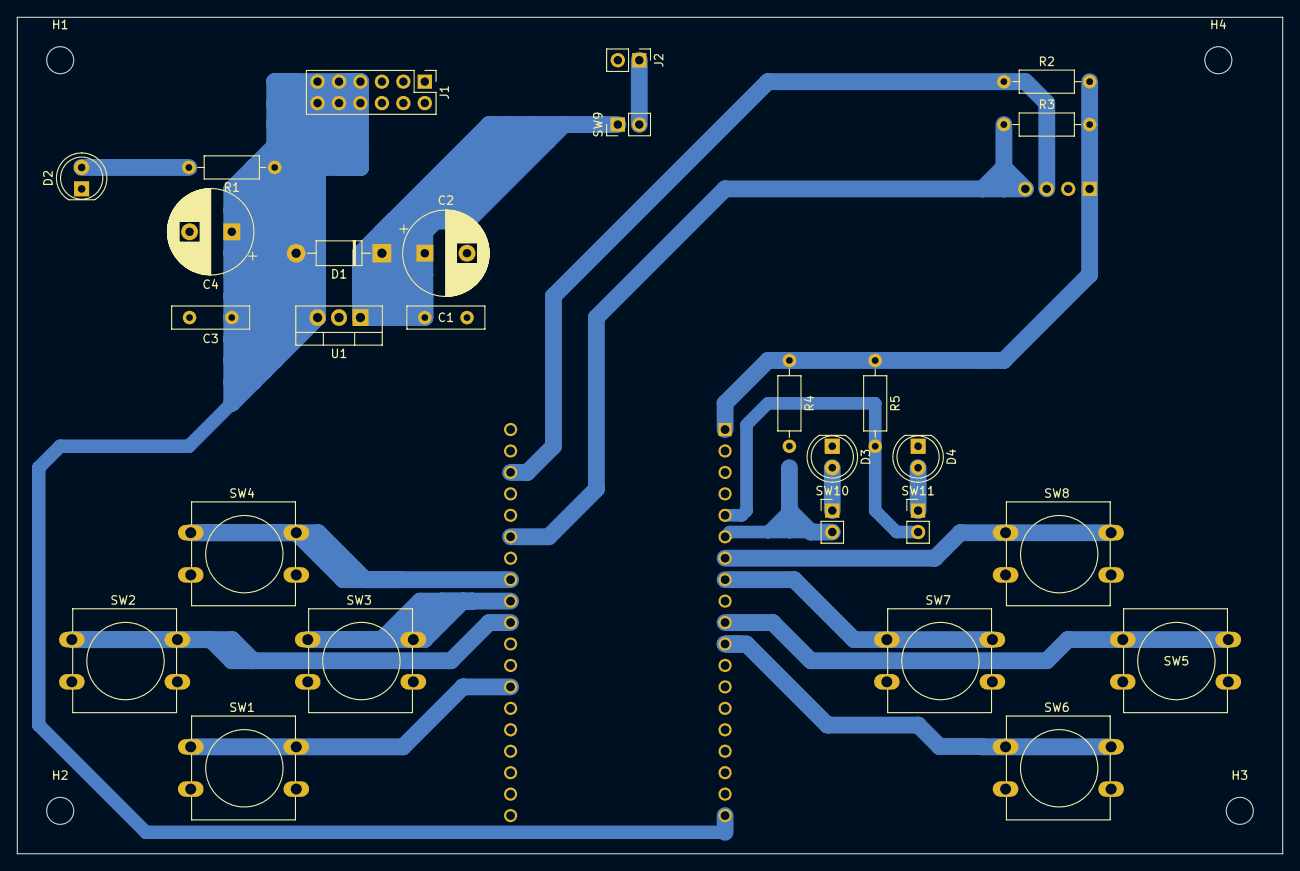
[picture p87: board Altair_controller_V2.kicad_pcb from above]

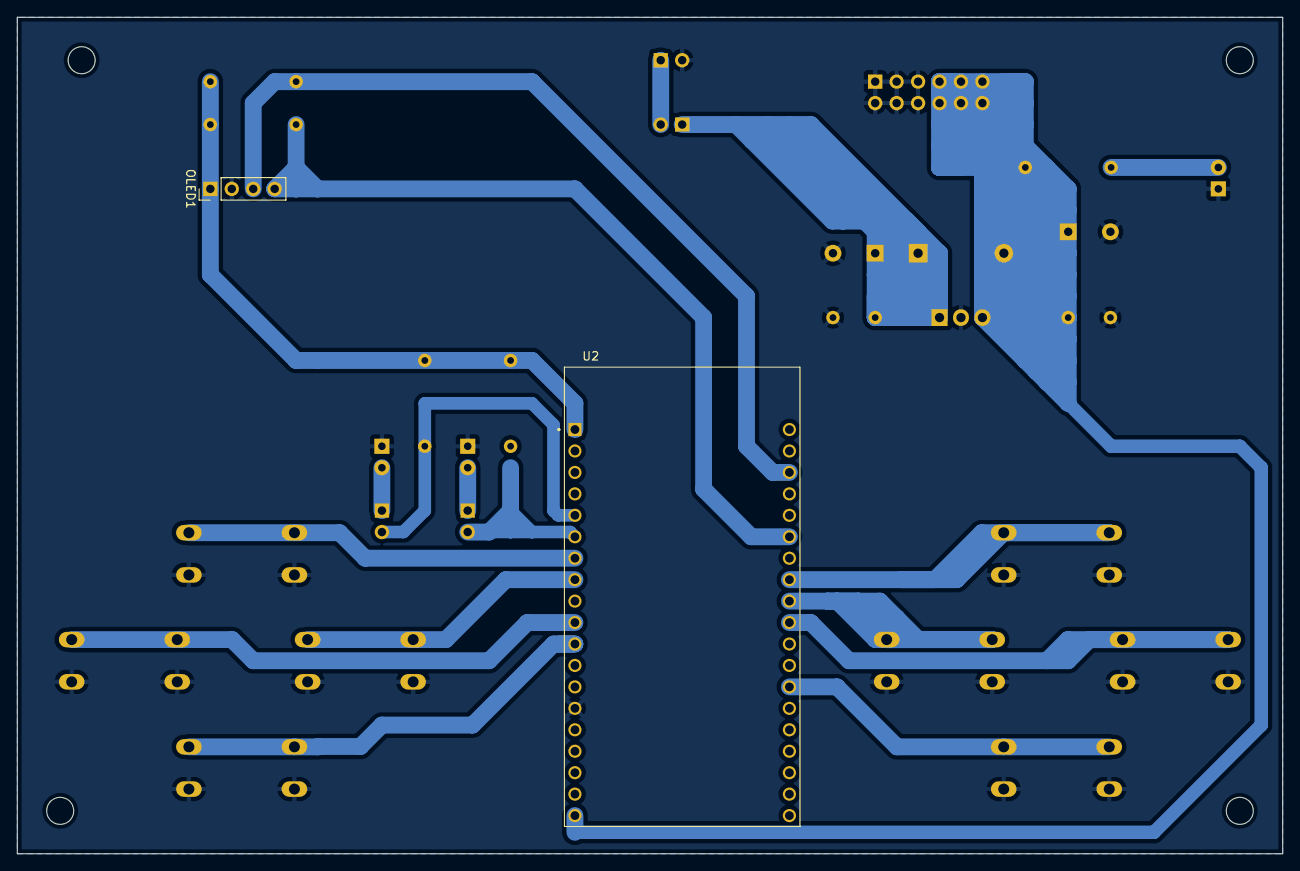
[picture p88: board Altair_controller_V2.kicad_pcb from below]

Board: 2 copper layers, 149.9 x 99.1 mm, 33 parts (2 on the bottom side), 20 nets.

Parts:
C1, C3: 0.1μF; C_Disc_D9.0mm_W2.5mm_P5.00mm
C2, C4: 10uF～100uF; CP_Radial_D10.0mm_P5.00mm
D1: D_Schottky; D_DO-41_SOD81_P10.16mm_Horizontal
D2, D3, D4: LED; LED_D5.0mm
H1, H2, H3, H4: MountingHole; MountingHole_3.2mm_M3
J1: Conn_02x06_Odd_Even; PinHeader_2x06_P2.54mm_Vertical
J2: Conn_01x02_Female; PinHeader_1x02_P2.54mm_Vertical
OLED1: OLED; PinHeader_1x04_P2.54mm_Vertical
R1: 510; R_Axial_DIN0207_L6.3mm_D2.5mm_P10.16mm_Horizontal
R2, R3: 10k; R_Axial_DIN0207_L6.3mm_D2.5mm_P10.16mm_Horizontal
R4, R5: 220; R_Axial_DIN0207_L6.3mm_D2.5mm_P10.16mm_Horizontal
SW1, SW2, SW3, SW4, SW5, SW6, SW7, SW8: SW_Push_Dual; SW_PUSH-12mm
SW9, SW10, SW11: SW_DIP_x01; PinHeader_1x02_P2.54mm_Vertical
U1: 7805; TO-220-3_Vertical
U2: ESP32-DEVKITC-32D; MODULE_ESP32-DEVKITC-32D

Connections:
1: SW5.1, U2.J2-10 (IO26)
2: SW6.1, U2.J2-11 (IO27)
3: SW7.1, U2.J2-8 (IO33)
4: SW8.1, U2.J2-7 (IO32)
5: R4.2, SW10.2, U2.J2-6 (IO35)
6: R5.2, SW11.2, U2.J2-5 (IO34)
+3.3V: OLED1.1, R2.2, R3.2, R4.1, R5.1, U2.J2-1 (3V3)
+5V: C3.1, C4.1, D1.2 (A), J1.7, J1.8, J1.9, J1.10, J1.11, J1.12, R1.1, U1.3 (VO), U2.J2-19 (EXT_5V)
A: SW1.1, U2.J3-13 (IO4)
B: SW2.1, U2.J3-10 (IO5)
C: SW3.1, U2.J3-9 (IO18)
D: SW4.1, U2.J3-8 (IO19)
GND: C1.2, C2.2, C3.2, C4.2, D2.1 (K), D3.1 (K), D4.1 (K), J1.1, J1.2, J1.3, J1.4, J1.5, J1.6, J2.2, OLED1.2, SW1.2, SW2.2, SW3.2, SW4.2, SW5.2, SW6.2, SW7.2, SW8.2, U1.2 (GND), U2.J2-14 (GND1)
unnamed: C1.1, C2.1, D1.1 (K), SW9.1, U1.1 (VI)
unnamed: D2.2 (A), R1.2
unnamed: D3.2 (A), SW10.1
unnamed: D4.2 (A), SW11.1
SCL: OLED1.3, R2.1, U2.J3-3 (IO22)
SDA: OLED1.4, R3.1, U2.J3-6 (IO21)
VCC: J2.1, SW9.2
