SkenHub/2023_Robocon_Bteam/回路/ききゃど/md2014_norm_PN_04.kicad_pcb

## KiCad design 回路/ききゃど/md2014_norm_PN_04.kicad_pcb (2023-06-08)

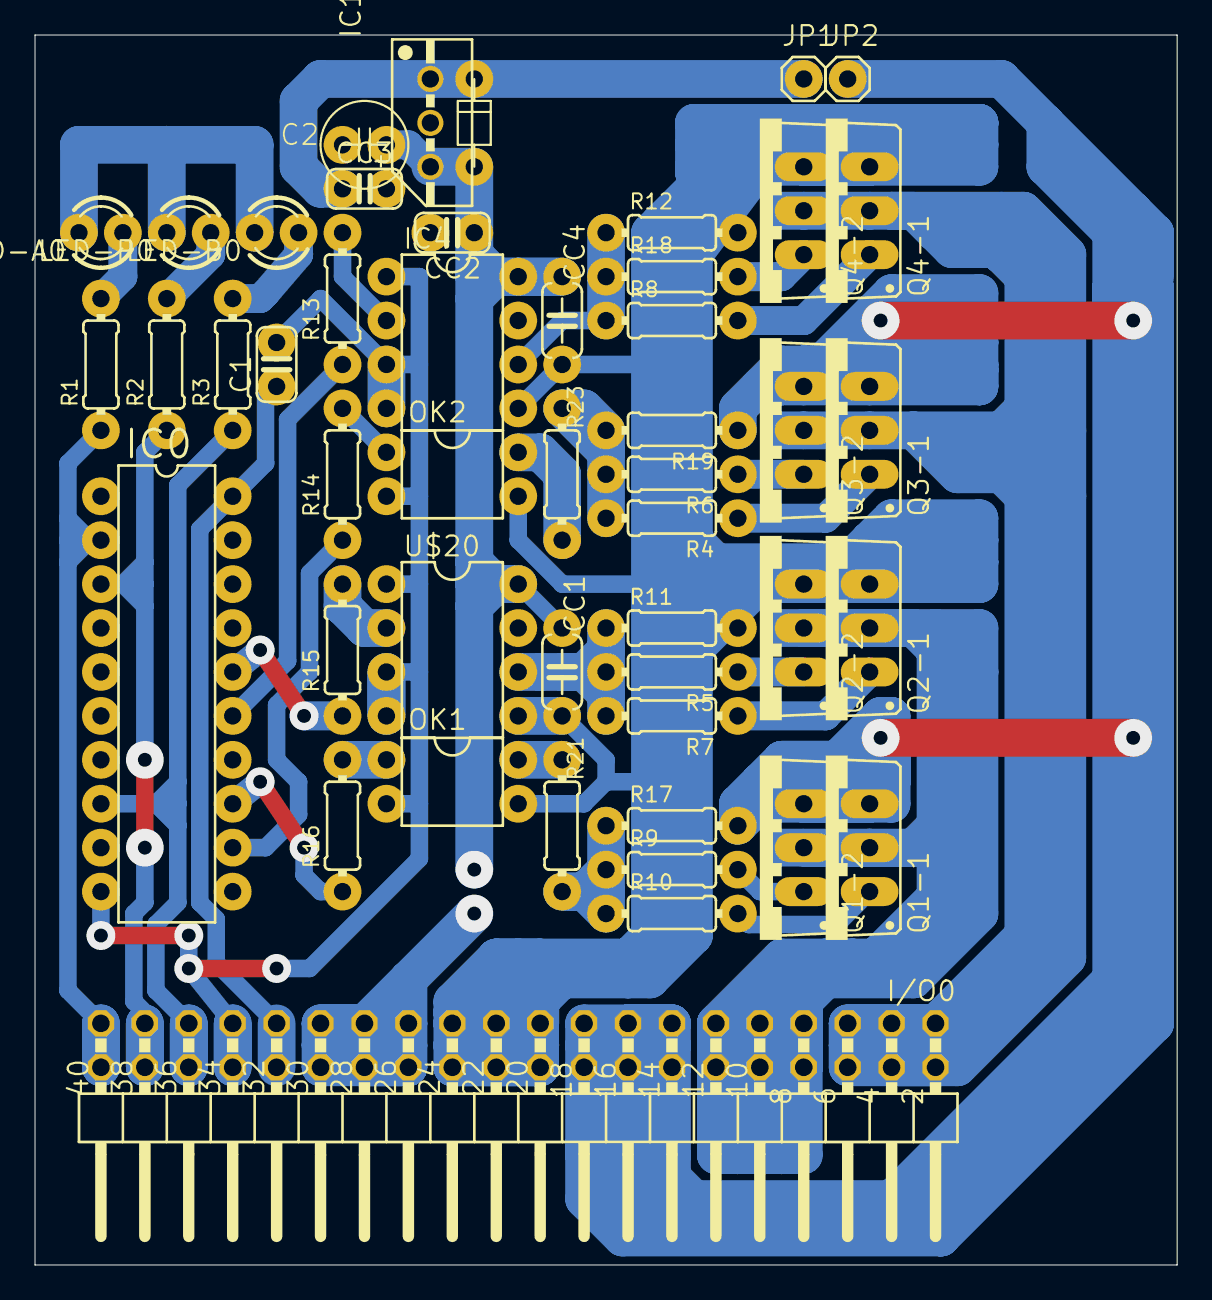
[picture p89: board md2014_norm_PN_04.kicad_pcb from above]

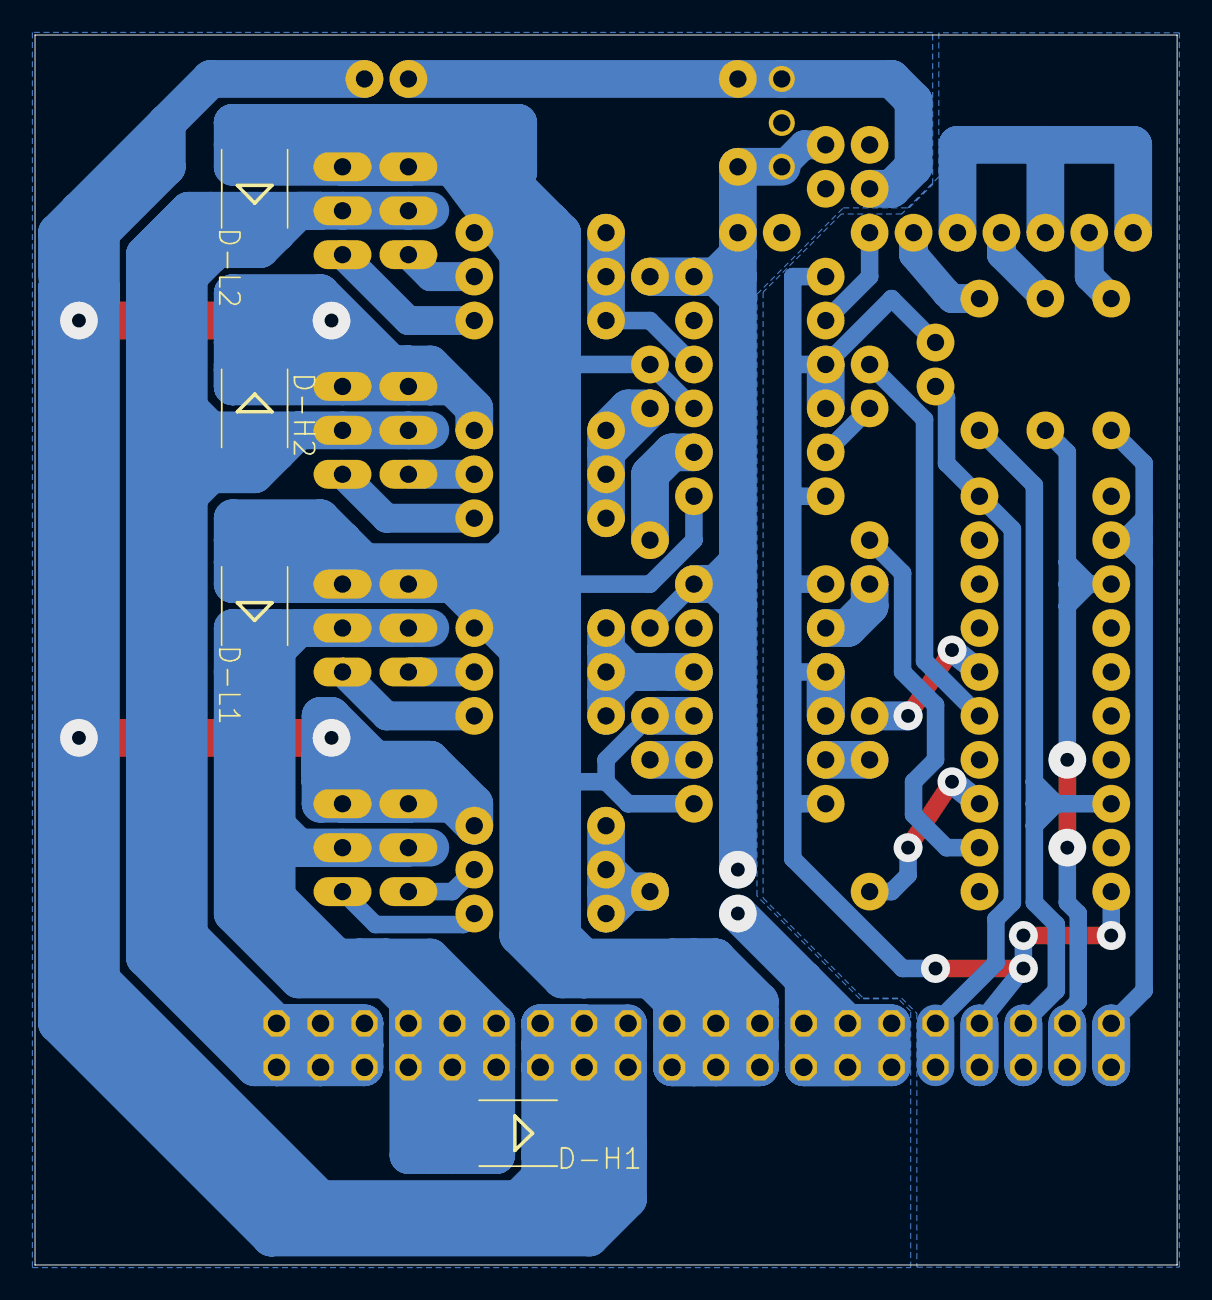
[picture p90: board md2014_norm_PN_04.kicad_pcb from below]

Board: 16 copper layers, 66.0 x 71.1 mm, 52 parts (4 on the bottom side), 37 nets.

Parts:
C1: 0.1uF; MLCC_25
C2: C_1U
CC1, CC4: 0.1uF; MLCC_50
CC2, CC3: 0.1uF; MLCC_25
D1: DIODE_3
D-H1, D-H2: SMB
D-L1, D-L2: SMB
I/O0: MA20-2W
IC0: ATtiny2313; DIL20
IC1: 78XX
IC4: TLP351; DIP8
JP1, JP2: 1X01
LED-A0: LED3MM
LED-B0: LED3MM
LED-P0: LED3MM
OK1, OK2: TLP621; DIP4
Q1-1, Q1-2: IRF4905; TO-220V
Q2-1, Q2-2, Q4-1, Q4-2: N; TO-220V
Q3-1, Q3-2: P; TO-220V
R1, R2, R3: 510; R_0.3
R4, R5, R6, R7, R8, R9, R10, R18: 100; R_0.3
R11, R12: 5.1k; R_0.3
R13, R14, R15, R16: 330; R_0.3
R17, R19, R21, R23: 2.2k; R_0.3
U$20: TLP251; DIP8

Connections:
+5V: C1.1, I/O0.31, I/O0.32, IC0.20
+12V: C2.P$1, CC1.1, CC2.1, CC4.1, D1.A, IC1.P$3, IC4.8, U$20.8
+24V: D-H1.C, D-H2.C, I/O0.13, I/O0.14, I/O0.15, I/O0.16, I/O0.17, I/O0.18, JP2.1, Q1-1.3, Q1-2.3, Q3-1.3, Q3-2.3, R17.2, R19.1
A-OUT: D-H2.A, D-L2.C, I/O0.1, I/O0.2, I/O0.3, I/O0.4, I/O0.5, I/O0.6, Q3-1.2, Q3-2.2, Q4-1.2, Q4-2.2
A-SIG: I/O0.39, I/O0.40, IC0.2, R1.1
B-OUT: D-H1.A, D-L1.C, I/O0.7, I/O0.8, I/O0.9, I/O0.10, I/O0.11, I/O0.12, Q1-1.2, Q1-2.2, Q2-1.2, Q2-2.2
B-SIG: I/O0.35, I/O0.36, IC0.8, R3.1
GND: C1.2, I/O0.33, I/O0.34, IC0.10, IC4.1, IC4.3, IC4.4, LED-A0.K, LED-B0.K, LED-P0.K, OK1.2, OK2.2, U$20.1, U$20.3, U$20.4
GND12: C2.P$2, CC1.2, CC2.2, CC3.2, CC4.2, D-L1.A, D-L2.A, I/O0.19, I/O0.20, I/O0.21, I/O0.22, I/O0.23, I/O0.24, IC1.P$2, IC4.5, OK1.3, OK2.3, Q2-1.3, Q2-2.3, Q4-1.3, Q4-2.3, R11.2, R12.2, U$20.5
H1: IC0.13, R16.1
H2: IC0.12, R14.1
L1: IC0.16, R15.1
L2: IC0.15, R13.1
unnamed: Q2-2.1, R5.1
unnamed: OK1.4, R21.1
unnamed: Q1-1.1, R10.2
unnamed: LED-P0.A, R2.2
unnamed: LED-A0.A, R1.2
unnamed: OK2.4, R23.2
unnamed: IC4.2, R13.2
unnamed: Q4-2.1, R18.2
unnamed: I/O0.25, I/O0.26, I/O0.27, I/O0.28, I/O0.29, I/O0.30
unnamed: Q2-1.1, R7.1
unnamed: Q4-1.1, R8.2
unnamed: R5.2, R7.2, R11.1, U$20.6
unnamed: R9.1, R10.1, R17.1, R21.2
unnamed: IC4.6, R8.1, R12.1, R18.1
unnamed: CC3.1, D1.C, IC1.P$1, JP1.1
unnamed: R4.2, R6.2, R19.2, R23.1
unnamed: Q3-2.1, R6.1
unnamed: OK1.1, R16.2
unnamed: Q1-2.1, R9.2
unnamed: LED-B0.A, R3.2
unnamed: Q3-1.1, R4.1
unnamed: OK2.1, R14.2
unnamed: R15.2, U$20.2
P-SIG: I/O0.37, I/O0.38, IC0.3, R2.1
