SkenHub/2023_Robocon_Bteam/回路/MD4/MD4.brd

## EAGLE design 回路/MD4/MD4.brd (2023-10-10)

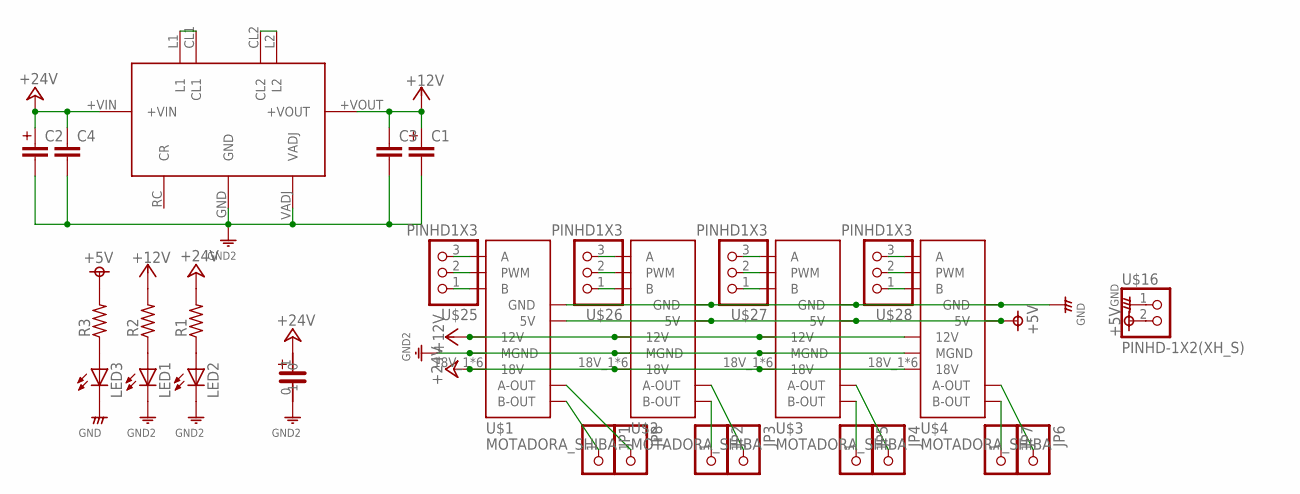
[picture p91: schematic MD4.sch]

Parts:
C1, C2: CAPACITOR-1U; C_1U
C3, C4: MLCC-5; MLCC_50
CAPACITOR1: CAPACITOR
JP1, JP2, JP3, JP4, JP5, JP6, JP7, JP8: PINHD-1X1; 1X01
LED1, LED2, LED3: LED3MM
R1, R2, R3: RESISTORS-3; R_0.3
U$1, U$2, U$3, U$4: MOTADORA_SHIBA
U$10: HPH12002M
U$16: PINHD-1X2(XH_S); 1X2(XH-S)
U$25, U$26, U$27, U$28: PINHD1X3; 1X3(XH)

Connections:
+5V: R3.2, U$1.5V, U$1.5V_2 (5V), U$2.5V, U$2.5V_2 (5V), U$3.5V, U$3.5V_2 (5V), U$4.5V, U$4.5V_2 (5V), U$16.2
+12V: C1.P$1 (1), C3.1, R2.2, U$1.12V_1 (12V), U$1.12V_2 (12V), U$1.12V_3 (12V), U$1.12V_4 (12V), U$1.12V_5 (12V), U$1.12V_6 (12V), U$2.12V_1 (12V), U$2.12V_2 (12V), U$2.12V_3 (12V), U$2.12V_4 (12V), U$2.12V_5 (12V), U$2.12V_6 (12V), U$3.12V_1 (12V), U$3.12V_2 (12V), U$3.12V_3 (12V), U$3.12V_4 (12V), U$3.12V_5 (12V), U$3.12V_6 (12V), U$4.12V_1 (12V), U$4.12V_2 (12V), U$4.12V_3 (12V), U$4.12V_4 (12V), U$4.12V_5 (12V), U$4.12V_6 (12V), U$10.+VOUT
GND: LED3.K (C), U$1.GND, U$1.GND2 (GND), U$2.GND, U$2.GND2 (GND), U$3.GND, U$3.GND2 (GND), U$4.GND, U$4.GND2 (GND), U$16.1
GND12: C1.P$2 (2), C2.P$2 (2), C3.2, C4.2, CAPACITOR1.0, LED1.K (C), LED2.K (C), U$1.MGND_1 (MGND), U$1.MGND_2 (MGND), U$1.MGND_3 (MGND), U$1.MGND_4 (MGND), U$1.MGND_5 (MGND), U$1.MGND_6 (MGND), U$2.MGND_1 (MGND), U$2.MGND_2 (MGND), U$2.MGND_3 (MGND), U$2.MGND_4 (MGND), U$2.MGND_5 (MGND), U$2.MGND_6 (MGND), U$3.MGND_1 (MGND), U$3.MGND_2 (MGND), U$3.MGND_3 (MGND), U$3.MGND_4 (MGND), U$3.MGND_5 (MGND), U$3.MGND_6 (MGND), U$4.MGND_1 (MGND), U$4.MGND_2 (MGND), U$4.MGND_3 (MGND), U$4.MGND_4 (MGND), U$4.MGND_5 (MGND), U$4.MGND_6 (MGND), U$10.GND, U$10.VADJ
unnamed: JP1.1, U$1.B-OUT_1 (B-OUT), U$1.B-OUT_2 (B-OUT), U$1.B-OUT_3 (B-OUT), U$1.B-OUT_4 (B-OUT), U$1.B-OUT_5 (B-OUT), U$1.B-OUT_6 (B-OUT)
unnamed: JP3.1, U$2.A-OUT_1 (A-OUT), U$2.A-OUT_2 (A-OUT), U$2.A-OUT_3 (A-OUT), U$2.A-OUT_4 (A-OUT), U$2.A-OUT_5 (A-OUT), U$2.A-OUT_6 (A-OUT)
unnamed: JP4.1, U$3.A-OUT_1 (A-OUT), U$3.A-OUT_2 (A-OUT), U$3.A-OUT_3 (A-OUT), U$3.A-OUT_4 (A-OUT), U$3.A-OUT_5 (A-OUT), U$3.A-OUT_6 (A-OUT)
unnamed: JP5.1, U$3.B-OUT_1 (B-OUT), U$3.B-OUT_2 (B-OUT), U$3.B-OUT_3 (B-OUT), U$3.B-OUT_4 (B-OUT), U$3.B-OUT_5 (B-OUT), U$3.B-OUT_6 (B-OUT)
unnamed: JP7.1, U$4.B-OUT_1 (B-OUT), U$4.B-OUT_2 (B-OUT), U$4.B-OUT_3 (B-OUT), U$4.B-OUT_4 (B-OUT), U$4.B-OUT_5 (B-OUT), U$4.B-OUT_6 (B-OUT)
unnamed: JP8.1, U$1.A-OUT_1 (A-OUT), U$1.A-OUT_2 (A-OUT), U$1.A-OUT_3 (A-OUT), U$1.A-OUT_4 (A-OUT), U$1.A-OUT_5 (A-OUT), U$1.A-OUT_6 (A-OUT)
unnamed: U$1.B, U$1.B2 (B), U$25.1
unnamed: U$1.PWM, U$1.PWM2 (PWM), U$25.2
unnamed: U$1.A, U$1.A2 (A), U$25.3
unnamed: U$2.B, U$2.B2 (B), U$26.1
unnamed: U$2.PWM, U$2.PWM2 (PWM), U$26.2
unnamed: U$2.A, U$2.A2 (A), U$26.3
unnamed: U$3.B, U$3.B2 (B), U$27.1
unnamed: U$3.PWM, U$3.PWM2 (PWM), U$27.2
unnamed: U$3.A, U$3.A2 (A), U$27.3
unnamed: U$4.B, U$4.B2 (B), U$28.1
unnamed: U$4.PWM, U$4.PWM2 (PWM), U$28.2
unnamed: U$4.A, U$4.A2 (A), U$28.3
unnamed: LED2.A, R1.1
unnamed: U$10.CL2, U$10.L2
unnamed: U$10.CL1, U$10.L1
unnamed: LED1.A, R2.1
unnamed: LED3.A, R3.1
unnamed: JP6.1, U$4.A-OUT_1 (A-OUT), U$4.A-OUT_2 (A-OUT), U$4.A-OUT_3 (A-OUT), U$4.A-OUT_4 (A-OUT), U$4.A-OUT_5 (A-OUT), U$4.A-OUT_6 (A-OUT)
unnamed: JP2.1, U$2.B-OUT_1 (B-OUT), U$2.B-OUT_2 (B-OUT), U$2.B-OUT_3 (B-OUT), U$2.B-OUT_4 (B-OUT), U$2.B-OUT_5 (B-OUT), U$2.B-OUT_6 (B-OUT)
unnamed: C2.P$1 (1), C4.1, CAPACITOR1.1, R1.2, U$1.18V_1 (18V), U$1.18V_2 (18V), U$1.18V_3 (18V), U$1.18V_4 (18V), U$1.18V_5 (18V), U$1.18V_6 (18V), U$2.18V_1 (18V), U$2.18V_2 (18V), U$2.18V_3 (18V), U$2.18V_4 (18V), U$2.18V_5 (18V), U$2.18V_6 (18V), U$3.18V_1 (18V), U$3.18V_2 (18V), U$3.18V_3 (18V), U$3.18V_4 (18V), U$3.18V_5 (18V), U$3.18V_6 (18V), U$4.18V_1 (18V), U$4.18V_2 (18V), U$4.18V_3 (18V), U$4.18V_4 (18V), U$4.18V_5 (18V), U$4.18V_6 (18V), U$10.+VIN

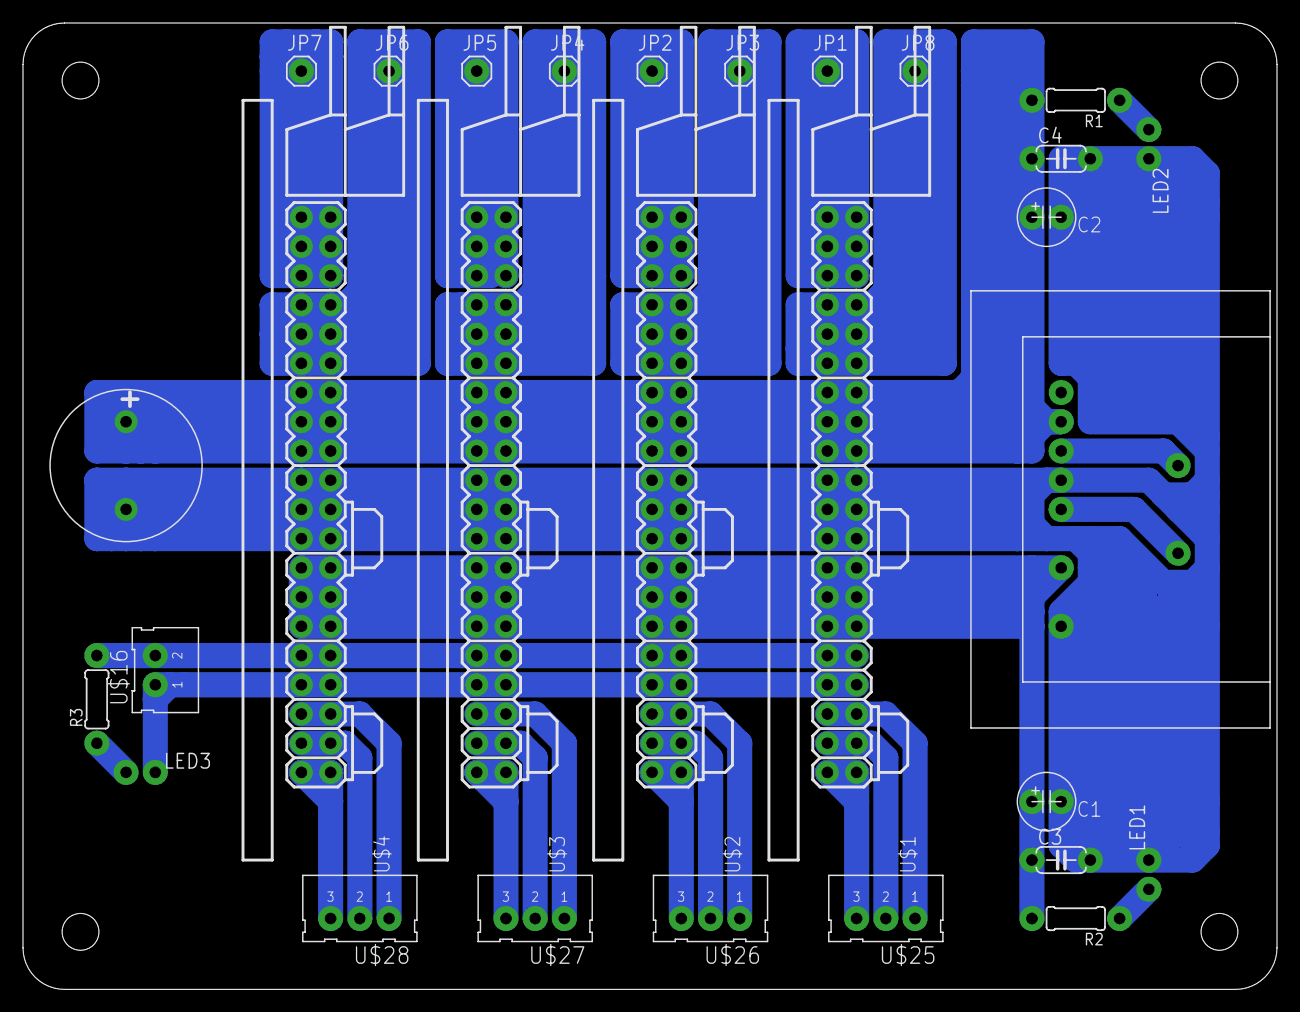
[picture p92: board MD4.brd from above]

Board: 2 copper layers, 109.0 x 84.0 mm, 29 parts (0 on the bottom side), 30 nets.
