SkenHub/2023_Robocon_Bteam/回路/main/メイン2.brd

## EAGLE design 回路/main/メイン2.brd (2023-10-10)

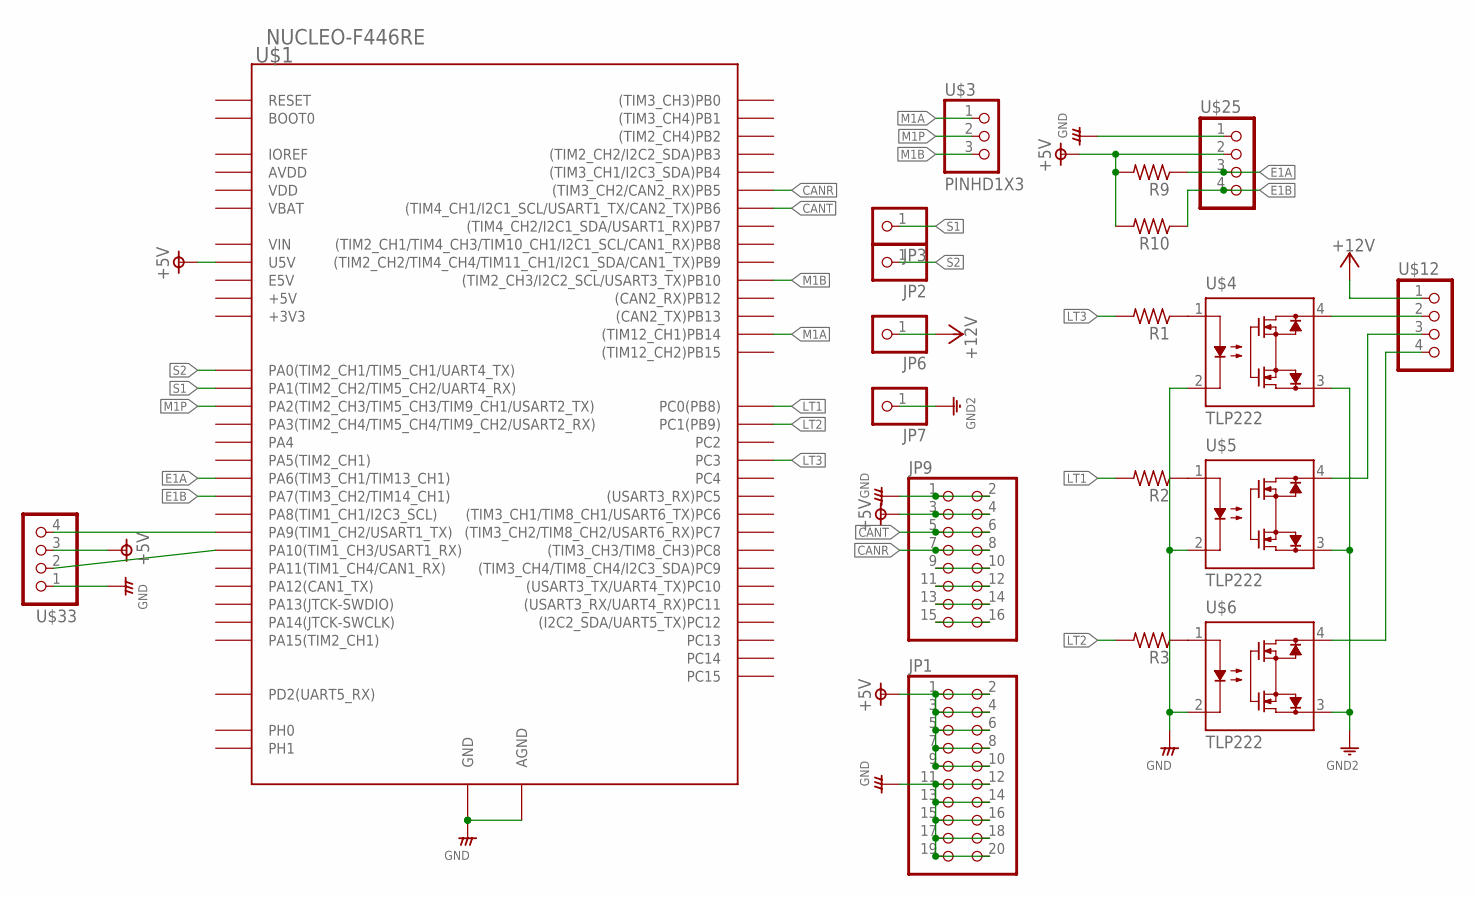
[picture p93: schematic メイン2.sch]

Parts:
JP1: PINHD-2X10; 2X10
JP2, JP3, JP6, JP7: PINHD-1X1; 1X01
JP9: PINHD-2X8; 2X08
R1, R2, R3, R9, R10: RESISTORS-3; R_0.3
U$1: NUCLEO-F446RE; NUCLEO-F（L）ｘｘｘRｘ
U$3: PINHD1X3; 1X3(XH)
U$4, U$5, U$6: TLP222; DIP4
U$12, U$25, U$33: XH-PIN4; XH-4PIN

Connections:
+5V: JP1.1, JP1.2, JP1.3, JP1.4, JP1.5, JP1.6, JP1.7, JP1.8, JP1.9, JP1.10, JP9.3, JP9.4, R9.2, R10.2, U$1.U5V, U$25.2, U$33.3
+12V: JP6.1, U$12.1
CANR: JP9.7, JP9.8, U$1.PB5 ((TIM3_CH2/CAN2_RX)PB5)
CANT: JP9.5, JP9.6, U$1.PB6 ((TIM4_CH1/I2C1_SCL/USART1_TX/CAN2_TX)PB6)
E1A: R9.1, U$1.PA6 (PA6(TIM3_CH1/TIM13_CH1)), U$25.3
E1B: R10.1, U$1.PA7 (PA7(TIM3_CH2/TIM14_CH1)), U$25.4
GND: JP1.11, JP1.12, JP1.13, JP1.14, JP1.15, JP1.16, JP1.17, JP1.18, JP1.19, JP1.20, JP9.1, JP9.2, U$1.AGND, U$1.GND@1 (GND), U$1.GND@2 (GND), U$1.GND@3 (GND), U$1.GND@4 (GND), U$1.GND@5 (GND), U$1.GND@6 (GND), U$4.2 (2CATHODE), U$5.2 (2CATHODE), U$6.2 (2CATHODE), U$25.1, U$33.1
GND12: JP7.1, U$4.3 (3DRAIN), U$5.3 (3DRAIN), U$6.3 (3DRAIN)
LT1: R2.2, U$1.PC0 (PC0(PB8))
LT2: R3.2, U$1.PC1 (PC1(PB9))
LT3: R1.2, U$1.PC3
M1A: U$1.PB14 ((TIM12_CH1)PB14), U$3.1
M1B: U$1.PB10 ((TIM2_CH3/I2C2_SCL/USART3_TX)PB10), U$3.3
M1P: U$1.PA2 (PA2(TIM2_CH3/TIM5_CH3/TIM9_CH1/USART2_T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), U$3.2
unnamed: U$1.PA10 (PA10(TIM1_CH3/USART1_RX)), U$33.2
unnamed: U$1.PA9 (PA9(TIM1_CH2/USART1_TX)), U$33.4
unnamed: U$4.4 (4DRAIN), U$12.2
unnamed: U$5.4 (4DRAIN), U$12.3
unnamed: U$6.4 (4DRAIN), U$12.4
unnamed: JP9.9, JP9.10
unnamed: JP9.11, JP9.12
unnamed: JP9.13, JP9.14
unnamed: JP9.15, JP9.16
unnamed: R1.1, U$4.1 (1ANODE)
unnamed: R2.1, U$5.1 (1ANODE)
unnamed: R3.1, U$6.1 (1ANODE)
S1: JP3.1, U$1.PA1 (PA1(TIM2_CH2/TIM5_CH2/UART4_RX))
S2: JP2.1, U$1.PA0 (PA0(TIM2_CH1/TIM5_CH1/UART4_TX))

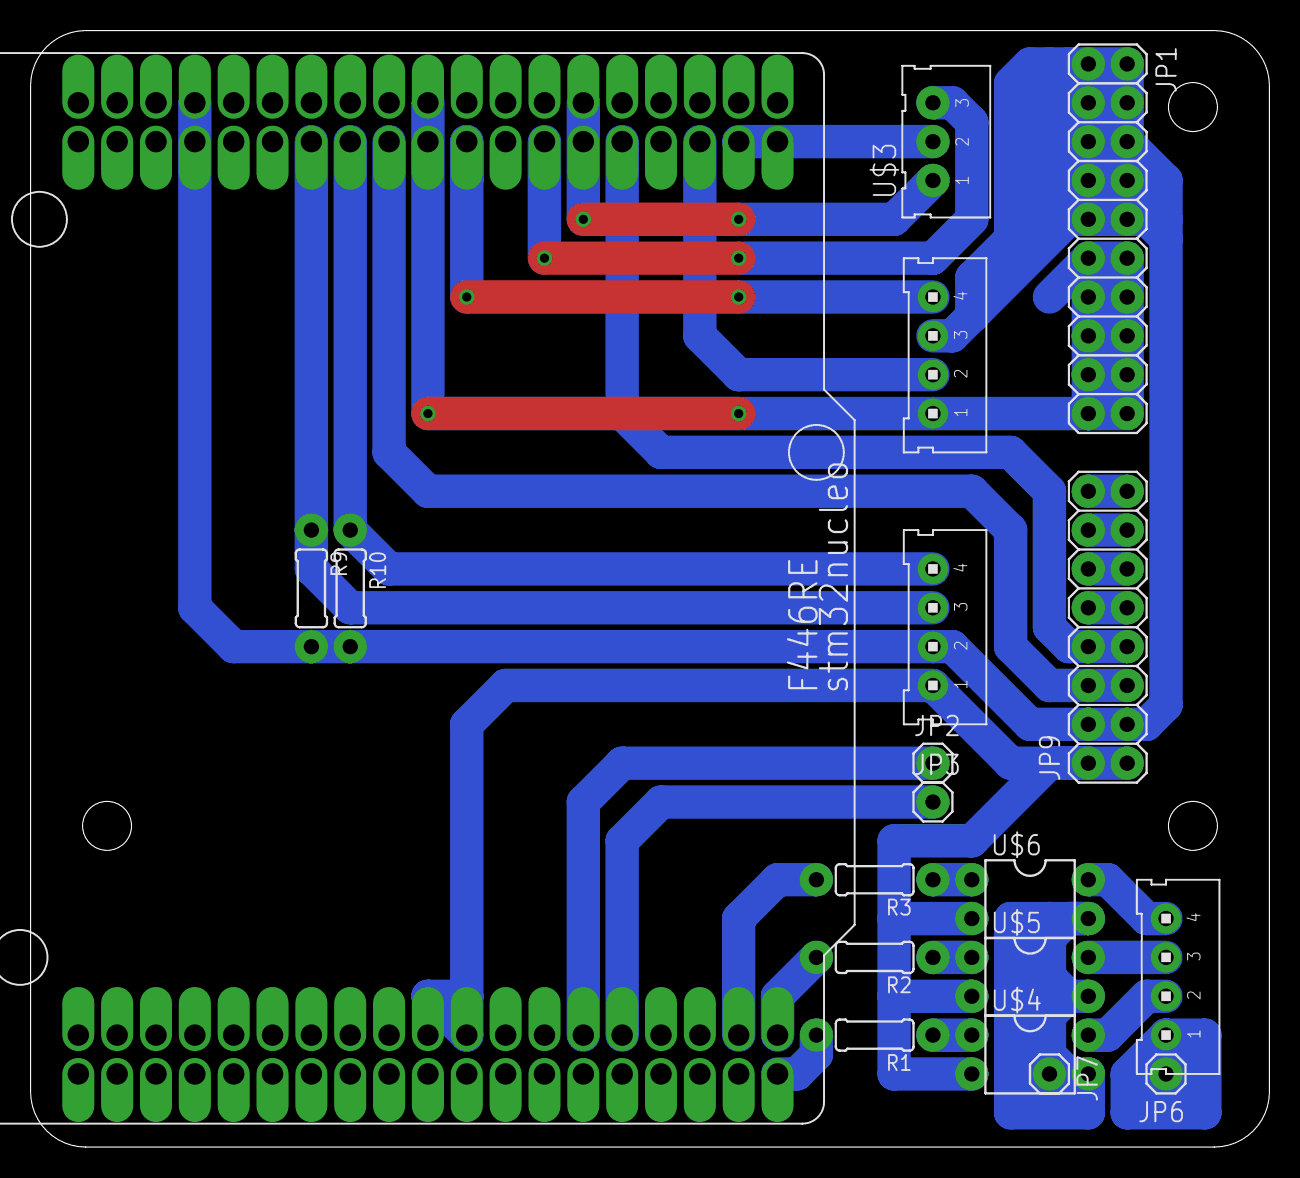
[picture p94: board メイン2.brd from above]

Board: 2 copper layers, 81.0 x 73.0 mm, 19 parts (0 on the bottom side), 28 nets.
