SkenHub/2023_Robocon_Bteam/回路/降圧/降圧.brd

## EAGLE design 回路/降圧/降圧.brd (2023-10-10)

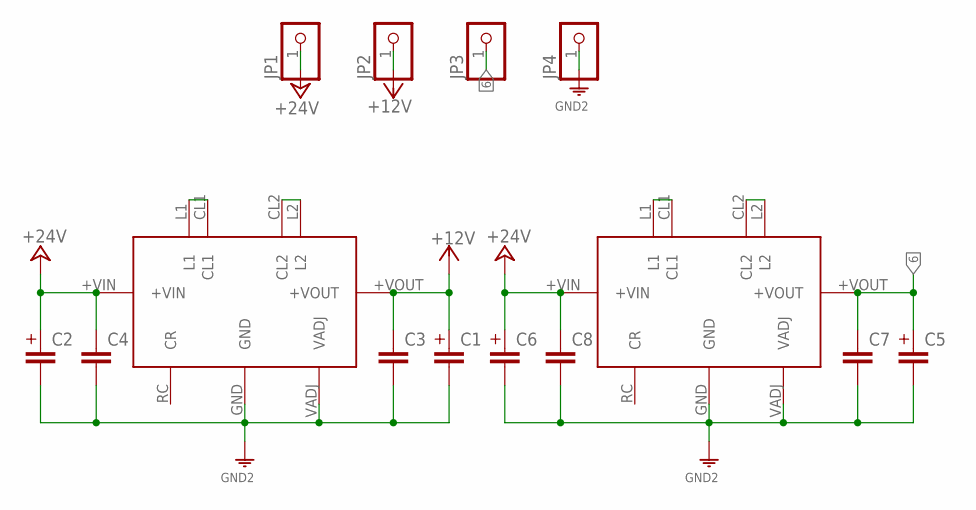
[picture p95: schematic 降圧.sch]

Parts:
C1, C2, C5, C6: CAPACITOR-1U; C_1U
C3, C4, C7, C8: MLCC-5; MLCC_50
JP1, JP2, JP3, JP4: PINHD-1X1; 1X01
U$1, U$4: HPH12002M

Connections:
6: C5.P$1 (1), C7.1, JP3.1, U$4.+VOUT
+12V: C1.P$1 (1), C3.1, JP2.1, U$1.+VOUT
+24V: C2.P$1 (1), C4.1, C6.P$1 (1), C8.1, JP1.1, U$1.+VIN, U$4.+VIN
GND: C1.P$2 (2), C2.P$2 (2), C3.2, C4.2, C5.P$2 (2), C6.P$2 (2), C7.2, C8.2, JP4.1, U$1.GND, U$1.VADJ, U$4.GND, U$4.VADJ
unnamed: U$1.CL1, U$1.L1
unnamed: U$1.CL2, U$1.L2
unnamed: U$4.CL1, U$4.L1
unnamed: U$4.CL2, U$4.L2

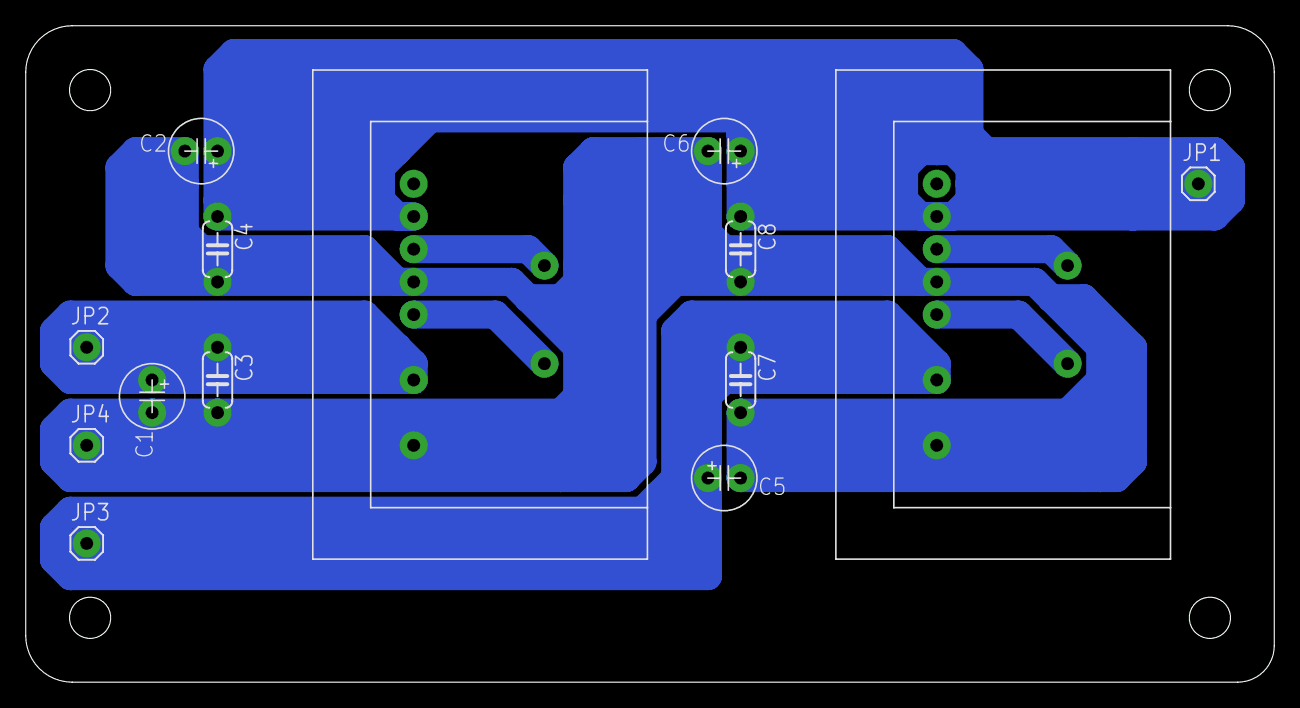
[picture p96: board 降圧.brd from above]

Board: 2 copper layers, 97.0 x 51.0 mm, 14 parts (0 on the bottom side), 8 nets.
