SkenHub/2023_Robocon_Bteam/制御/esp32cam_ss/camera_index.h

//File: index_ov2640.html.gz, Size: 6906  htmlファイルをgzに圧縮して16進数に変換した物 6906は配列の要素数 改造したいときは7z入れてchatさんに聞きながらやって。
#define index_ov2640_html_gz_len 6906
const uint8_t index_ov2640_html_gz[] = {
0x1F,0x8B,0x08,0x08,0x00,0xF4,0xEB,0x64,0x04,0x00,0x69,0x6E,0x64,0x65,0x78,0x2E,0x68,0x74,0x6D,0x6C,0x00,0xED,0x1D,0xDB,0x6E,0xEB,0x44,0xF0,0x1D,0x89,0x7F,0xF0,0x09,0x70,0x92,0xA8,0x49,
0x9A,0x5B,0x7B,0x4A,0x4F,0x1B,0x2E,0x3D,0xE5,0x22,0x38,0xDC,0x0E,0x57,0x21,0x74,0x70,0xE2,0x4D,0x6A,0x70,0xEC,0x60,0x3B,0x4D,0x02,0xEA,0x03,0xF0,0xC4,0x17,0x20,0xC1,0x1B,0x6F,0x08,0x09,
0x09,0xF1,0x04,0xE2,0x8D,0x4F,0x41,0xFC,0x07,0x33,0x7B,0xF1,0xFA,0x16,0x7B,0xED,0xA4,0x0D,0xB7,0x1E,0x68,0xED,0xF5,0xCC,0xEC,0xEC,0xCC,0xEC,0xEC,0xEC,0xEC,0xAE,0xFD,0xE8,0x23,0x27,0xB7,
0x0C,0x67,0xE4,0xAF,0x66,0x44,0xBB,0xF0,0xA7,0xD6,0x00,0x0A,0xF8,0x5F,0x0D,0x7E,0x4E,0x2E,0x88,0x6E,0xF0,0x6B,0x7A,0x3F,0x25,0xBE,0xAE,0x8D,0x2E,0x74,0xD7,0x23,0xFE,0x69,0x65,0xEE,0x8F,
0x9B,0x47,0x95,0xC4,0x73,0x5B,0x9F,0x92,0xD3,0xCA,0xA5,0x49,0x16,0x33,0xC7,0xF5,0x2B,0xDA,0xC8,0xB1,0x7D,0x62,0x03,0xFC,0xC2,0x34,0xFC,0x8B,0x53,0x83,0x5C,0x9A,0x23,0xD2,0xA4,0x37,0x0D,
0xD3,0x36,0x7D,0x53,0xB7,0x9A,0xDE,0x48,0xB7,0xC8,0x69,0x27,0x42,0xCC,0x37,0x7D,0x8B,0x0C,0x88,0x37,0xEB,0x75,0x47,0x40,0xD2,0xD5,0x1F,0x7A,0xDE,0xC9,0x3E,0x2D,0x0D,0x83,0x79,0xFE,0x8A,
0x17,0xC8,0x9F,0xA1,0x63,0xAC,0xB4,0xCF,0x44,0x99,0xFC,0x19,0x03,0x2B,0xCD,0xB1,0x3E,0x35,0xAD,0xD5,0xB1,0xF6,0x8C,0x0B,0x35,0x37,0x5E,0x20,0xD6,0x25,0xF1,0xCD,0x91,0xDE,0xF0,0x74,0xDB,
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
 0x8F, 0xB5, 0x86, 0xE3, 0x9A, 0xE0, 0x08, 0x06, 0x0D, 0x37, 0x16, 0x5C, 0x81, 0x81, 0x63, 0x41,
 0xF6, 0x24, 0x2C, 0x67, 0xF8, 0x8C, 0x28, 0x11, 0xB9, 0xDB, 0xE0, 0x4F, 0x21, 0xE4, 0xE0, 0x2F,
 0xD7, 0x81, 0x24, 0x3C, 0x52, 0xF4, 0x59, 0xFA, 0x12, 0x29, 0x4C, 0xD3, 0x19, 0xFE, 0xE6, 0xC6,
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
};
