SkenHub/2023_Robocon_Bteam/制御/robocon2023_BteamRobot/inc/sken_library/include.h

/*
 * include.h
 *
 *  Created on: 2019/09/03
 *      Author: takum
 */

#ifndef INCLUDE_H_
#define INCLUDE_H_

#include "system.h"
#include "io_name.h"
#include "gpio.h"
#include "uart.h"
#include "encoder.h"
#include "can.h"
#include "adc.h"
#include "gyro.h"
#include "pid.h"
#include "rc_pwm.h"
#include "debugger.h"
#include "Motor.h"
#include "PS3.h"
#include "I2C.h"
#include "IM920.h"
#include "sken_mdd.h"

#endif /* INCLUDE_H_ */
