SkenHub/2023_Robocon_Bteam/(commit log)

2023-06-08 Create 機械
2023-06-08 Add files via upload
    ジャイロセンサー プログラム
2023-06-08 realsenseロボットのテストプログラム
    ロボットの旋回中心とrealsenseの中心の差を考慮
2023-06-08 テストロボット（足回り）のプログラム
    [robocon2023TestRobot Run.cfg]
2023-06-25 Create LED
2023-06-30 ヨー軸のシリアル通信出力
    ヨー軸の実数値（０～360度）を共用体で4バイト出力．
    先頭2バイトはHEX A0A0 で計6バイト
2023-06-30 Update wit901_1.ino
    oledディスプレイ搭載
2023-06-30 Update wit901_1.ino
    エラー修正
2023-06-30 Update wit901_1.ino
    表示をええ感じに
2023-06-30 パワーウィンドウからメカナムへ変更
2023-07-08 メカナム足回り
    PS3はSBDBTを使ってね
2023-08-20 完成形足回りプログラム
    [robocon2023TestRobot2 Run.cfg]
2023-08-27 収穫機構プログラムVer3制作
2023-08-30 get_V3のパラメータ調整
2023-10-03 足回りプログラム完成版
    [robocon2023_BteamRobot Run.cfg]
2023-10-03 ルールブックとFAQ
2023-10-05 足回りプログラム更新
    146行目の数字がモータのpwmだよ
2023-10-11 鋼鶴天翔の完成形
    改善の余地あり(悪足掻き)
